LLAB1234567890/PCB-/reports/接线与固件契约.md

# 接线、控制意图与固件契约（未实施固件）

依据V3.2 2L原生针网，PCB SHA `7d6288a3e79992e387e95aa80c018b5a480a0d5dae67df03d6c3de5389c8f986`。

|端子|实际针序（顺序不能按名称猜）|

|---|---|

|J1|1: +24V_IN；2: GND|

|J13|1: +6V5_LIM_A；2: LIM_LC_RET|

|J14|1: +6V5_LIM_B；2: LIM_RC_RET|

|J15|1: +6V5_LIM_B；2: LIM_RO_RET|

|J18|1: +24V_CTRL；2: FUNC_BTN_RET；3: FUNC_LED_A；4: FUNC_LED_K|

|J19|1: +5V_MCU_FEED；2: +5V_MCU|

|J3|1: +6V5_LIM_A；2: LIM_LO_RET|

|U18|1: +5V_CTRL；2: MOTOR_PUL_N；3: +5V_CTRL|

|U19|1: MOTOR_DIR_N；2: +5V_CTRL；3: MOTOR_ENA_N|

|U20|1: MOTOR_ALM_RAW；2: GND|

|U21|1: +24V_CTRL；2: BTN_OPEN_SW|

|U22|1: +24V_CTRL；2: STOP_NC_RET|

|U23|1: +24V_CTRL；2: BTN_CLOSE_SW|

|U24|1: +24V_ESTOP_NC；2: GND|

|U30|1: +3V3；2: GND；3: I2C_SDA_EXT；4: I2C_SCL_EXT|

四路SS-01GL2使用COM/NC，LO/RO为OPEN边界，LC/RC为CLOSE边界；另一方向允许退离。NC打开不能区分触发和断线。两只备用不开第五/第六功能通道。

Gravity SEN0228的SDA/SCL/GND/VCC要与U30 VCC/GND/SDA/SCL逐针对应，使用3.3V；不能顺序直插。I2C100kHz，测总电容≤400pF、上升沿≤1µs和低电平，未知线长使用现场验收。

SET J18以自复位NO读取，NC未用端子绝缘。24V红灯电流20/50mA仅是建模包络；实物确认后填写。BZ1为内部5V有源KLJ-9650-5Y，30mA上界。

J16默认1–2接GND方向选择；J17默认1–2接3.3V报警选择。按实际驱动配置核验，CL1-42C报警PA4.01/PA4.31与ENA脱机极性须先低速/无机械负载测出；不得靠标签猜方向。

GST120A24-P1M控制支路给PCB；驱动正电源经板外K1 NO切断，驱动负极独立回源负极。相线及编码器接CL1-42C，不经过PCB。PUL/DIR/ENA采用板输出低侧与5V共阳极成对线束。

板外K1:Omron G2R-1-S DC24+P2RFZ-05-E，4COM、3NO、2NC未用、1/5线圈。电机5A支路0297005.WXMX+0FHM0001SXJ；线圈1A支路0287001.PXCN+0FHA0001ZXJ经急停NC控制K1.5与U24.1，K1.1独立回负极，SMBJ26CA线圈钳位。线圈约21.6mA/0.53W；容性输入冲击、真实分断/焊接与停止距离未验收。

GPIO初始化先禁止STEP、ARM保持LOW、灯和蜂鸣器按已定义默认值，再建立有效心跳、读取稳定监督和方向限位。新ARM LOW→HIGH后运动期间保持GPIO6 HIGH。STOP/故障/应用停更停止脉冲并清授权；恢复HIGH保持不得自动再ARM。

GPIO47心跳由应用控制任务维护，≤50ms更新/≤100ms有效下降沿；无独立硬件/ISR假健康。通信租约失效、状态陈旧或校准异常时停止喂狗。EN控制U45，不把WDT_OK接成直接ESP复位。

STEP≤100kHz、HIGH/LOW≥5µs；DIR setup≥10µs；ENA settle≥5ms。170～230ms看门狗时窗不是立即停机；任何位置不可信的截脉冲/掉电后回零或行程重新校准。

GPIO35–37供PSRAM，GPIO38板载RGB，GPIO19/20用于USB，GPIO0/3/45/46引导功能保留；实际44针CSV为权威针序。SET物理长按配对和行程校准的阈值/状态机尚未实现，不能伪称运行通过。

J19在使用普通USB供电前断开，避免双5V并联；带负载波形在U2.21对U2.22和本地3.3V量取。使用电源分配点承担驱动功率回流，布线远离电机相线。
