LLAB1234567890/PCB-/reports/样机测量步骤与判据.md

# V3.2 2L 样机测量步骤与判据

全部未执行。固件尚未编写，先实现“接线与固件契约.md”的启动、GPIO、STEP/DIR/HOLD、应用心跳及重新 ARM 行为，再记录“样机验收表.csv”。本文件给出可复核测量步骤，不把离线真值、热模型或厂商绝对最大值当作实测通过。

## 1. 装配、未上电与首电

按 CPL 的面/角度核对 pin1、D9/TVS/光耦/MOS/逻辑极性；确认 CASE_U1/U11/U33 相互与 GND 不短路。确认所有电源端子线序、NC COM接线、驱动 ALM 极性与 J16/J17 配置。检查底部支撑接触区、插件尾脚、USB 插头、按钮后端、2–3 mm垫片、螺丝啮合、工具通道；实测尺寸填表，不能用可调包络当已适配。

首次使用限流电源先只接控制支路，运动授权保持清除；由待机电流逐步提高限流值至实际负载需要，记录每级电流，不猜定额。分别测 U1 输入/输出、U2.21对U2.22、本地3.3 V 和 U41/U44 输出；再接外部驱动和线束。电机相线/编码器直接接 CL1-42C，驱动负极单独回电源分配点，不通过 PCB 信号地承担功率电流。普通 USB 供电前断开 J19，禁止双5 V并联。

## 2. 电源、监督与温升

示波器探头短地弹簧或差分测量，以本地地脚为参照；同时记录 U1.3、U2.21、本地3.3 V 的最小值、纹波及启动/无线/灯/蜂鸣器瞬态，记录输入电压与负载电流。需要测量 PCB 回流和 J19、D9、母座接触压降，不能只量正线。

0.5 A 是本轮计算包络，不是对实际 ESP32 峰值的承诺。实测电流、接触、温度和瞬态超出包络后重算 ../shared/DC_sheet_comparison.json 与工程报告中的电压预算。3.3 V 须处于实际器件推荐范围，正常工作时不得误触 U41/U44；检验整段低压波形及监督阈值/延时。SGM2212 的厂商 dropout 定义为95%输出，并不保证在“3.3 V + dropout”下精确3.3 V；以实测调节、3.3 V 余量及器件推荐规格判定。0.8 A组合最坏余量不足，不能直接放行。

在24℃、无强迫风、顶部朝上敞开、实际盒内装配和已记录压力下，测待机、较重无线及灯/蜂鸣器持续工况，持续到温度稳定并记录时间序列。记录 U1/D9/LDO/ESP热点、DevKit邻近空气、腔内空气和 PA12；DevKit合并模型温度不能代替模块邻近环境或结温。记录测温贴片/热电偶位置、辐射率和仪器误差。与六个模型工况使用相同负载/边界作比较；无法实现的压力条件注明，不能写成通过。按实测物性/接触/功率校准参考范围后再判断温度和工作寿命。

## 3. 行为与故障序列

首先低速、轻负载验证实际 OPEN/CLOSE 与 J16、驱动 DIR 配置一致；测 STEP HIGH/LOW≥5µs、DIR设置≥10µs、ENA稳定≥5ms 的契约并记录实际控制频率。逐一触发 STOP、四个NC各在两个方向断线、ALM、3.3 V/5 V欠压、EN复位、WDI恒HIGH、停止有效下降沿、应用停更及失联。每次记录 STEP、RUN_CLR_N、WDT_OK、ENA及电机响应。

当前方向的 NC 断线清授权，反方向退出允许；这不是四路全方向断线检测。普通STOP/看门狗在健康电源与急停状态下应停止脉冲并保留保持力；实际转矩必须测量。有效下降沿才喂看门狗；GPIO47由活跃控制任务更新，不能靠自动外设或独立定时中断掩盖应用停更。分别测170～230ms配置窗口、ENOUT异步响应和触点弹跳/传播延迟；不能用抽象事件模型声称立即停止。

所有能清授权的故障解除后，GPIO6持续HIGH不得自动恢复；先LOW，再新HIGH边沿才ARM。检查异步截短脉冲和方向切换，位置可信性丢失须重新回零/校准。急停实际切断 K1 主触点的驱动正电源，记录接点冲击电流、触点温升和停止距离；U24仅证明线圈命令，不证明触点已断开。掉电不能保证保持力，单通道 K1 不构成认证安全控制。

## 4. 线束与抗扰

记录实际线长、线型、走向、端接和是否邻近电机线。电机/编码器已知延长线1.5 m，其余最长线长以实装为准。PUL/DIR/ENA分别与共阳极供电返回成对布线，限位/I2C远离相线。控制器连续运行时重复驱动启停/换向及按钮/NC操作，捕获RESET、WDI、WDT_OK、PUL和输入波形；不得出现无命令脉冲、错误ARM或授权自行恢复。记录复位次数、总线错误、输入毛刺和观察周期。

I2C先用100 kHz，在实际最长线测SDA/SCL上升沿、低电平和有效电容；检查串联100Ω及拉电阻后的 tr≤1µs，并按实际器件VOL/VIL推荐限值核对。未知米数线束不能直接宣称兼容。插拔/布线靠近干扰源的试验只能说明所记录配置；标准ESD/EFT/辐射/传导试验的等级、接线和仪器需另定，未做则保持“未执行”，不宣称认证抗扰。
