LLAB1234567890/PCB-/manufacturing/Drill_report.txt

Drill report for CurtainDrive_V3_2_2L.kicad_pcb
Created on 2026-10-04T09:53:25

Copper Layer Stackup:
    =============================================================
    L1 :  F.Cu                      front
    L2 :  B.Cu                      back

Drill file 'CurtainDrive_V3_2_2L-PTH.drl' contains
    plated through holes:
    =============================================================
    T1  0.300mm  0.0118"  (484 holes))
    T2  0.400mm  0.0157"  (3 holes))
    T3  0.914mm  0.0360"  (44 holes))
    T4  0.950mm  0.0374"  (4 holes))
    T5  1.000mm  0.0394"  (8 holes))
    T6  1.100mm  0.0433"  (6 holes)  (with 6 slots)
    T7  1.200mm  0.0472"  (9 holes))
    T8  1.300mm  0.0512"  (4 holes))
    T9  1.400mm  0.0551"  (26 holes))

    Total plated holes count 588

Drill file 'CurtainDrive_V3_2_2L-NPTH.drl' contains
    unplated through holes:
    =============================================================
    T1  2.700mm  0.1063"  (6 holes))

    Total unplated holes count 6
