LLAB1234567890/PCB-/mechanical/Enclosure_assembly.step

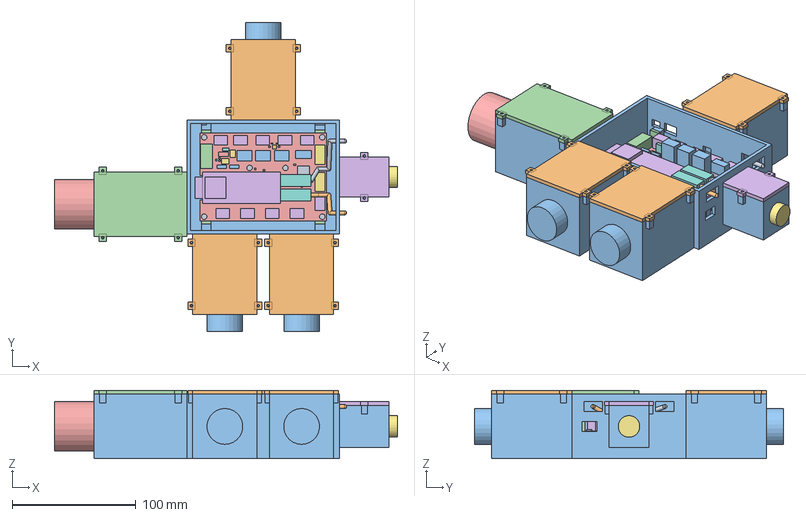
[picture p1: CAD file, 2026-10-04]
mechanical/Enclosure_assembly.step
277.3 x 250.1 x 55.1 mm
