LLAB1234567890/PCB-/mechanical/PA12_Main_and_pods.step

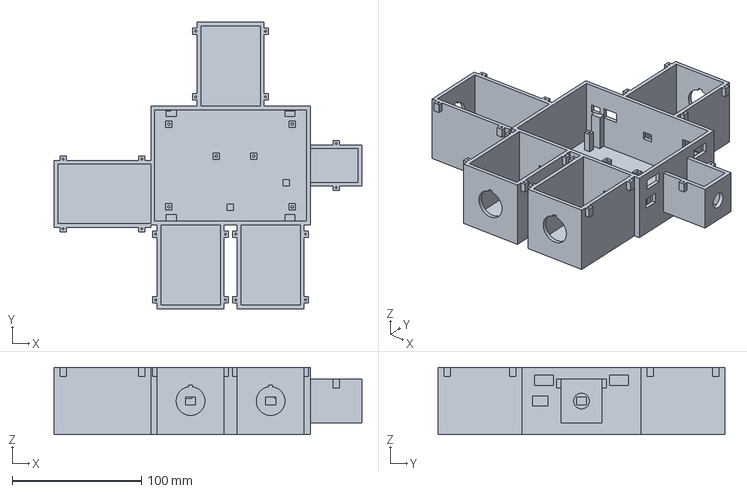
[picture p2: CAD file, 2026-10-04]
mechanical/PA12_Main_and_pods.step
238.5 x 222.1 x 52.1 mm
