LLAB1234567890/PCB-/mechanical/Lid_ESTOP.step

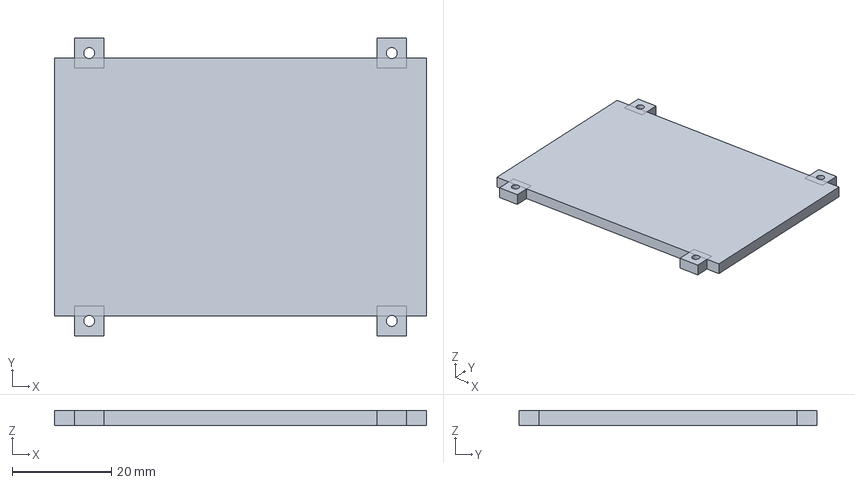
[picture p3: CAD file, 2026-10-04]
mechanical/Lid_ESTOP.step
75.0 x 60.0 x 3.00 mm
