LLAB1234567890/PCB-/mechanical/Lid_CLOSE.step

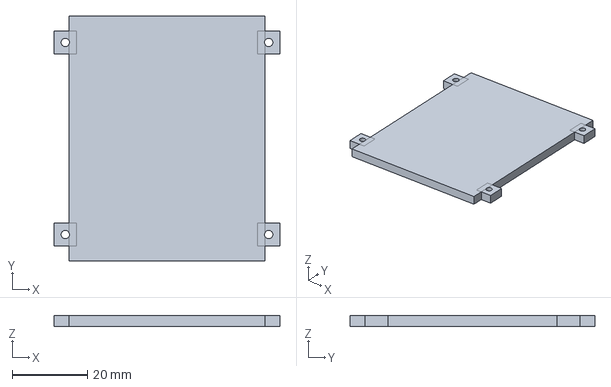
[picture p4: CAD file, 2026-10-04]
mechanical/Lid_CLOSE.step
60.0 x 65.0 x 3.00 mm
