LLAB1234567890/PCB-/mechanical/Lid_SET.step

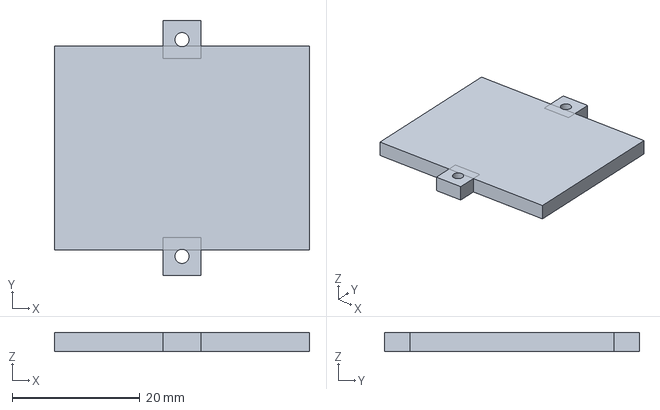
[picture p5: CAD file, 2026-10-04]
mechanical/Lid_SET.step
40.0 x 40.0 x 3.00 mm
