LLAB1234567890/PCB-/(list of files, cad)

Other CAD files:
mechanical/CurtainDrive_V3_2_2L_Enclosure.FCStd
mechanical/Lid_STOP.step
mechanical/Lid_OPEN.step
mechanical/Lid_CLOSE.stl
mechanical/Lid_ESTOP.stl
mechanical/Lid_OPEN.stl
mechanical/Lid_SET.stl
mechanical/Lid_STOP.stl
mechanical/PA12_Main_and_pods.stl
