LLAB1234567890/PCB-/manufacturing/下单层数与铜重说明.md

# 当前制造参数

双层：1.6mm名义厚度；顶/底铜各1oz，35µm为计算名义值。保持V3.1电路、双面贴装和插件装配方案。不能混用四层Gerber。

制造包按实际层数、铜层、孔槽、坐标及BOM/CPL逐一回读。SMT130件、手装/模块21件；板外动力支路与K1器件另列，不包含在贴装坐标。下单前仍需工厂库pin1/旋转预览和库存确认、服务跳帽实物采购及样机电气验收。

[嘉立创官方叠层](https://jlcpcb.com/impedance)；[铜重与成品厚度解释](https://jlcpcb.com/help/article/multi-layer-pcb-standard-laminated-structures)
