LLAB1234567890/PCB-/schematic/CurtainDrive_V3_2_2L.pdf

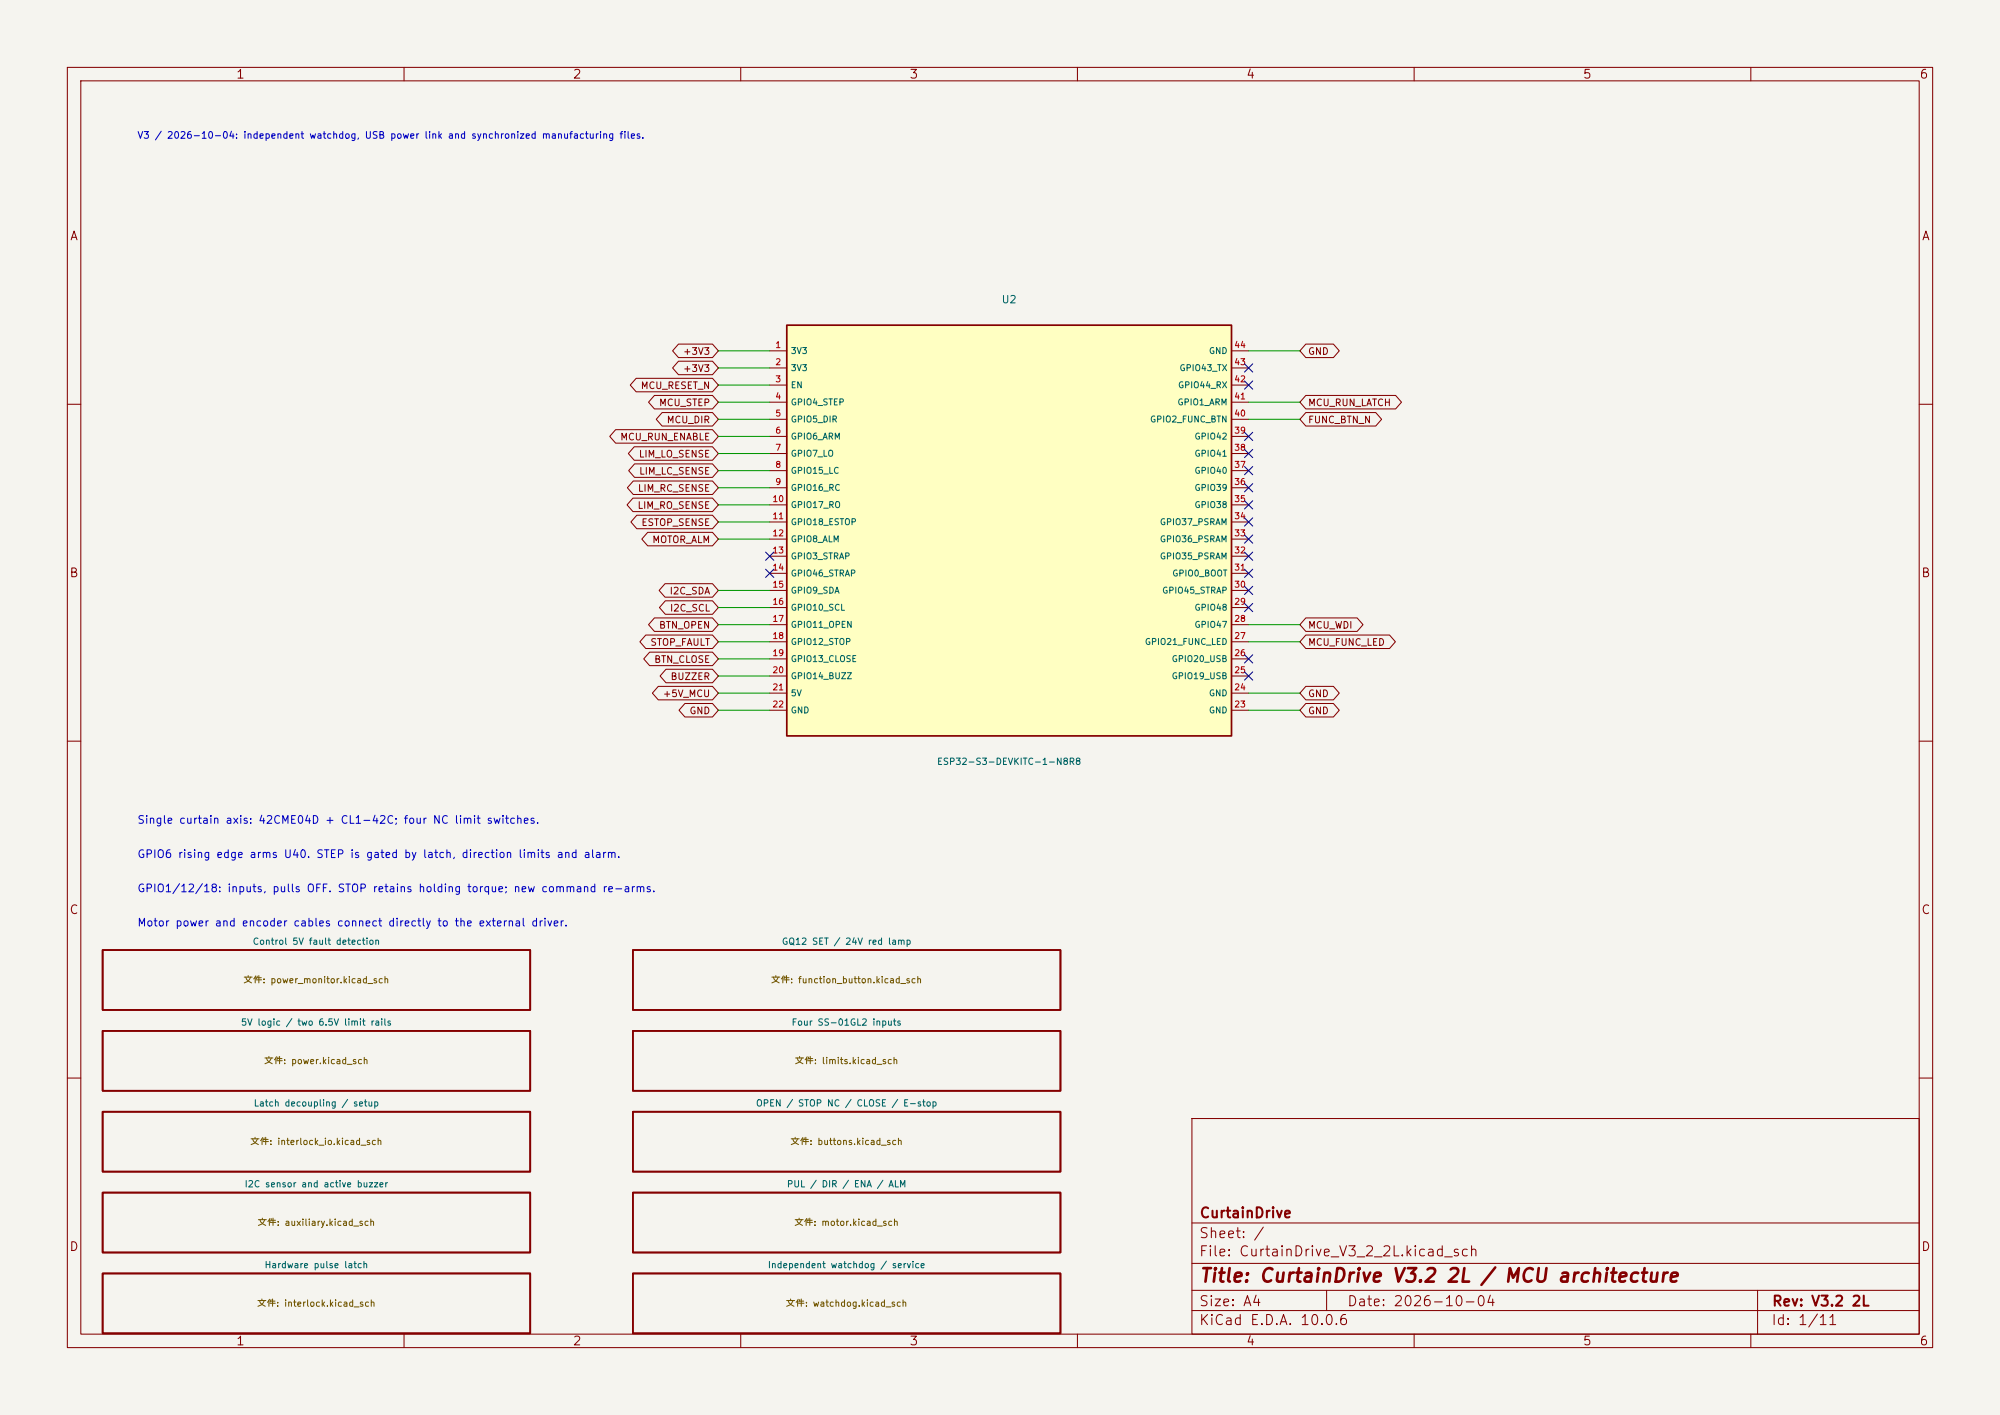
[picture p6: page 1]

V3 / 2026-10-04: independent watchdog, USB power link and synchronized manufacturing files. GPIO1/12/18: inputs, pulls OFF. STOP retains holding torque; new command re-arms. Single curtain axis: 42CME04D + CL1-42C; four NC limit switches. Motor power and encoder cables connect directly to the external driver.

LIM_LO_SENSE GPIO6 rising edge arms U40. STEP is gated by latch, direction limits and alarm.

Independent watchdog / service 文件: watchdog.kicad_sch PUL / DIR / ENA / ALM 文件: motor.kicad_sch Control 5V fault detection 文件: power_monitor.kicad_sch 5V logic / two 6.5V limit rails 文件: power.kicad_sch

Four SS-01GL2 inputs 文件: limits.kicad_sch OPEN / STOP NC / CLOSE / E-stop 文件: buttons.kicad_sch Hardware pulse latch 文件: interlock.kicad_sch

Latch decoupling / setup 文件: interlock_io.kicad_sch

Size: A4 | Rev: V3.2 2L
KiCad E.D.A. 10.0.6 | Id: 1/11

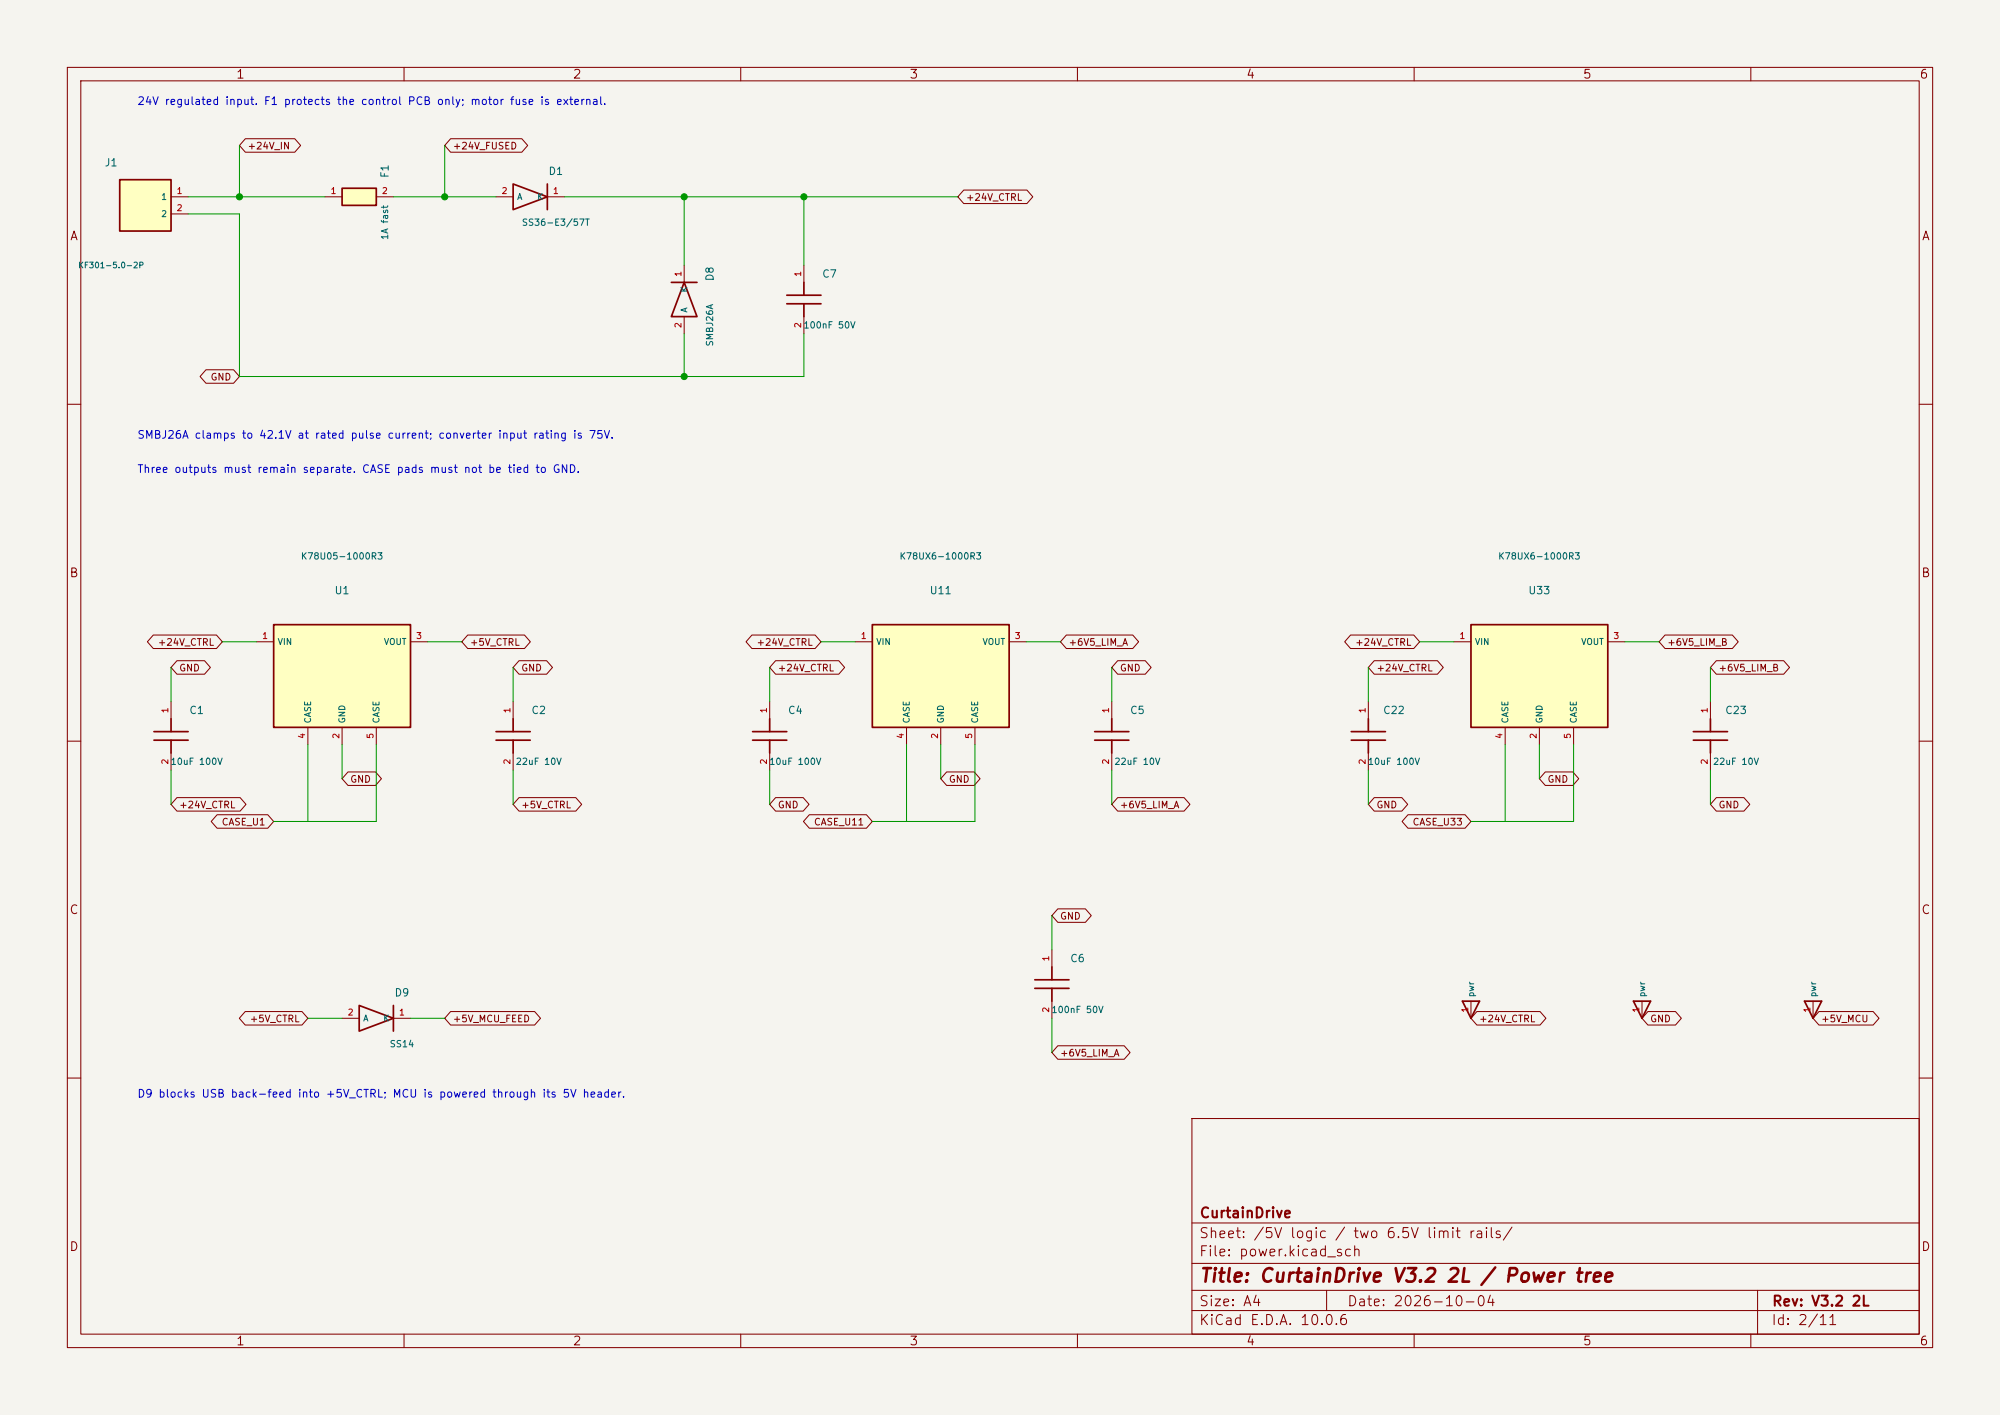
[picture p7: page 2]

SMBJ26A clamps to 42.1V at rated pulse current; converter input rating is 75V. Three outputs must remain separate. CASE pads must not be tied to GND. 24V regulated input. F1 protects the control PCB only; motor fuse is external.

A 2 D8 SMBJ26A GND +6V5_LIM_A +6V5_LIM_A GND +5V_CTRL +5V_MCU_FEED +6V5_LIM_B +6V5_LIM_B +6V5_LIM_A +5V_CTRL +5V_CTRL GND GND GND +5V_MCU

GND +24V_CTRL +24V_CTRL CASE_U33 D9 blocks USB back-feed into +5V_CTRL; MCU is powered through its 5V header.

CurtainDrive
Sheet: /5V logic / two 6.5V limit rails/
File: power.kicad_sch
Title: CurtainDrive V3.2 2L / Power tree

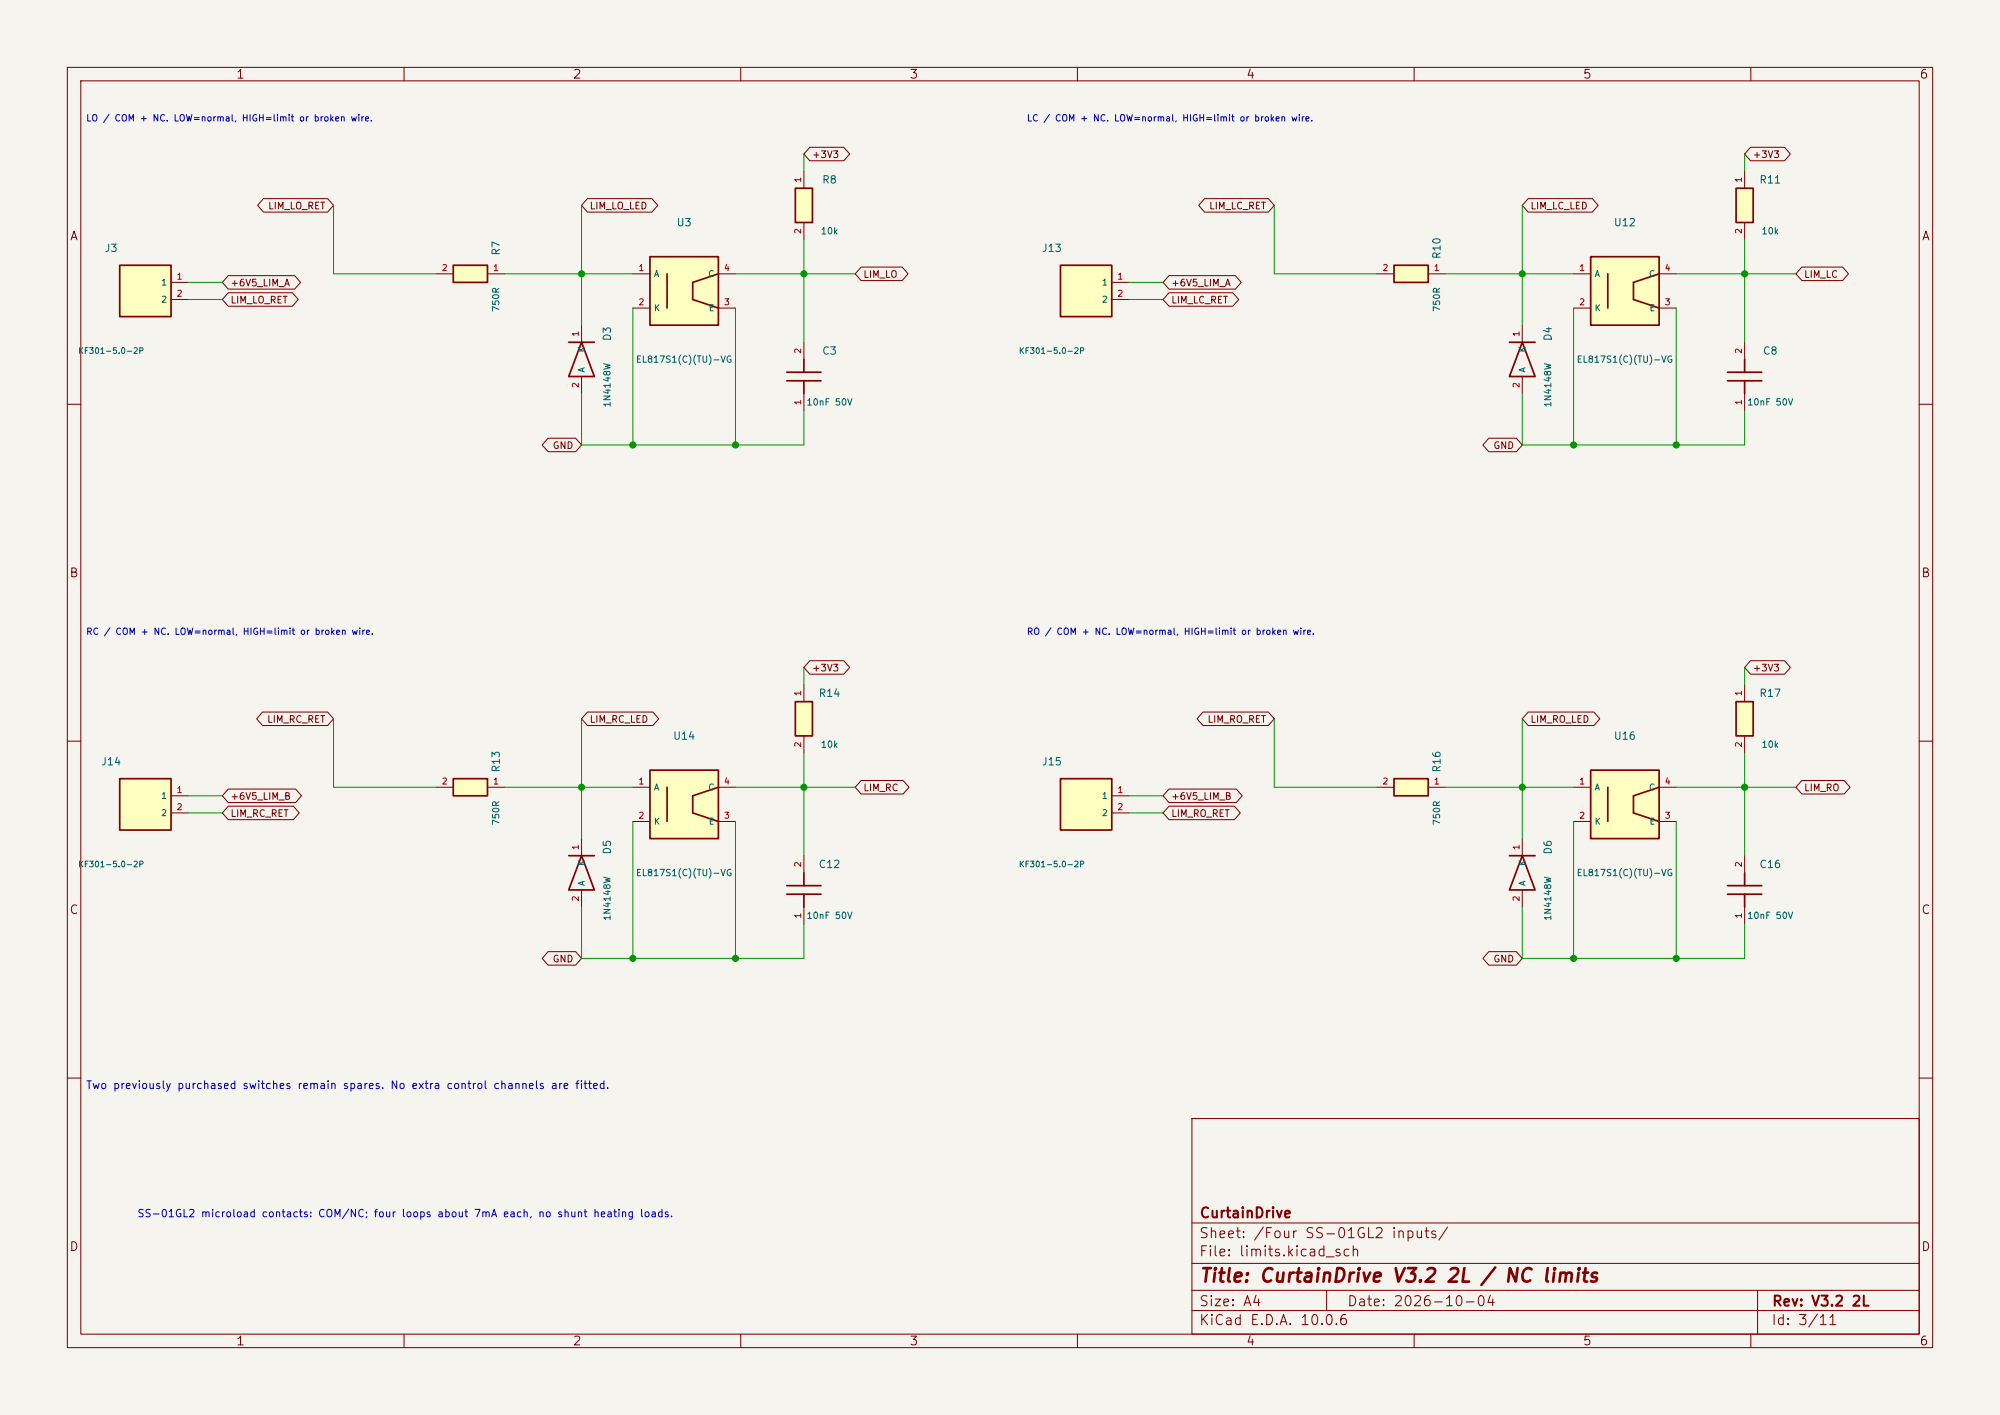
[picture p8: page 3]

LIM_LO_RET LIM_RC_RET SS-01GL2 microload contacts: COM/NC; four loops about 7mA each, no shunt heating loads. Two previously purchased switches remain spares. No extra control channels are fitted.

CurtainDrive
Sheet: /Four SS-01GL2 inputs/
File: limits.kicad_sch
Title: CurtainDrive V3.2 2L / NC limits

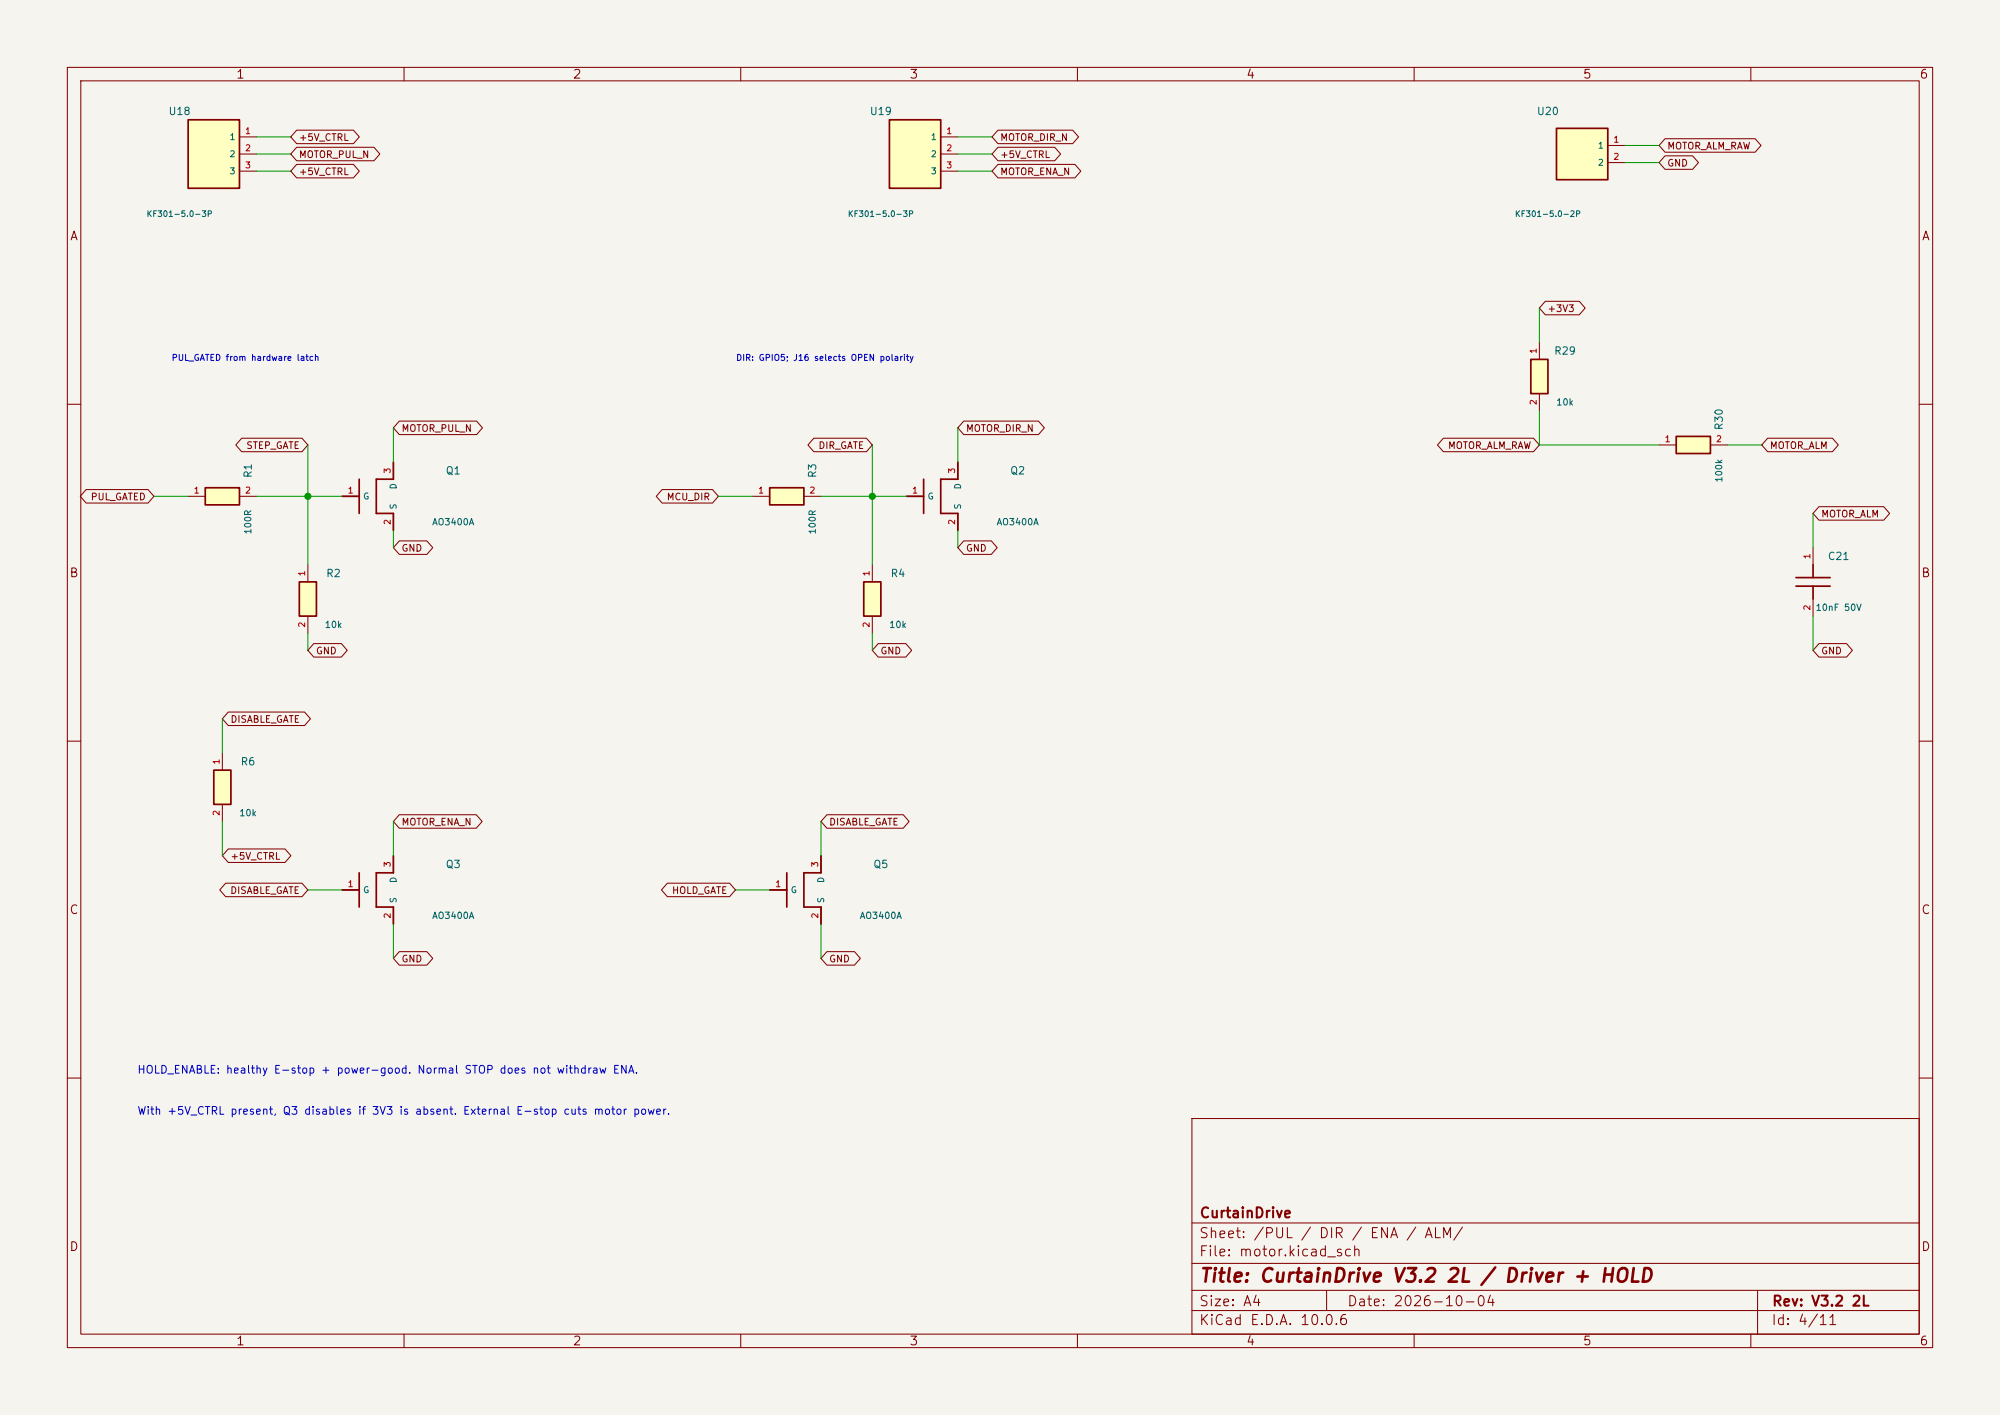
[picture p9: page 4]

PUL_GATED from hardware latch With +5V_CTRL present, Q3 disables if 3V3 is absent. External E-stop cuts motor power. HOLD_ENABLE: healthy E-stop + power-good. Normal STOP does not withdraw ENA.

DIR: GPIO5; J16 selects OPEN polarity

CurtainDrive
Sheet: /PUL / DIR / ENA / ALM/
File: motor.kicad_sch
Title: CurtainDrive V3.2 2L / Driver + HOLD

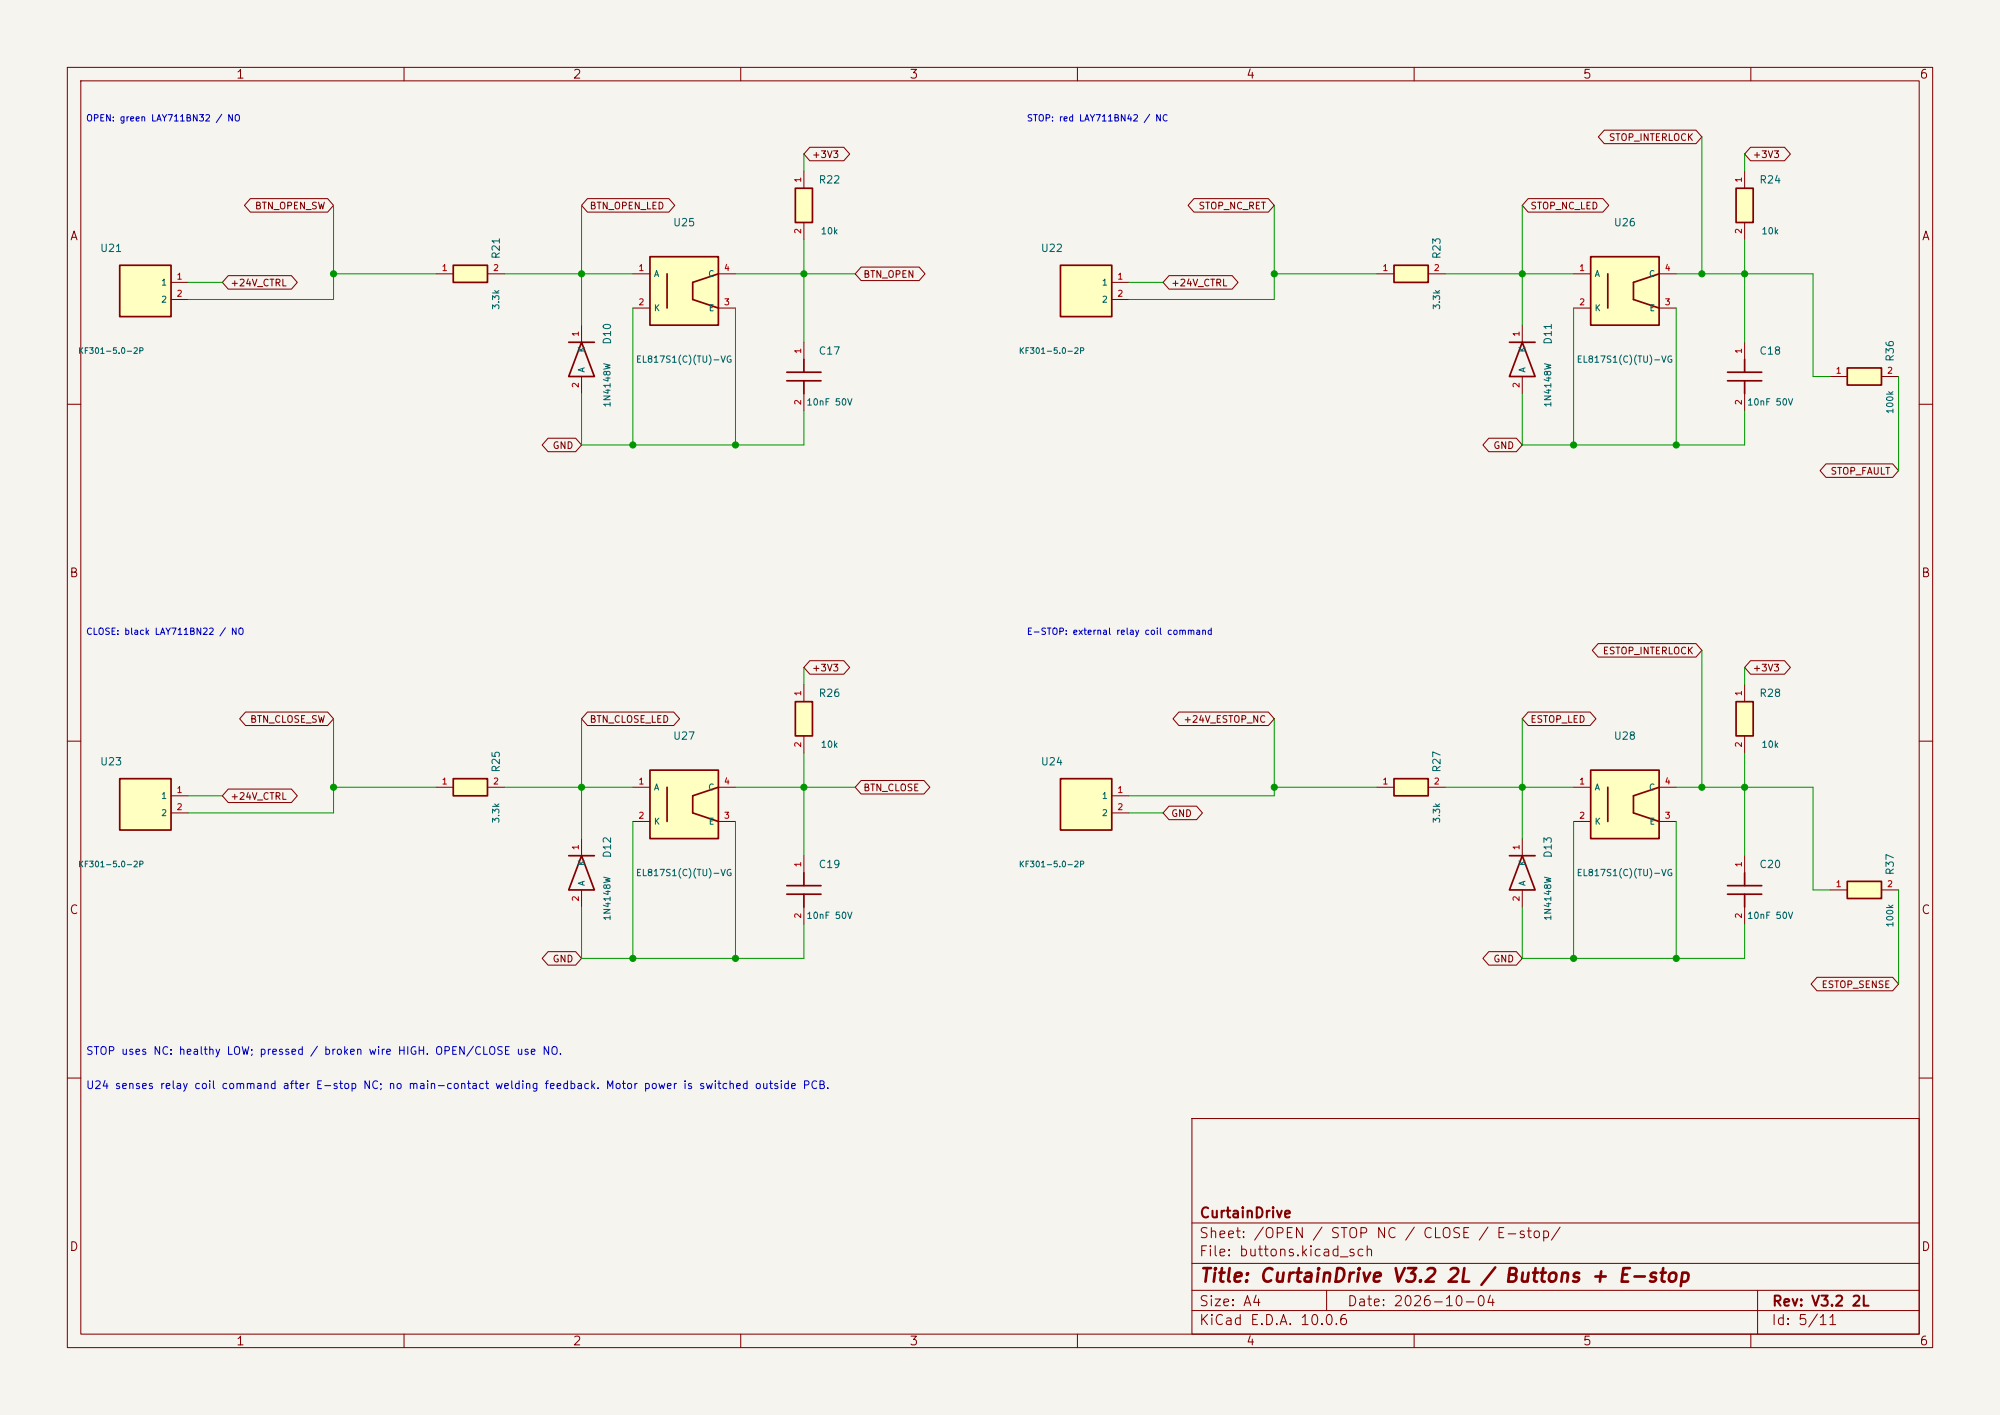
[picture p10: page 5]

E-STOP: external relay coil command

STOP uses NC: healthy LOW; pressed / broken wire HIGH. OPEN/CLOSE use NO. U24 senses relay coil command after E-stop NC; no main-contact welding feedback. Motor power is switched outside PCB.

CurtainDrive
Sheet: /OPEN / STOP NC / CLOSE / E-stop/
File: buttons.kicad_sch
Title: CurtainDrive V3.2 2L / Buttons + E-stop

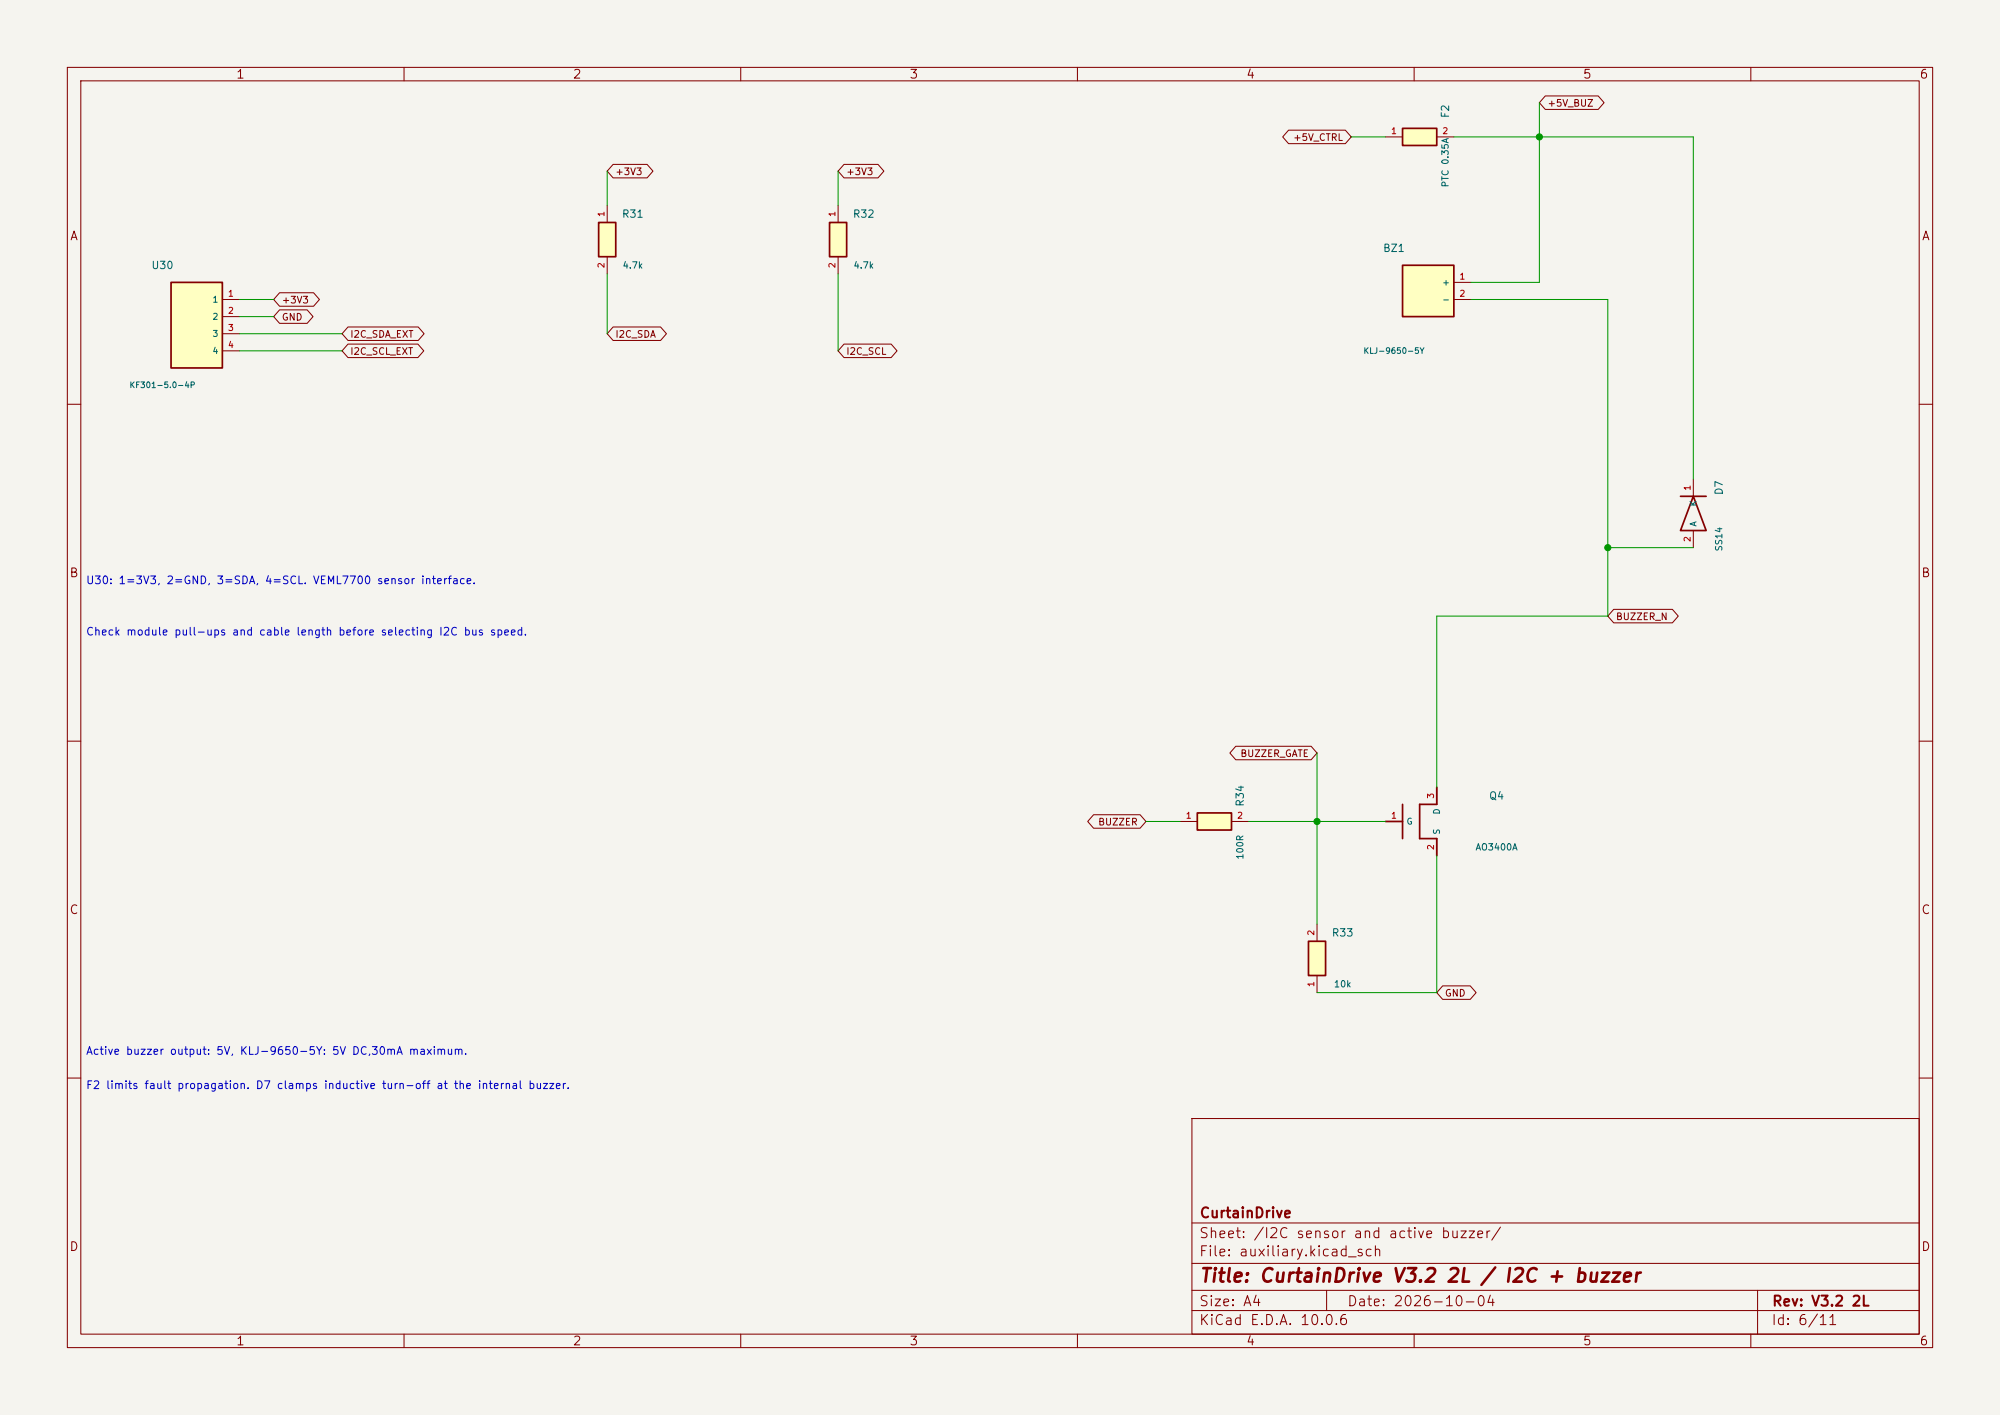
[picture p11: page 6]

BUZZER_GATE U30: 1=3V3, 2=GND, 3=SDA, 4=SCL. VEML7700 sensor interface. F2 limits fault propagation. D7 clamps inductive turn-off at the internal buzzer. Active buzzer output: 5V, KLJ-9650-5Y: 5V DC,30mA maximum. Check module pull-ups and cable length before selecting I2C bus speed.

CurtainDrive
Sheet: /I2C sensor and active buzzer/
File: auxiliary.kicad_sch
Title: CurtainDrive V3.2 2L / I2C + buzzer

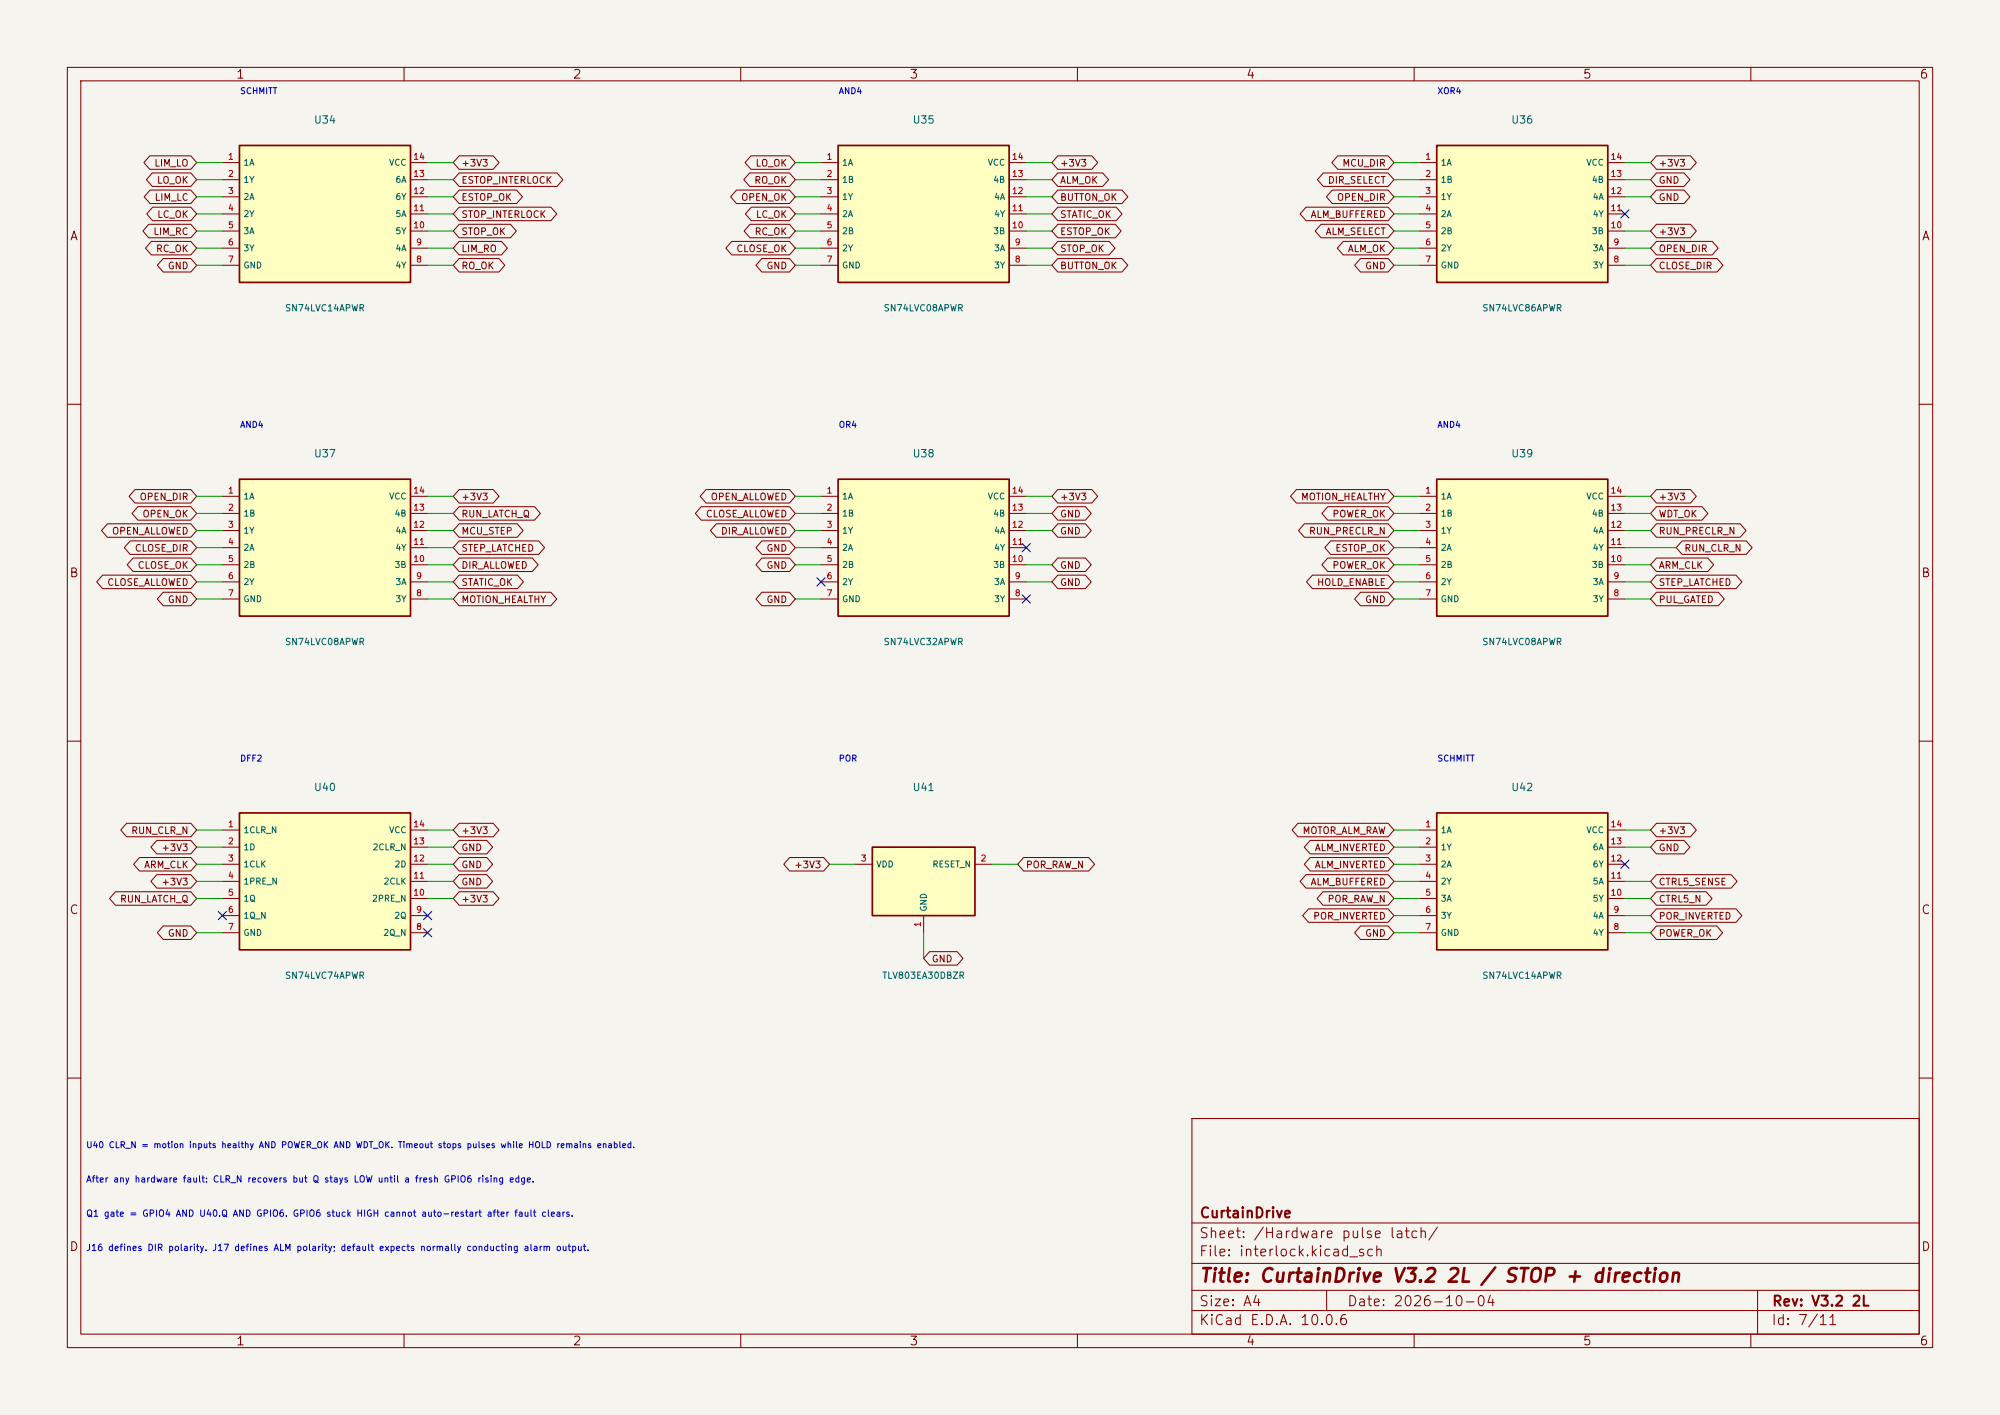
[picture p12: page 7]

After any hardware fault: CLR_N recovers but Q stays LOW until a fresh GPIO6 rising edge. Q1 gate = GPIO4 AND U40.Q AND GPIO6. GPIO6 stuck HIGH cannot auto-restart after fault clears.

CurtainDrive
Sheet: /Hardware pulse latch/
File: interlock.kicad_sch
Title: CurtainDrive V3.2 2L / STOP + direction

J16 defines DIR polarity. J17 defines ALM polarity; default expects normally conducting alarm output.

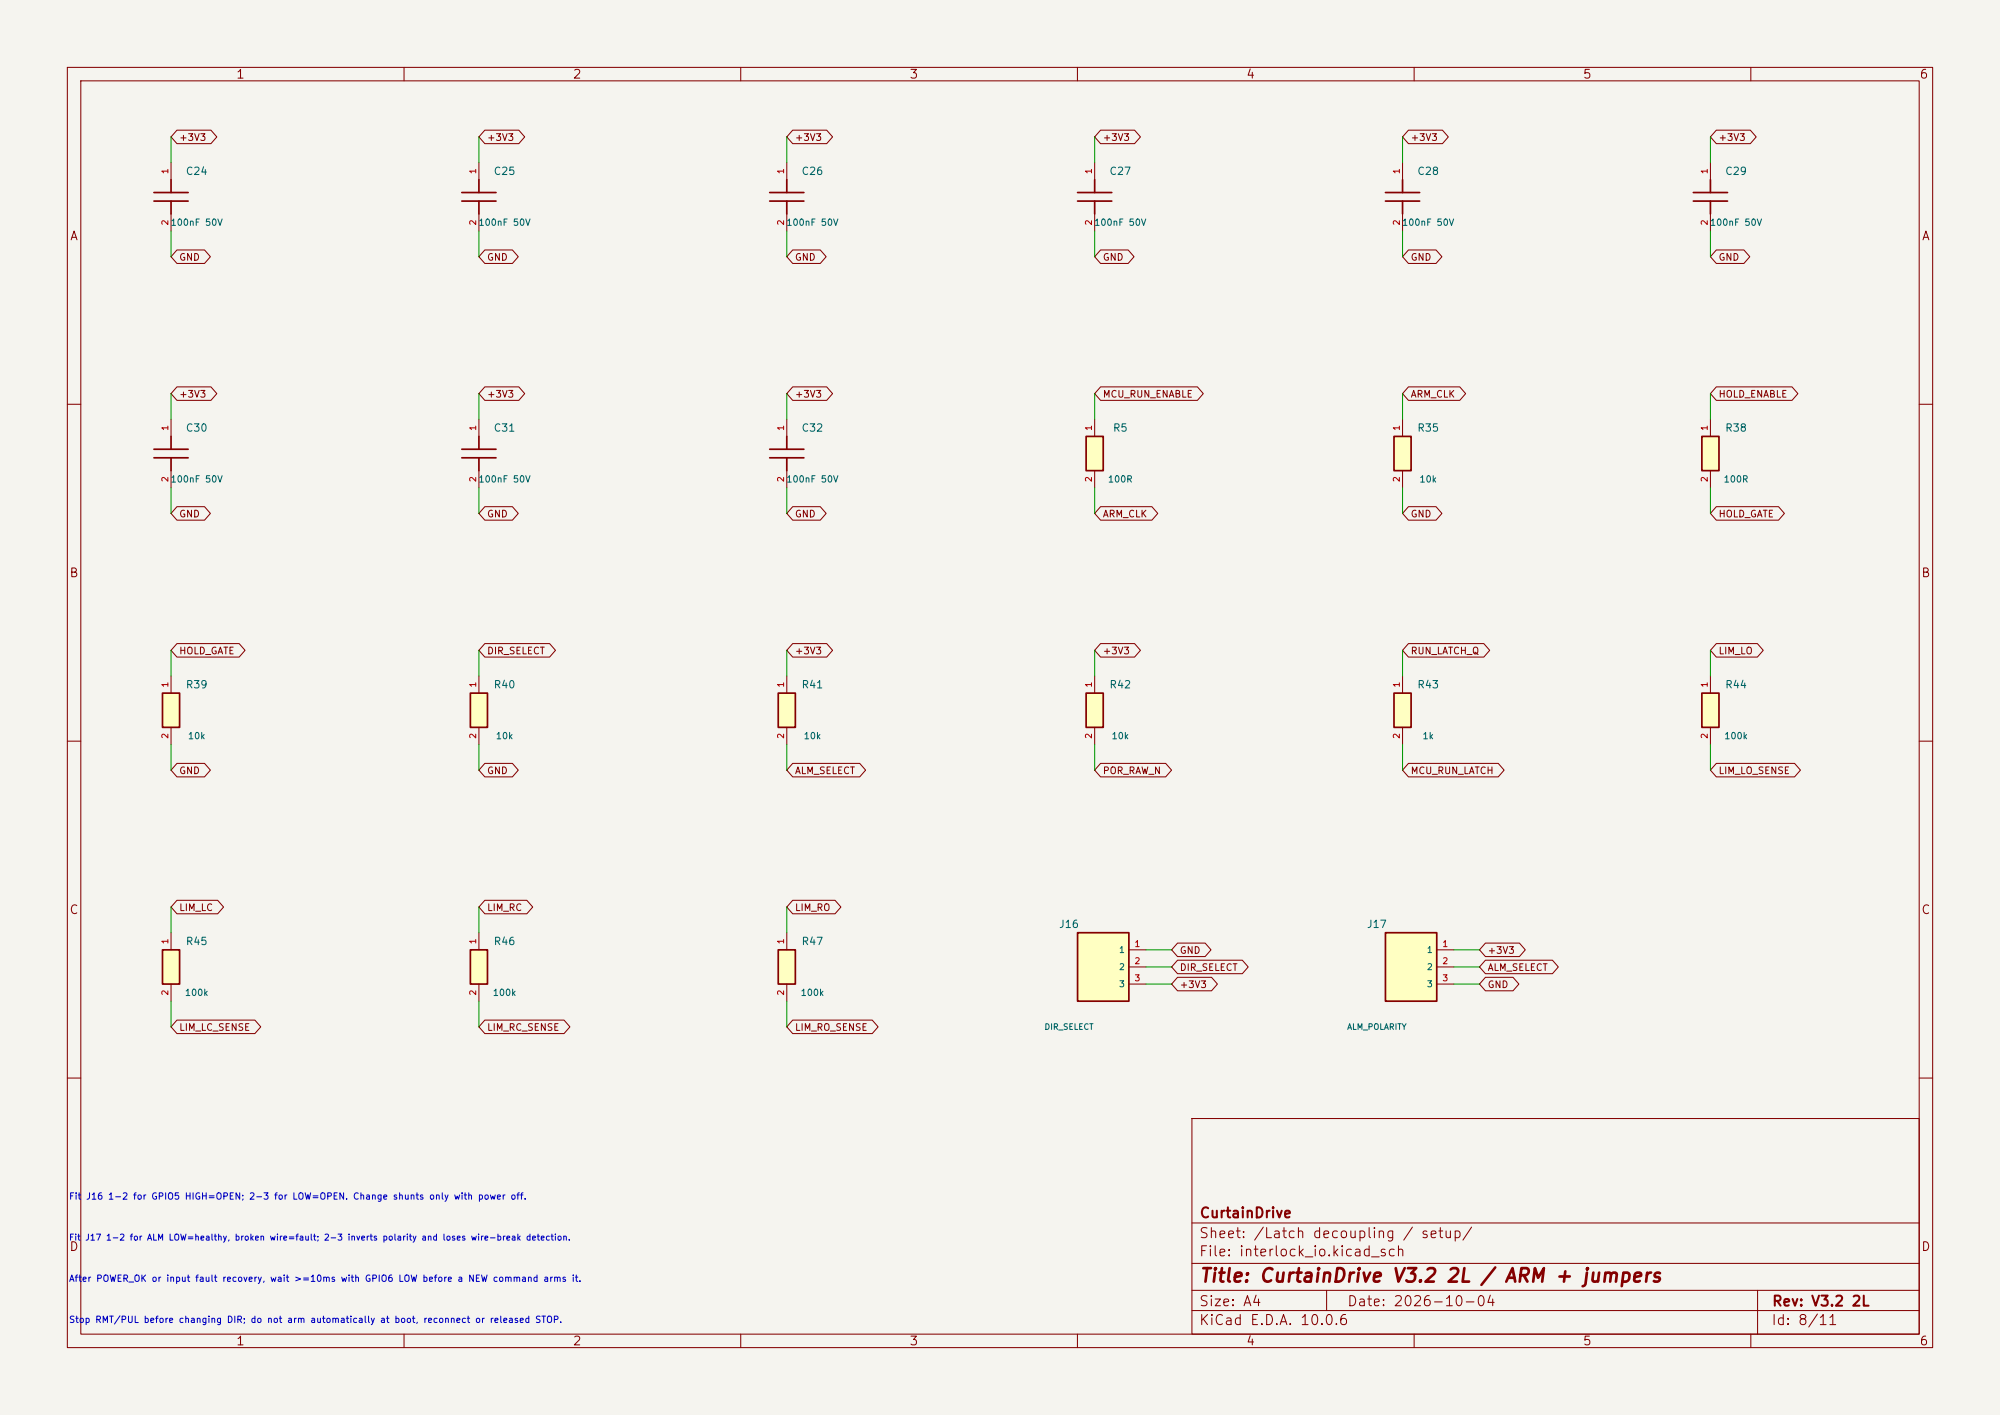
[picture p13: page 8]

After POWER_OK or input fault recovery, wait >=10ms with GPIO6 LOW before a NEW command arms it. Fit J17 1-2 for ALM LOW=healthy, broken wire=fault; 2-3 inverts polarity and loses wire-break detection. Fit J16 1-2 for GPIO5 HIGH=OPEN; 2-3 for LOW=OPEN. Change shunts only with power off. Stop RMT/PUL before changing DIR; do not arm automatically at boot, reconnect or released STOP.

CurtainDrive
Sheet: /Latch decoupling / setup/
File: interlock_io.kicad_sch
Title: CurtainDrive V3.2 2L / ARM + jumpers

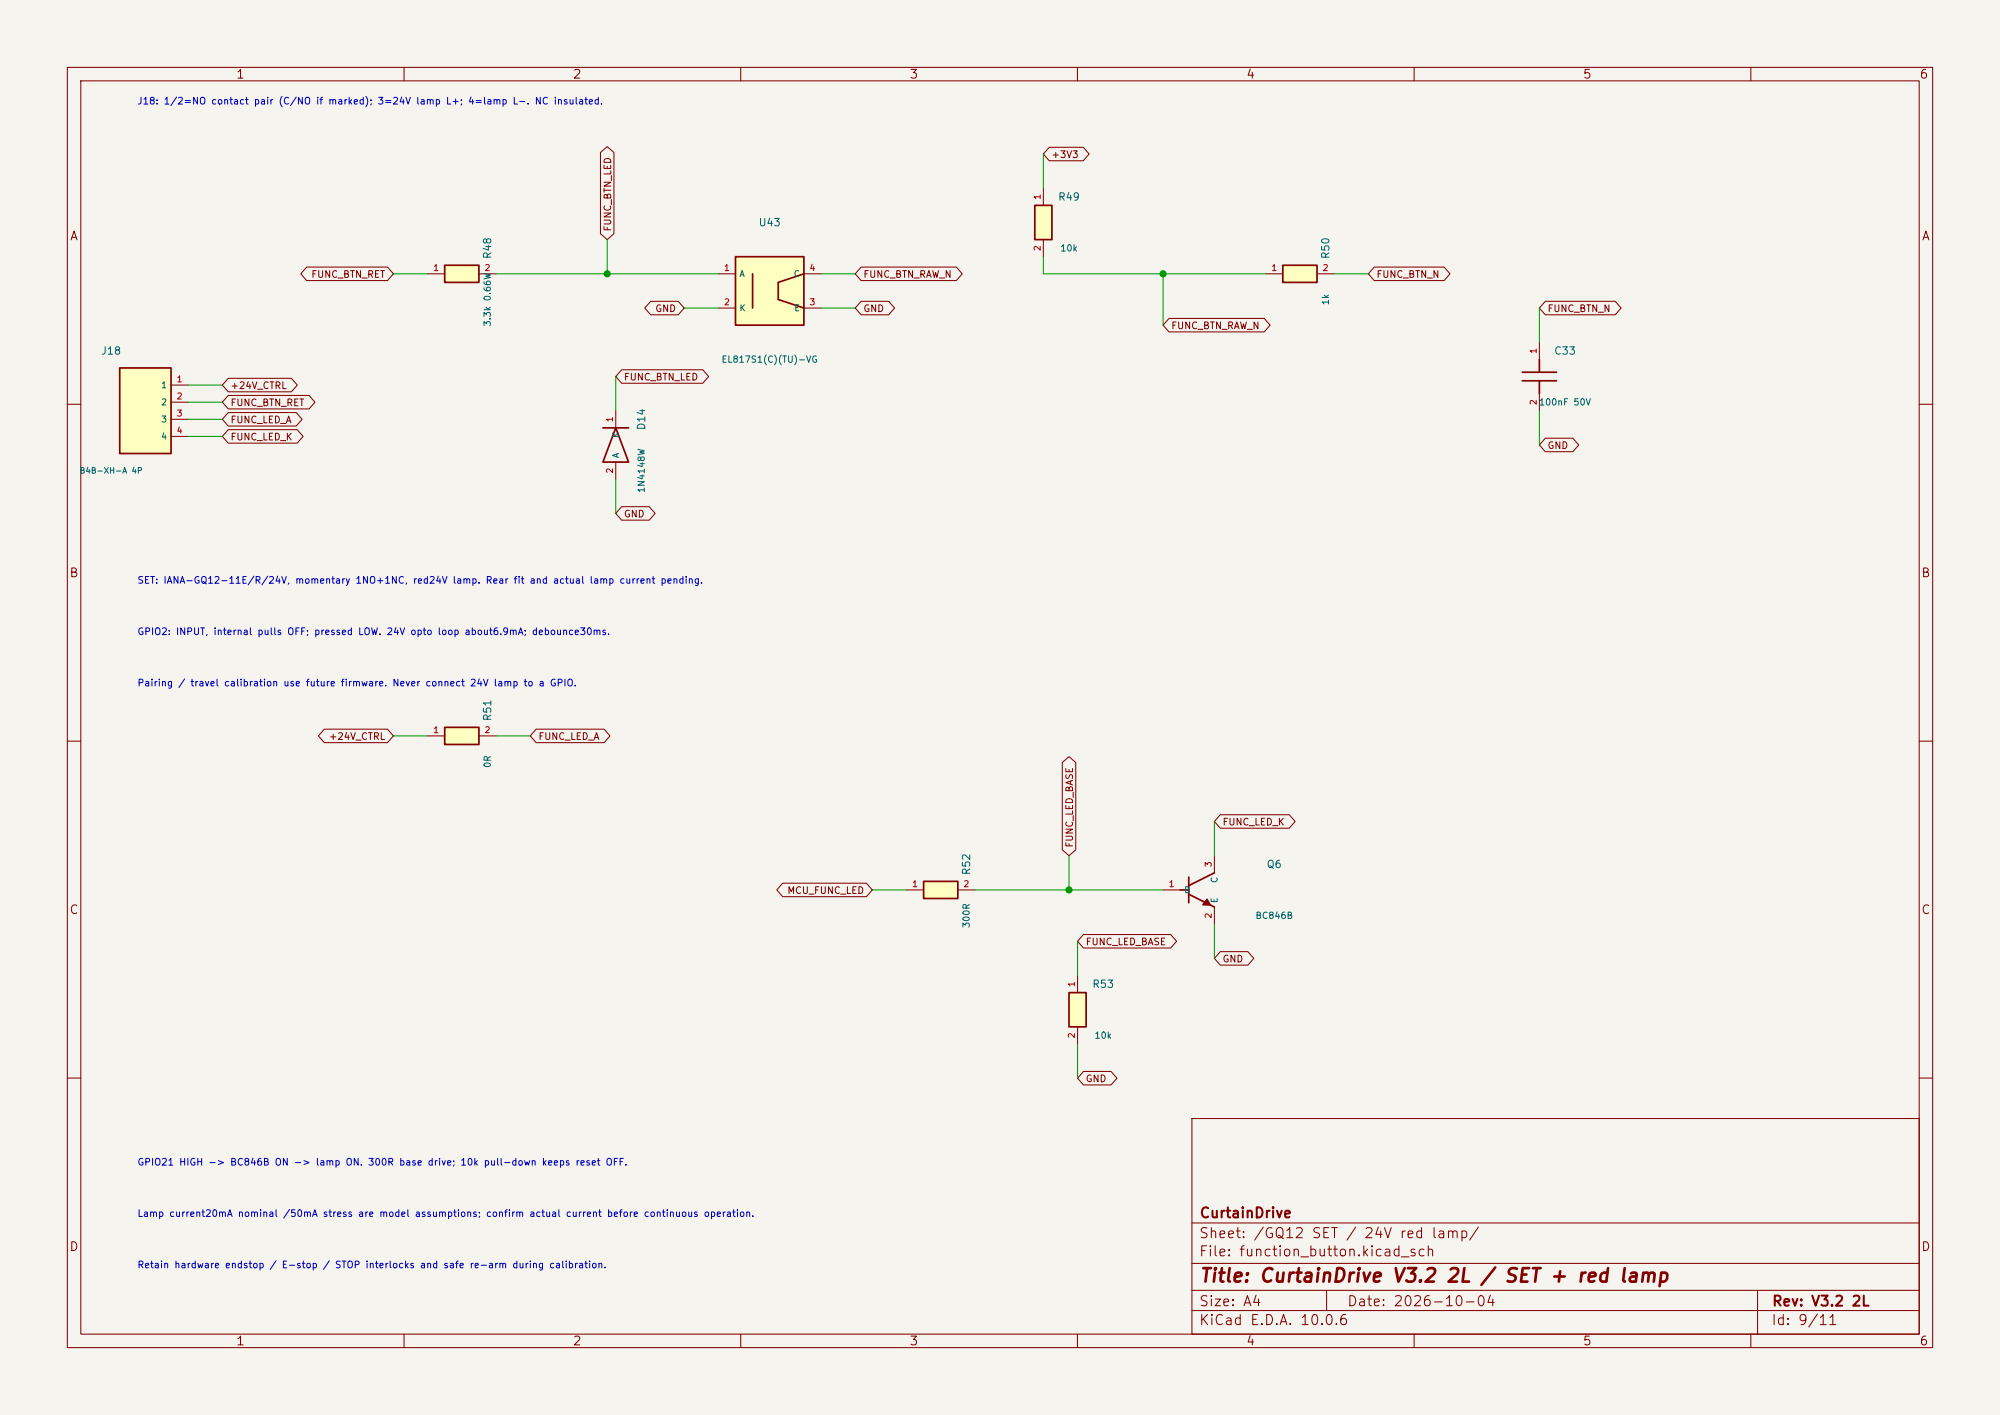
[picture p14: page 9]

J18: 1/2=NO contact pair (C/NO if marked); 3=24V lamp L+; 4=lamp L-. NC insulated. Pairing / travel calibration use future firmware. Never connect 24V lamp to a GPIO. Lamp current20mA nominal /50mA stress are model assumptions; confirm actual current before continuous operation. Retain hardware endstop / E-stop / STOP interlocks and safe re-arm during calibration.

GPIO2: INPUT, internal pulls OFF; pressed LOW. 24V opto loop about6.9mA; debounce30ms. SET: IANA-GQ12-11E/R/24V, momentary 1NO+1NC, red24V lamp. Rear fit and actual lamp current pending. GPIO21 HIGH -> BC846B ON -> lamp ON. 300R base drive; 10k pull-down keeps reset OFF.

CurtainDrive
Sheet: /GQ12 SET / 24V red lamp/
File: function_button.kicad_sch
Title: CurtainDrive V3.2 2L / SET + red lamp

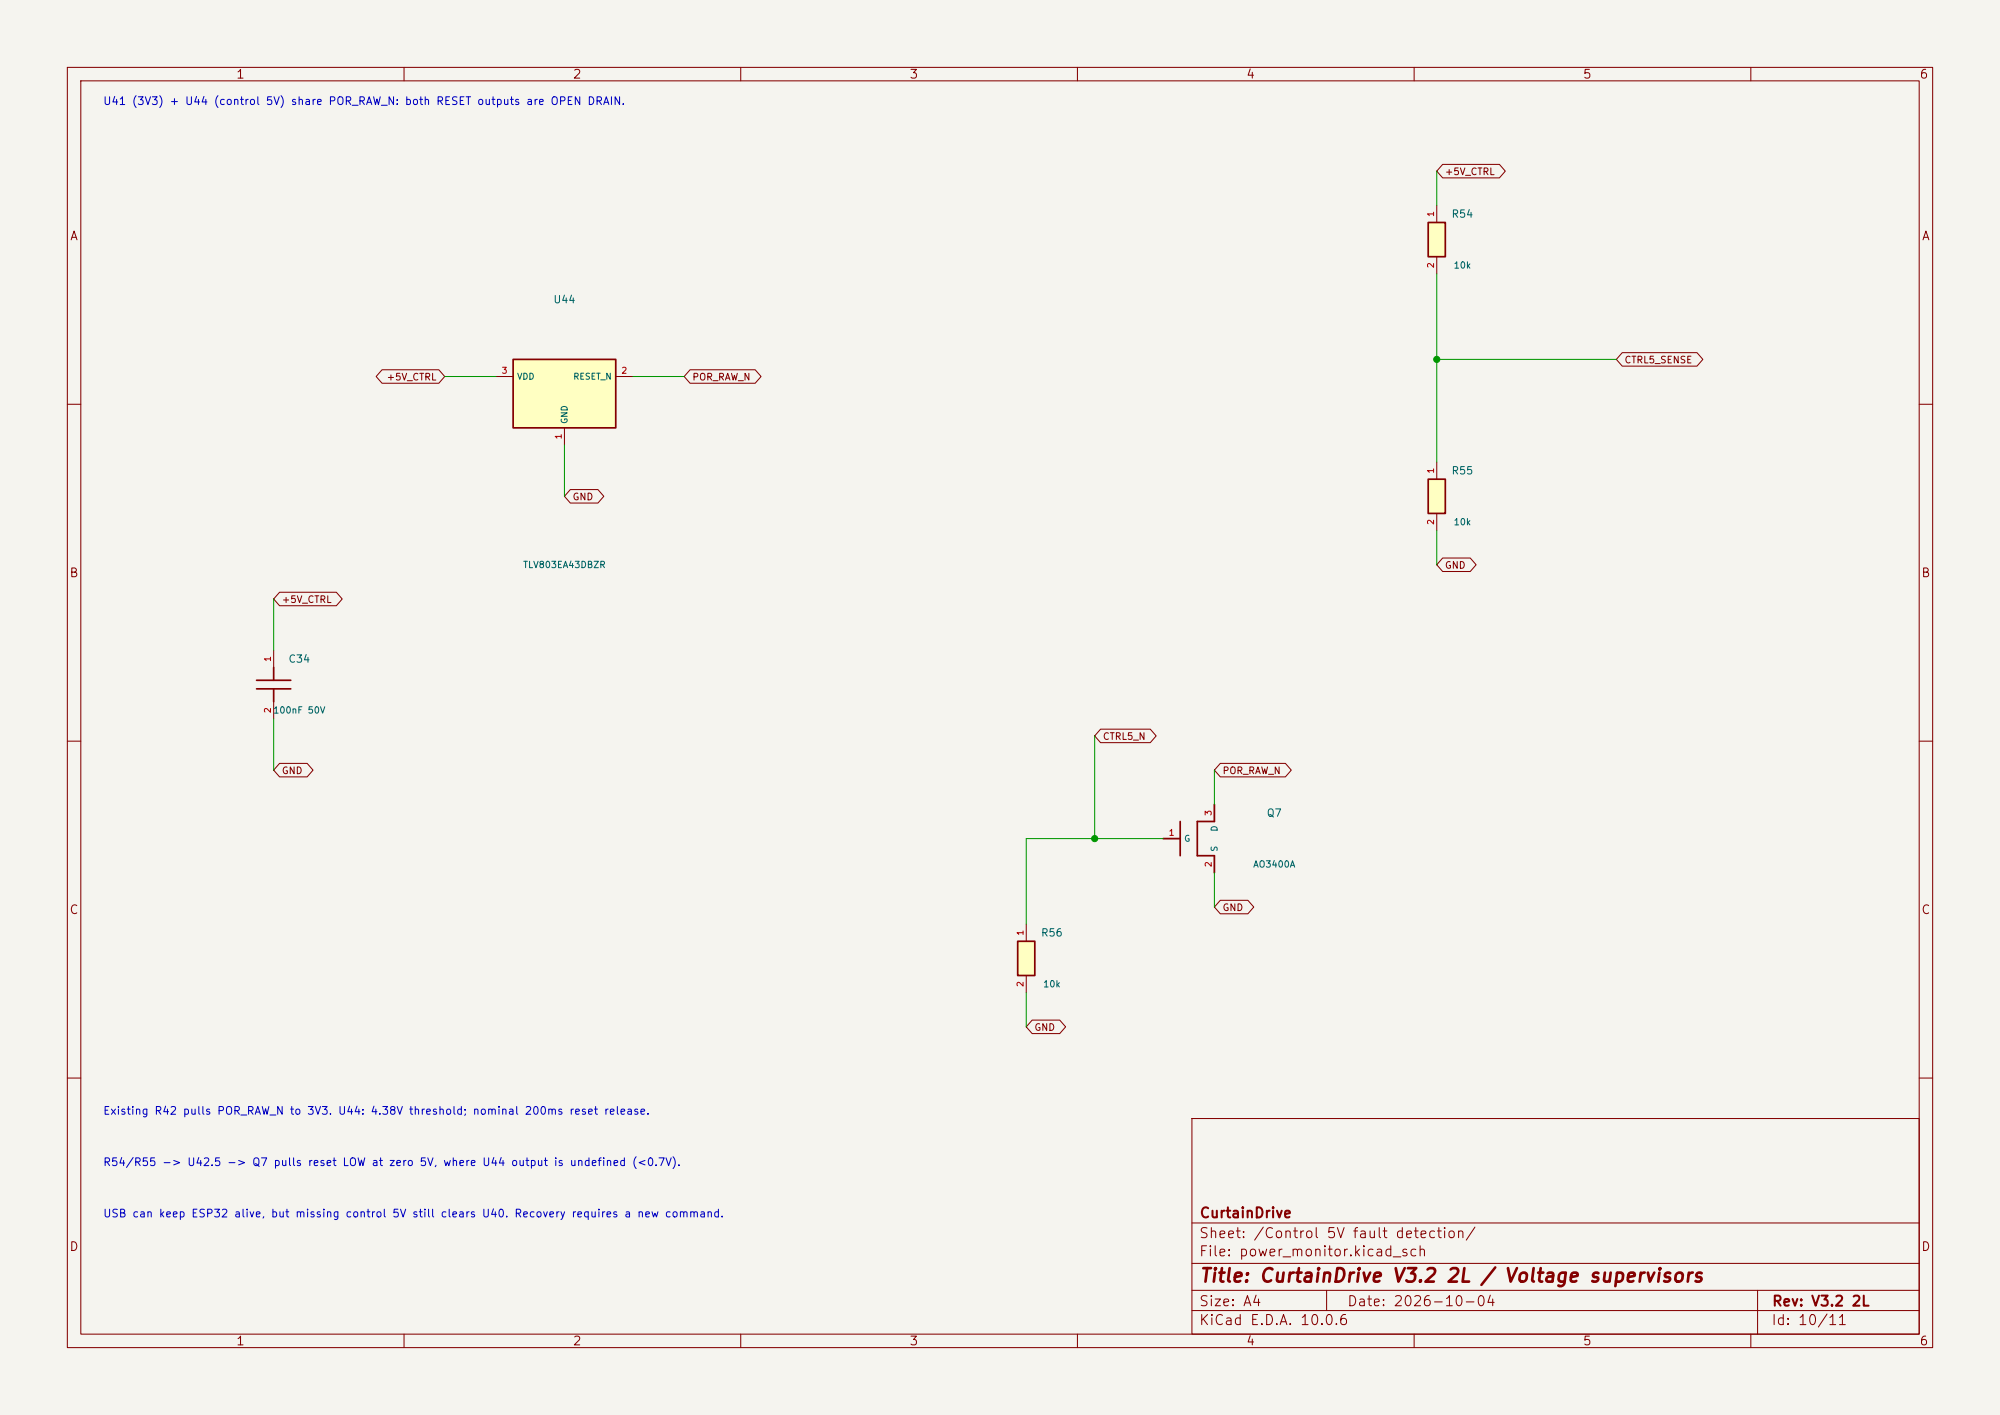
[picture p15: page 10]

U41 (3V3) + U44 (control 5V) share POR_RAW_N: both RESET outputs are OPEN DRAIN.

CTRL5_N R54/R55 -> U42.5 -> Q7 pulls reset LOW at zero 5V, where U44 output is undefined (<0.7V). USB can keep ESP32 alive, but missing control 5V still clears U40. Recovery requires a new command. Existing R42 pulls POR_RAW_N to 3V3. U44: 4.38V threshold; nominal 200ms reset release.

CurtainDrive
Sheet: /Control 5V fault detection/
File: power_monitor.kicad_sch
Title: CurtainDrive V3.2 2L / Voltage supervisors

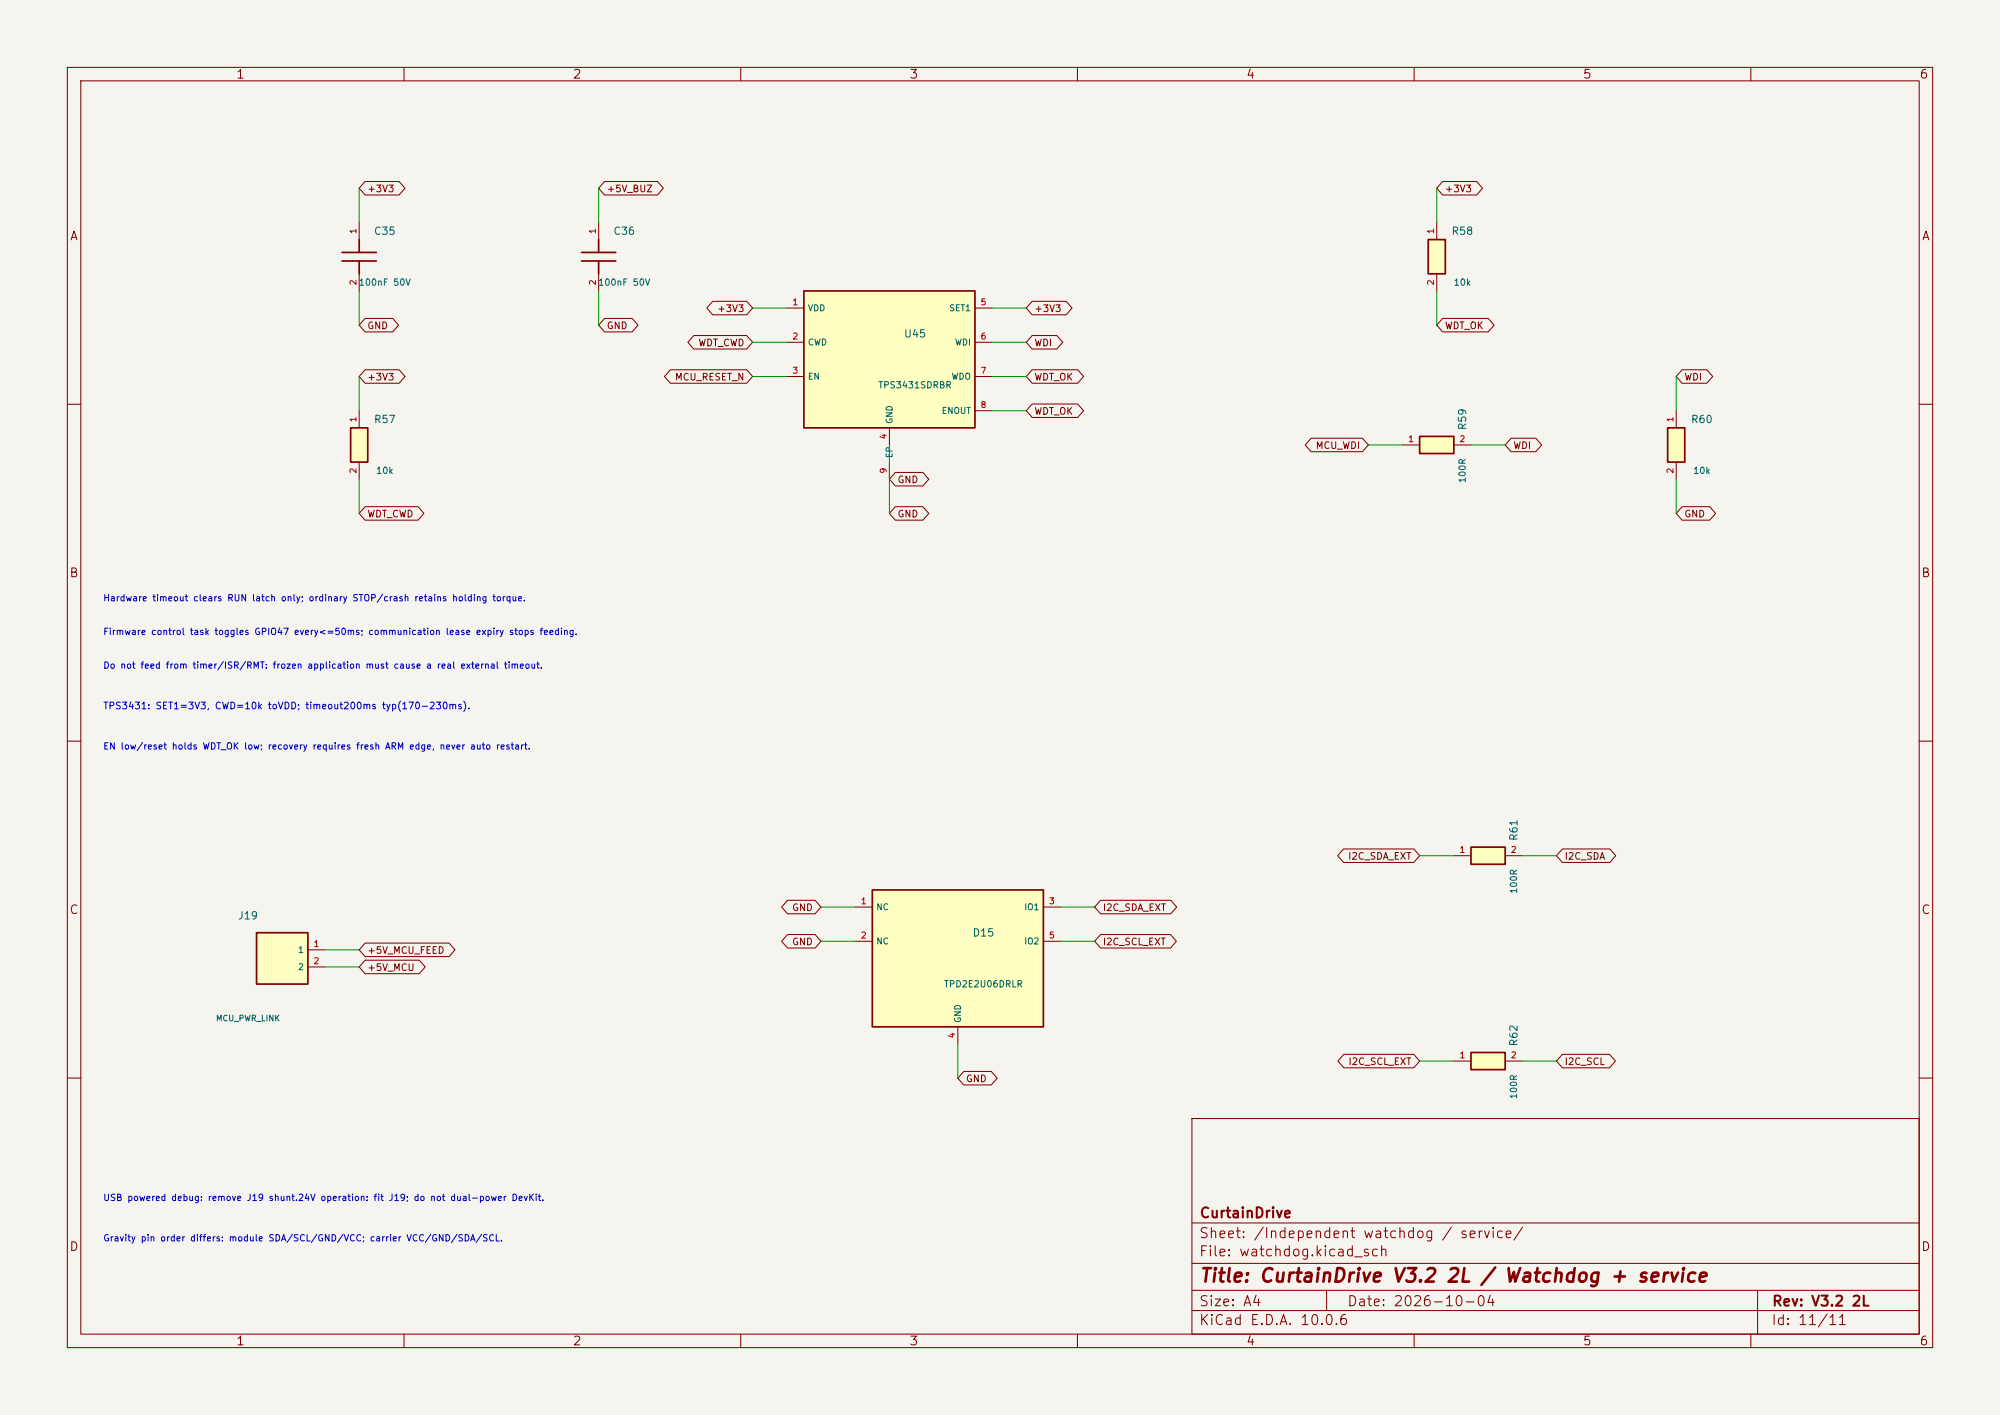
[picture p16: page 11]

Hardware timeout clears RUN latch only; ordinary STOP/crash retains holding torque. Firmware control task toggles GPIO47 every<=50ms; communication lease expiry stops feeding. Do not feed from timer/ISR/RMT: frozen application must cause a real external timeout. EN low/reset holds WDT_OK low; recovery requires fresh ARM edge, never auto restart. TPS3431: SET1=3V3, CWD=10k toVDD; timeout200ms typ(170-230ms).

USB powered debug: remove J19 shunt.24V operation: fit J19; do not dual-power DevKit. Gravity pin order differs: module SDA/SCL/GND/VCC; carrier VCC/GND/SDA/SCL.

CurtainDrive
Sheet: /Independent watchdog / service/
File: watchdog.kicad_sch
Title: CurtainDrive V3.2 2L / Watchdog + service
