LLAB1234567890/PCB-/project/CurtainDrive_V3_2_2L.kicad_pcb

## KiCad design project/CurtainDrive_V3_2_2L.kicad_pcb (2026-10-04)

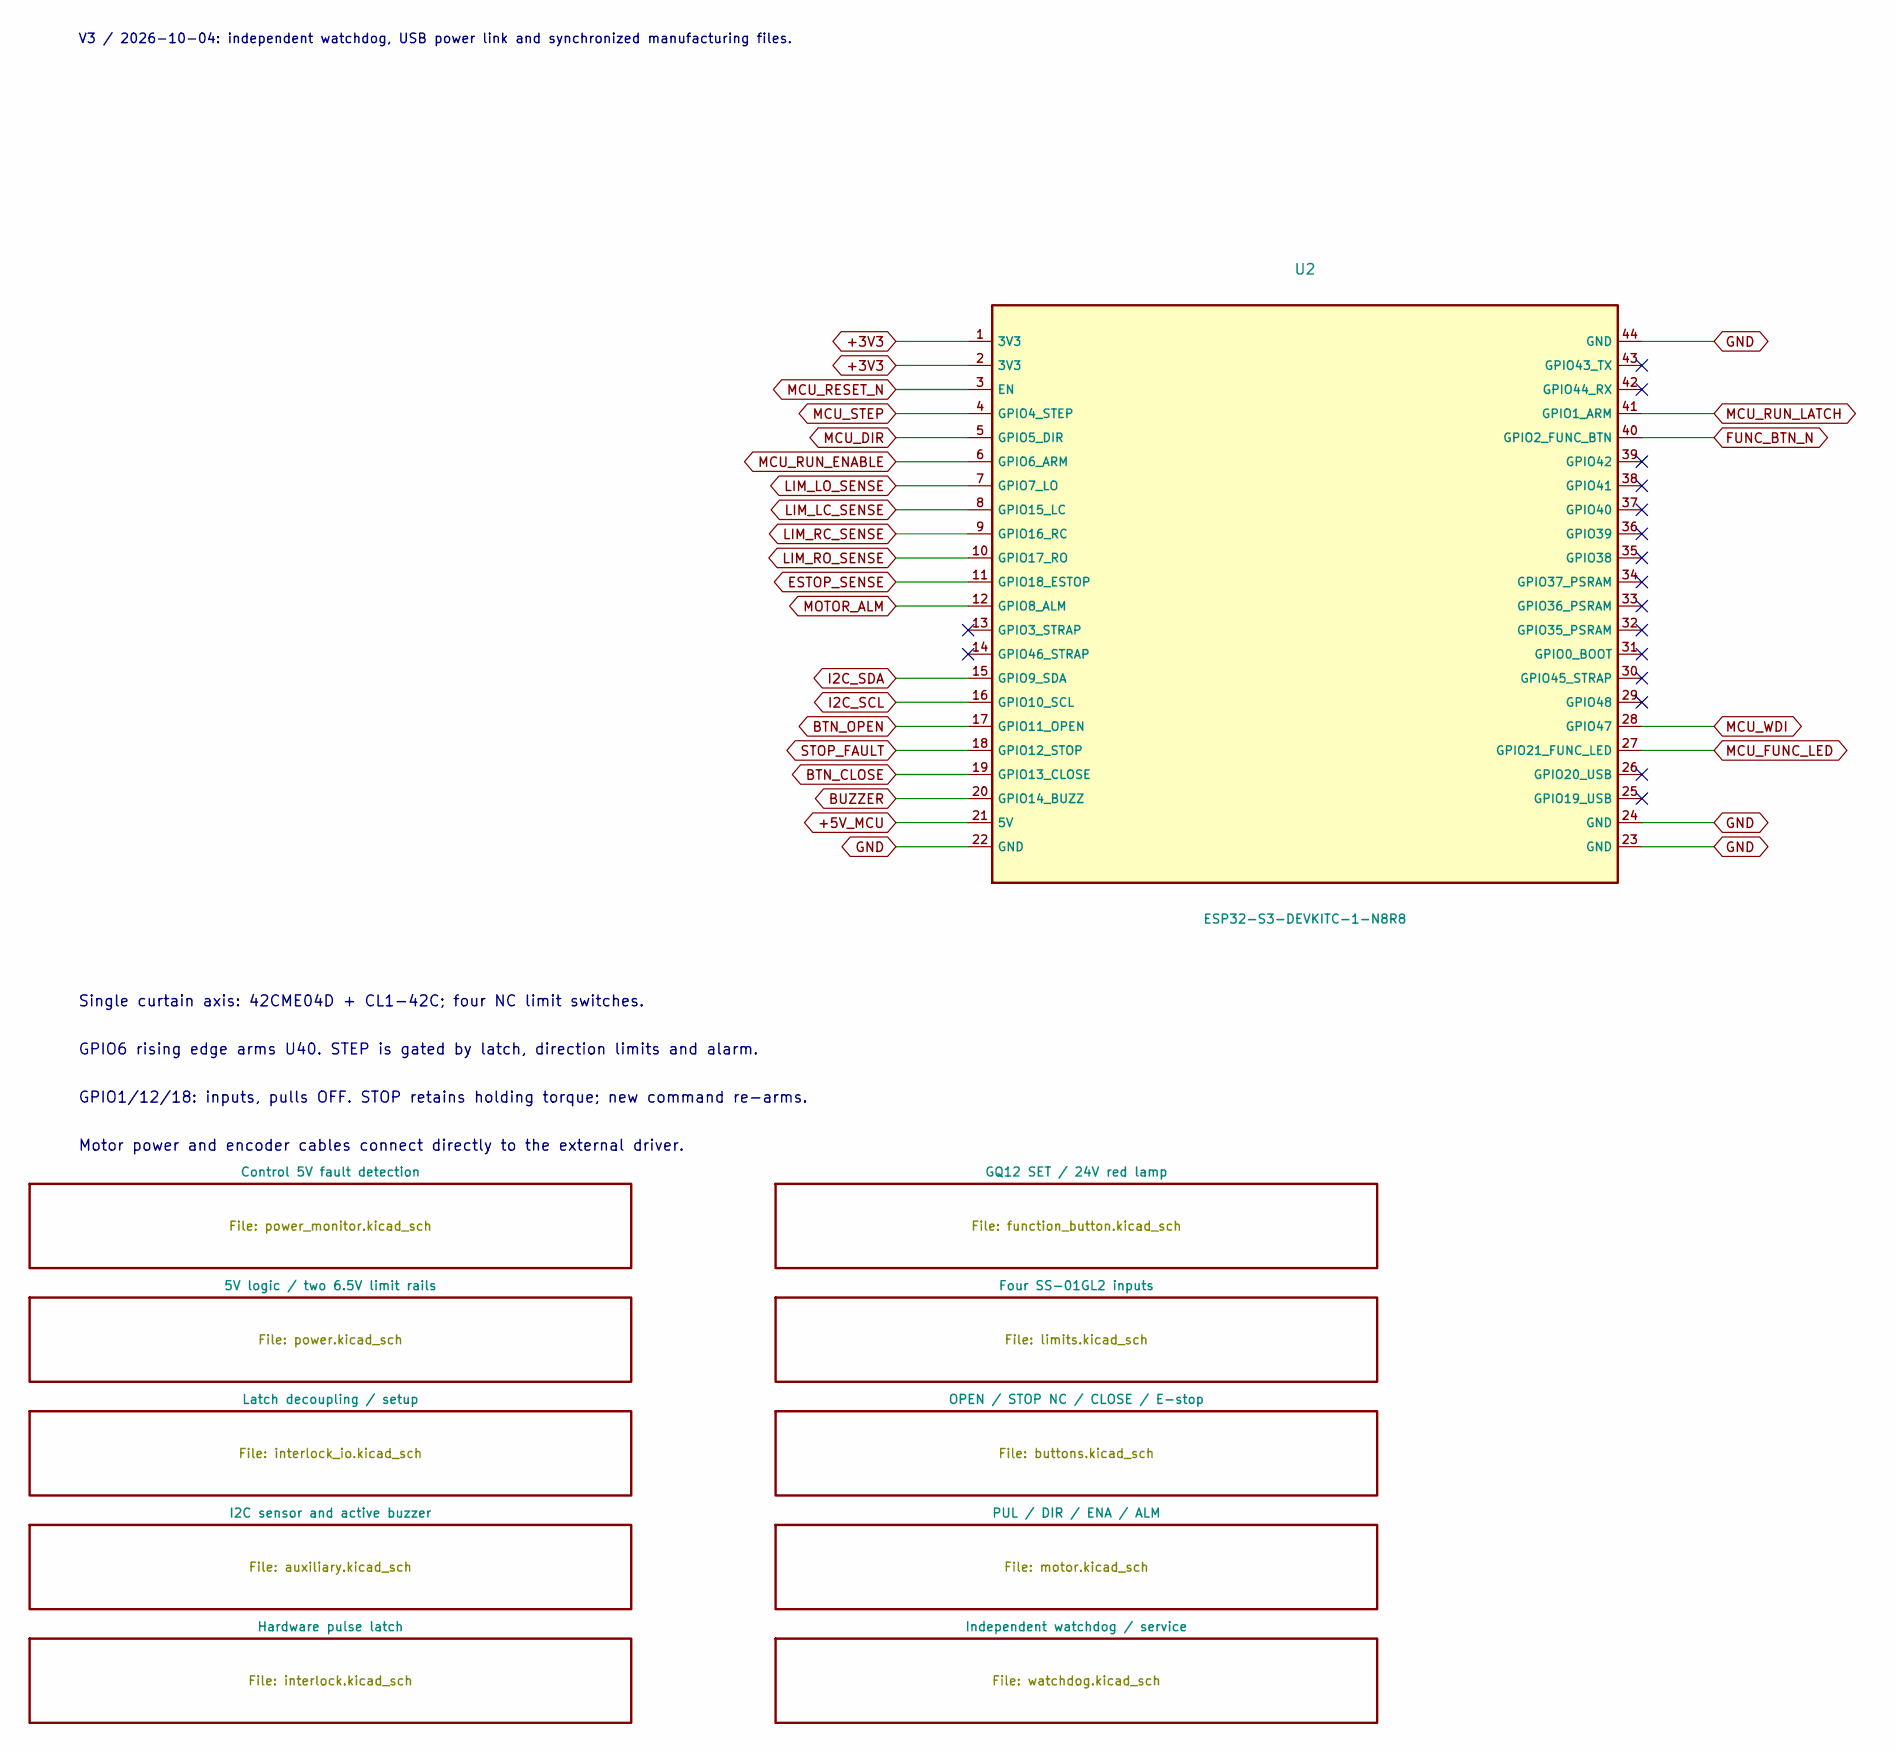
[picture p17: schematic CurtainDrive_V3_2_2L.kicad_sch, CurtainDrive V3.2 2L / MCU architecture]

Parts:
U2: ESP32-S3-DEVKITC-1-N8R8; ESP32_S3_DevKitC_1_N8R8; Manufacturer Part ESP32-S3-DEVKITC-1-N8R8

Connections:
+3V3: U2.1 (3V3), U2.2 (3V3); also elsewhere on the board
+5V_MCU: U2.21 (5V); also elsewhere on the board
BTN_CLOSE: U2.19 (GPIO13_CLOSE); also elsewhere on the board
BTN_OPEN: U2.17 (GPIO11_OPEN); also elsewhere on the board
BUZZER: U2.20 (GPIO14_BUZZ); also elsewhere on the board
ESTOP_SENSE: U2.11 (GPIO18_ESTOP); also elsewhere on the board
FUNC_BTN_N: U2.40 (GPIO2_FUNC_BTN); also elsewhere on the board
GND: U2.22 (GND), U2.23 (GND), U2.24 (GND), U2.44 (GND); also elsewhere on the board
I2C_SCL: U2.16 (GPIO10_SCL); also elsewhere on the board
I2C_SDA: U2.15 (GPIO9_SDA); also elsewhere on the board
LIM_LC_SENSE: U2.8 (GPIO15_LC); also elsewhere on the board
LIM_LO_SENSE: U2.7 (GPIO7_LO); also elsewhere on the board
LIM_RC_SENSE: U2.9 (GPIO16_RC); also elsewhere on the board
LIM_RO_SENSE: U2.10 (GPIO17_RO); also elsewhere on the board
MCU_DIR: U2.5 (GPIO5_DIR); also elsewhere on the board
MCU_FUNC_LED: U2.27 (GPIO21_FUNC_LED); also elsewhere on the board
MCU_RESET_N: U2.3 (EN); also elsewhere on the board
MCU_RUN_ENABLE: U2.6 (GPIO6_ARM); also elsewhere on the board
MCU_RUN_LATCH: U2.41 (GPIO1_ARM); also elsewhere on the board
MCU_STEP: U2.4 (GPIO4_STEP); also elsewhere on the board
MCU_WDI: U2.28 (GPIO47); also elsewhere on the board
MOTOR_ALM: U2.12 (GPIO8_ALM); also elsewhere on the board
STOP_FAULT: U2.18 (GPIO12_STOP); also elsewhere on the board

Notes on the sheet:
GPIO6 rising edge arms U40. STEP is gated by latch, direction limits and alarm.
Single curtain axis: 42CME04D + CL1-42C; four NC limit switches.
Motor power and encoder cables connect directly to the external driver.
GPIO1/12/18: inputs, pulls OFF. STOP retains holding torque; new command re-arms.
V3 / 2026-10-04: independent watchdog, USB power link and synchronized manufacturing files.

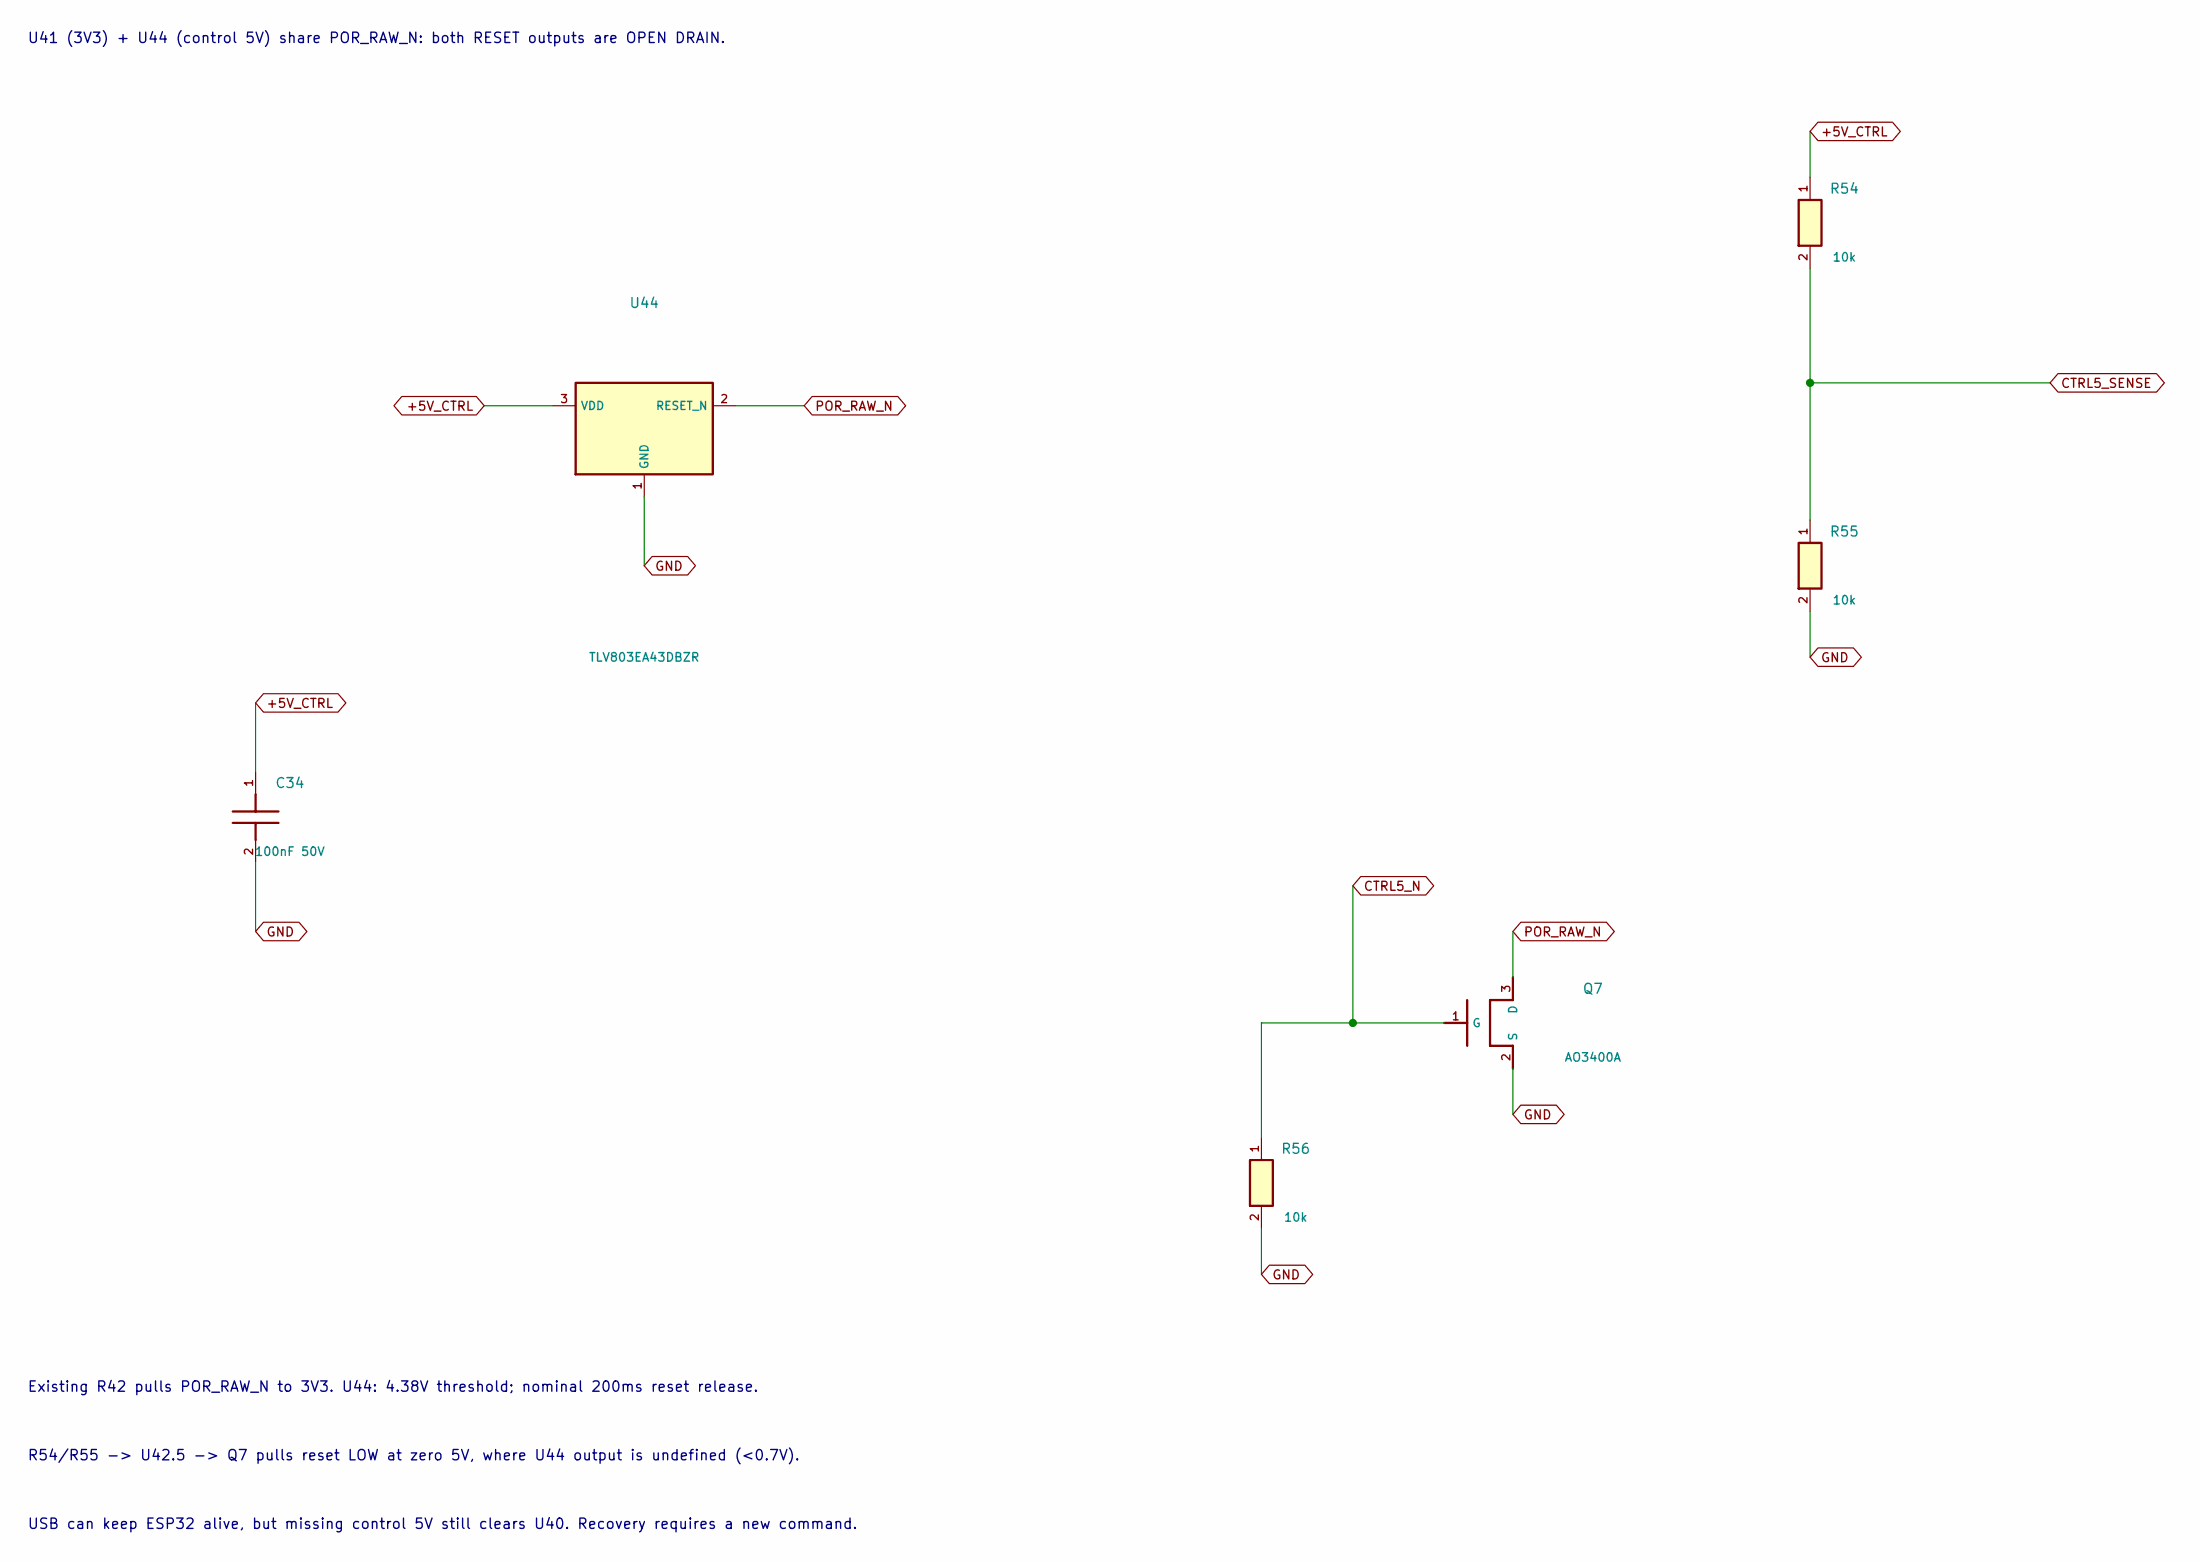
[picture p18: schematic power_monitor.kicad_sch, CurtainDrive V3.2 2L / Voltage supervisors]

Parts:
C34: 100nF 50V; C_0603_1608Metric; Voltage Rating 50V / X7R / 10%; Manufacturer Part CC0603KRX7R9BB104
Q7: AO3400A; SOT-23; Voltage Rating 30V / Vgs +/-12V; Manufacturer Part AO3400A
R54, R55, R56: 10k; R_0603_1608Metric; Voltage Rating 1% / 0.1W; Manufacturer Part 0603WAF1002T5E
U44: TLV803EA43DBZR; SOT-23; Voltage Rating 4.38V threshold / 200ms release / open 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; Manufacturer Part TLV803EA43DBZR

Connections:
+5V_CTRL: C34.1, R54.1, U44.3 (VDD); also elsewhere on the board
CTRL5_N: Q7.1 (G), R56.1; also elsewhere on the board
CTRL5_SENSE: R54.2, R55.1; also elsewhere on the board
GND: C34.2, Q7.2 (S), R55.2, R56.2, U44.1 (GND); also elsewhere on the board
POR_RAW_N: Q7.3 (D), U44.2 (RESET_N); also elsewhere on the board

Notes on the sheet:
R54/R55 -> U42.5 -> Q7 pulls reset LOW at zero 5V, where U44 output is undefined (<0.7V).
Existing R42 pulls POR_RAW_N to 3V3. U44: 4.38V threshold; nominal 200ms reset release.
U41 (3V3) + U44 (control 5V) share POR_RAW_N: both RESET outputs are OPEN DRAIN.
USB can keep ESP32 alive, but missing control 5V still clears U40. Recovery requires a new command.

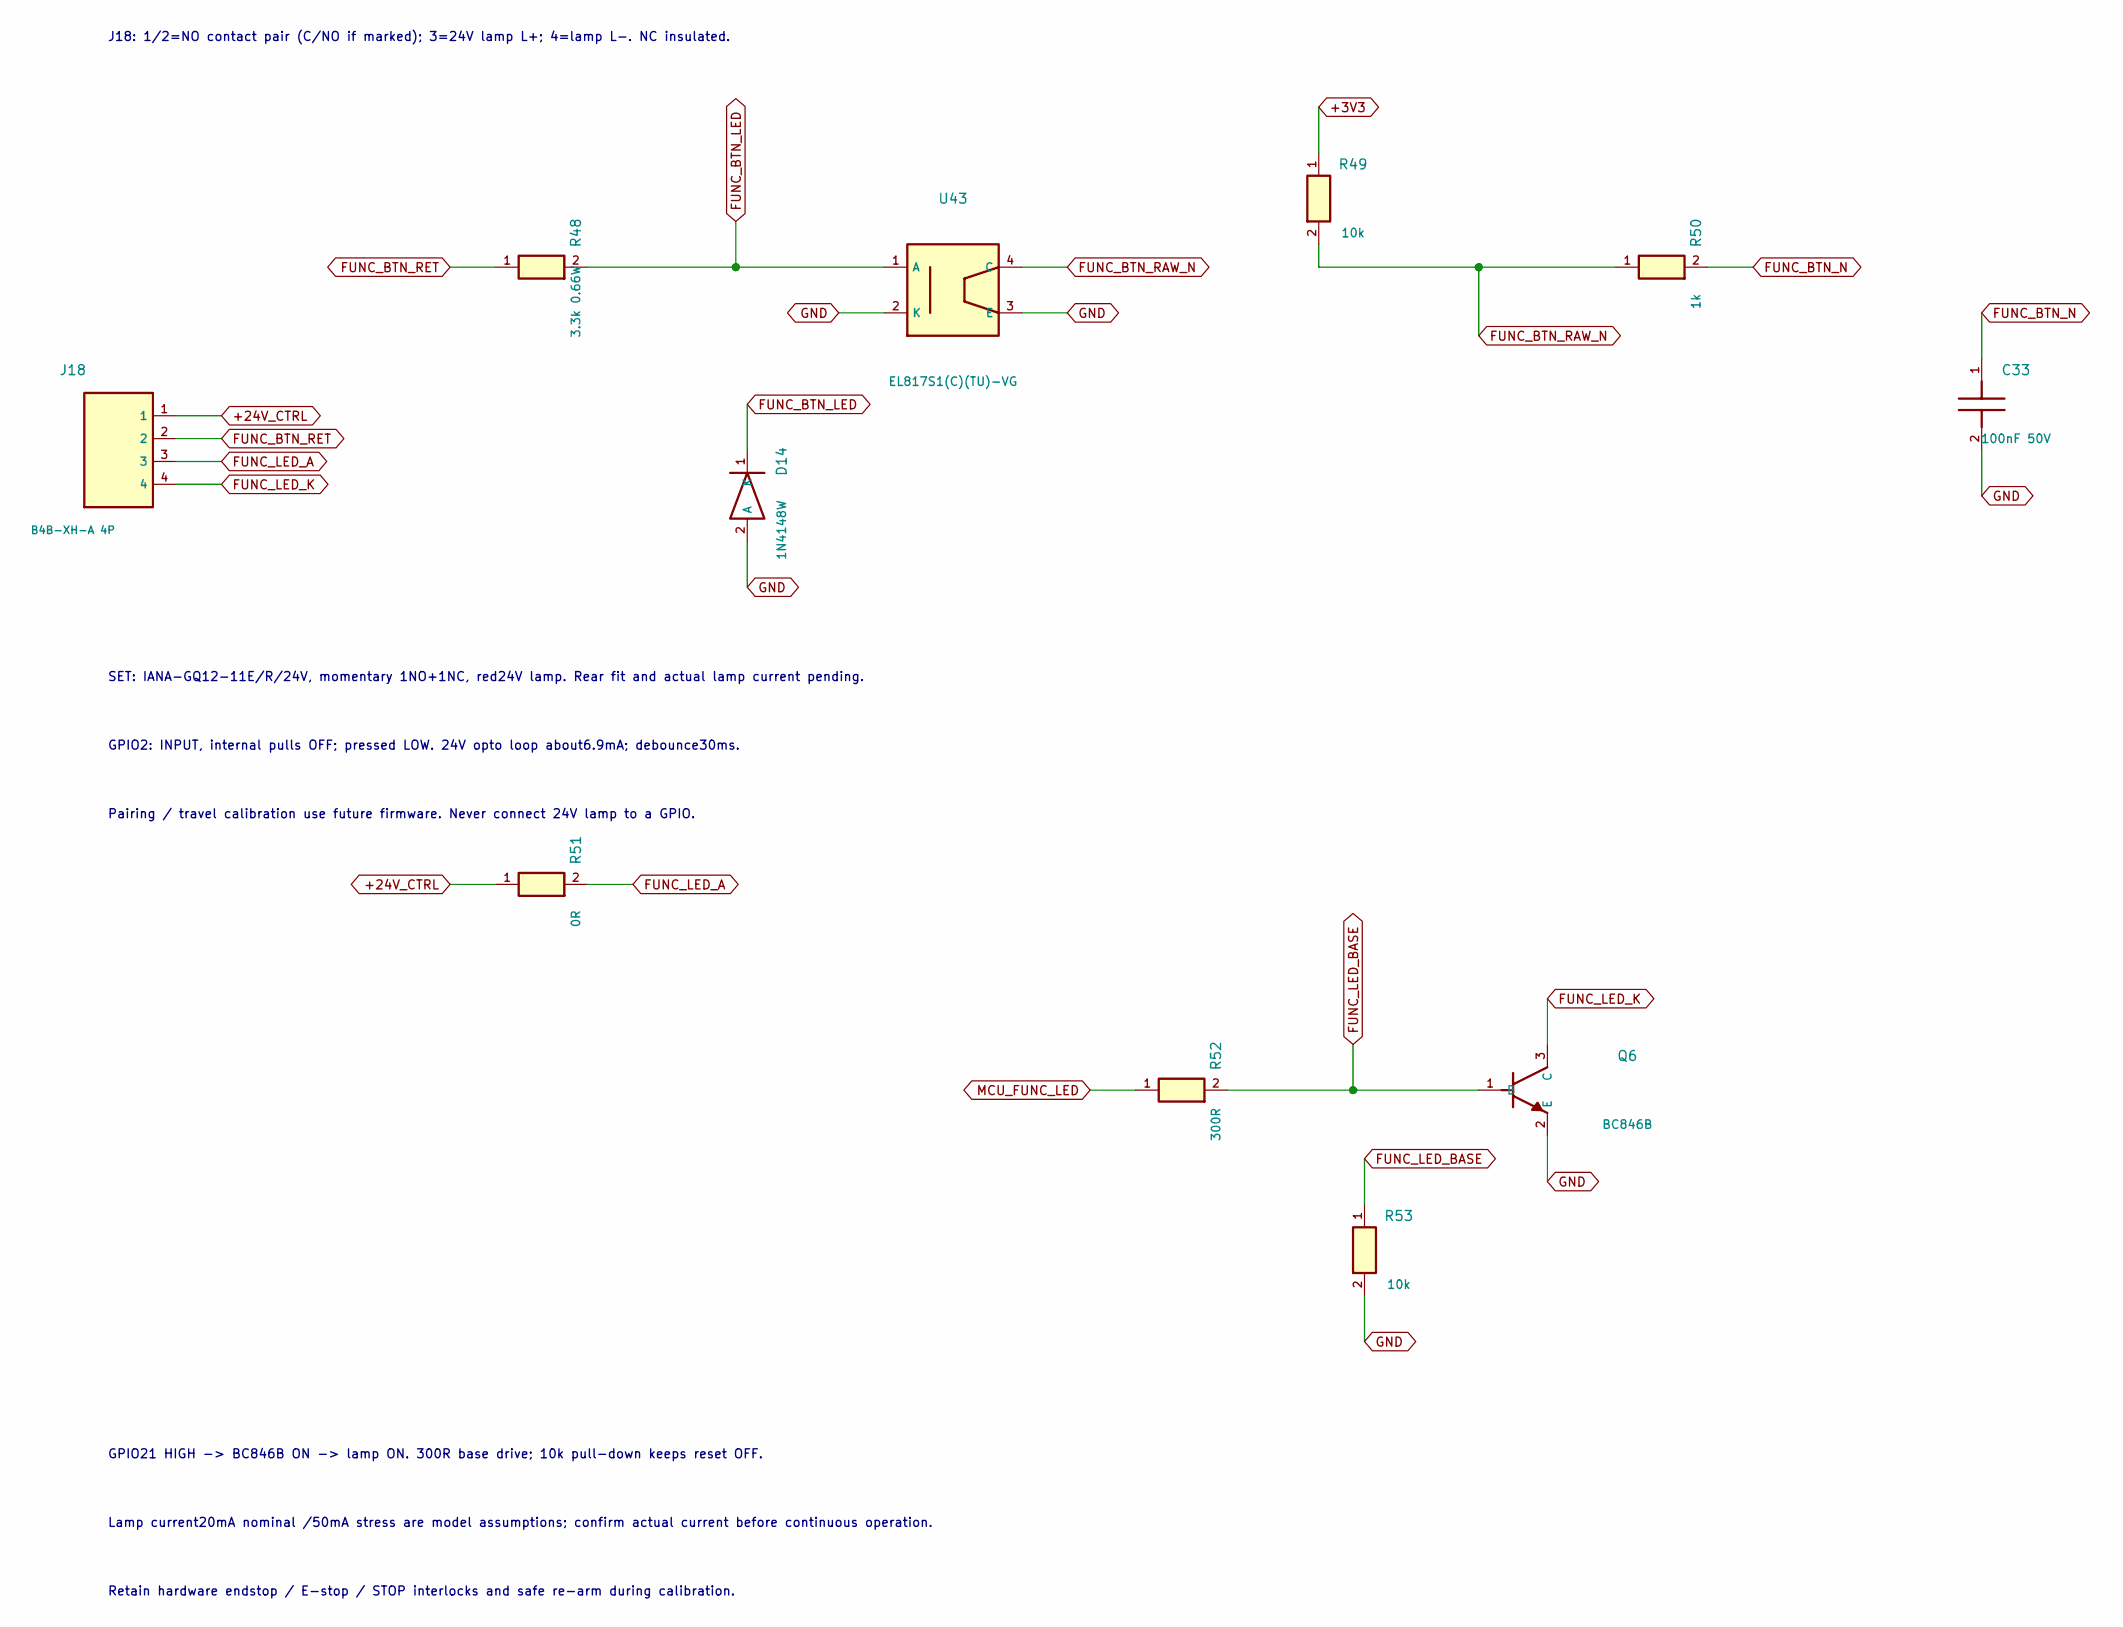
[picture p19: schematic function_button.kicad_sch, CurtainDrive V3.2 2L / SET + red lamp]

Parts:
C33: 100nF 50V; C_0603_1608Metric; Voltage Rating 50V / X7R / 10%; Manufacturer Part CC0603KRX7R9BB104
D14: 1N4148W; D_SOD-123; Manufacturer Part 1N4148W
J18: B4B-XH-A 4P; JST_XH_B4B-XH-A_1x04_P2.50mm_Vertical; Voltage Rating 3A / 250V; keyed 2.5mm; Manufacturer Part B4B-XH-A(LF)(SN)
Q6: BC846B; SOT-23; Voltage Rating 65V VCEO / 100mA absolute / SOT-23 B1 E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; Manufacturer Part BC846B,215
R48: 3.3k 0.66W; R_1206_3216Metric; Voltage Rating 1% / 0.66W at 70C / 1206; Manufacturer Part ERJ-UP8F3301V
R49, R53: 10k; R_0603_1608Metric; Voltage Rating 1% / 0.1W; Manufacturer Part 0603WAF1002T5E
R50: 1k; R_0603_1608Metric; Voltage Rating 1% / 0.1W; Manufacturer Part 0603WAF1001T5E
R51: 0R; R_0603_1608Metric; Voltage Rating 0R jumper / 0.1W / 1A maximum; Manufacturer Part RC0603JR-070RL
R52: 300R; R_0603_1608Metric; Voltage Rating 1% / 0.1W; Manufacturer Part RC0603FR-07300RL
U43: EL817S1(C)(TU)-VG; Source_U3; Manufacturer Part EL817S1(C)(TU)-VG

Connections:
+3V3: R49.1; also elsewhere on the board
+24V_CTRL: J18.1, R51.1; also elsewhere on the board
FUNC_BTN_LED: D14.1 (K), R48.2, U43.1 (A)
FUNC_BTN_N: C33.1, R50.2; also elsewhere on the board
FUNC_BTN_RAW_N: R49.2, R50.1, U43.4 (C)
FUNC_BTN_RET: J18.2, R48.1
FUNC_LED_A: J18.3, R51.2
FUNC_LED_BASE: Q6.1 (B), R52.2, R53.1
FUNC_LED_K: J18.4, Q6.3 (C)
GND: C33.2, D14.2 (A), Q6.2 (E), R53.2, U43.2 (K), U43.3 (E); also elsewhere on the board
MCU_FUNC_LED: R52.1; also elsewhere on the board

Notes on the sheet:
Retain hardware endstop / E-stop / STOP interlocks and safe re-arm during calibration.
Pairing / travel calibration use future firmware. Never connect 24V lamp to a GPIO.
SET: IANA-GQ12-11E/R/24V, momentary 1NO+1NC, red24V lamp. Rear fit and actual lamp current pending.
GPIO2: INPUT, internal pulls OFF; pressed LOW. 24V opto loop about6.9mA; debounce30ms.
J18: 1/2=NO contact pair (C/NO if marked); 3=24V lamp L+; 4=lamp L-. NC insulated.
GPIO21 HIGH -> BC846B ON -> lamp ON. 300R base drive; 10k pull-down keeps reset OFF.
Lamp current20mA nominal /50mA stress are model assumptions; confirm actual current before continuous operation.

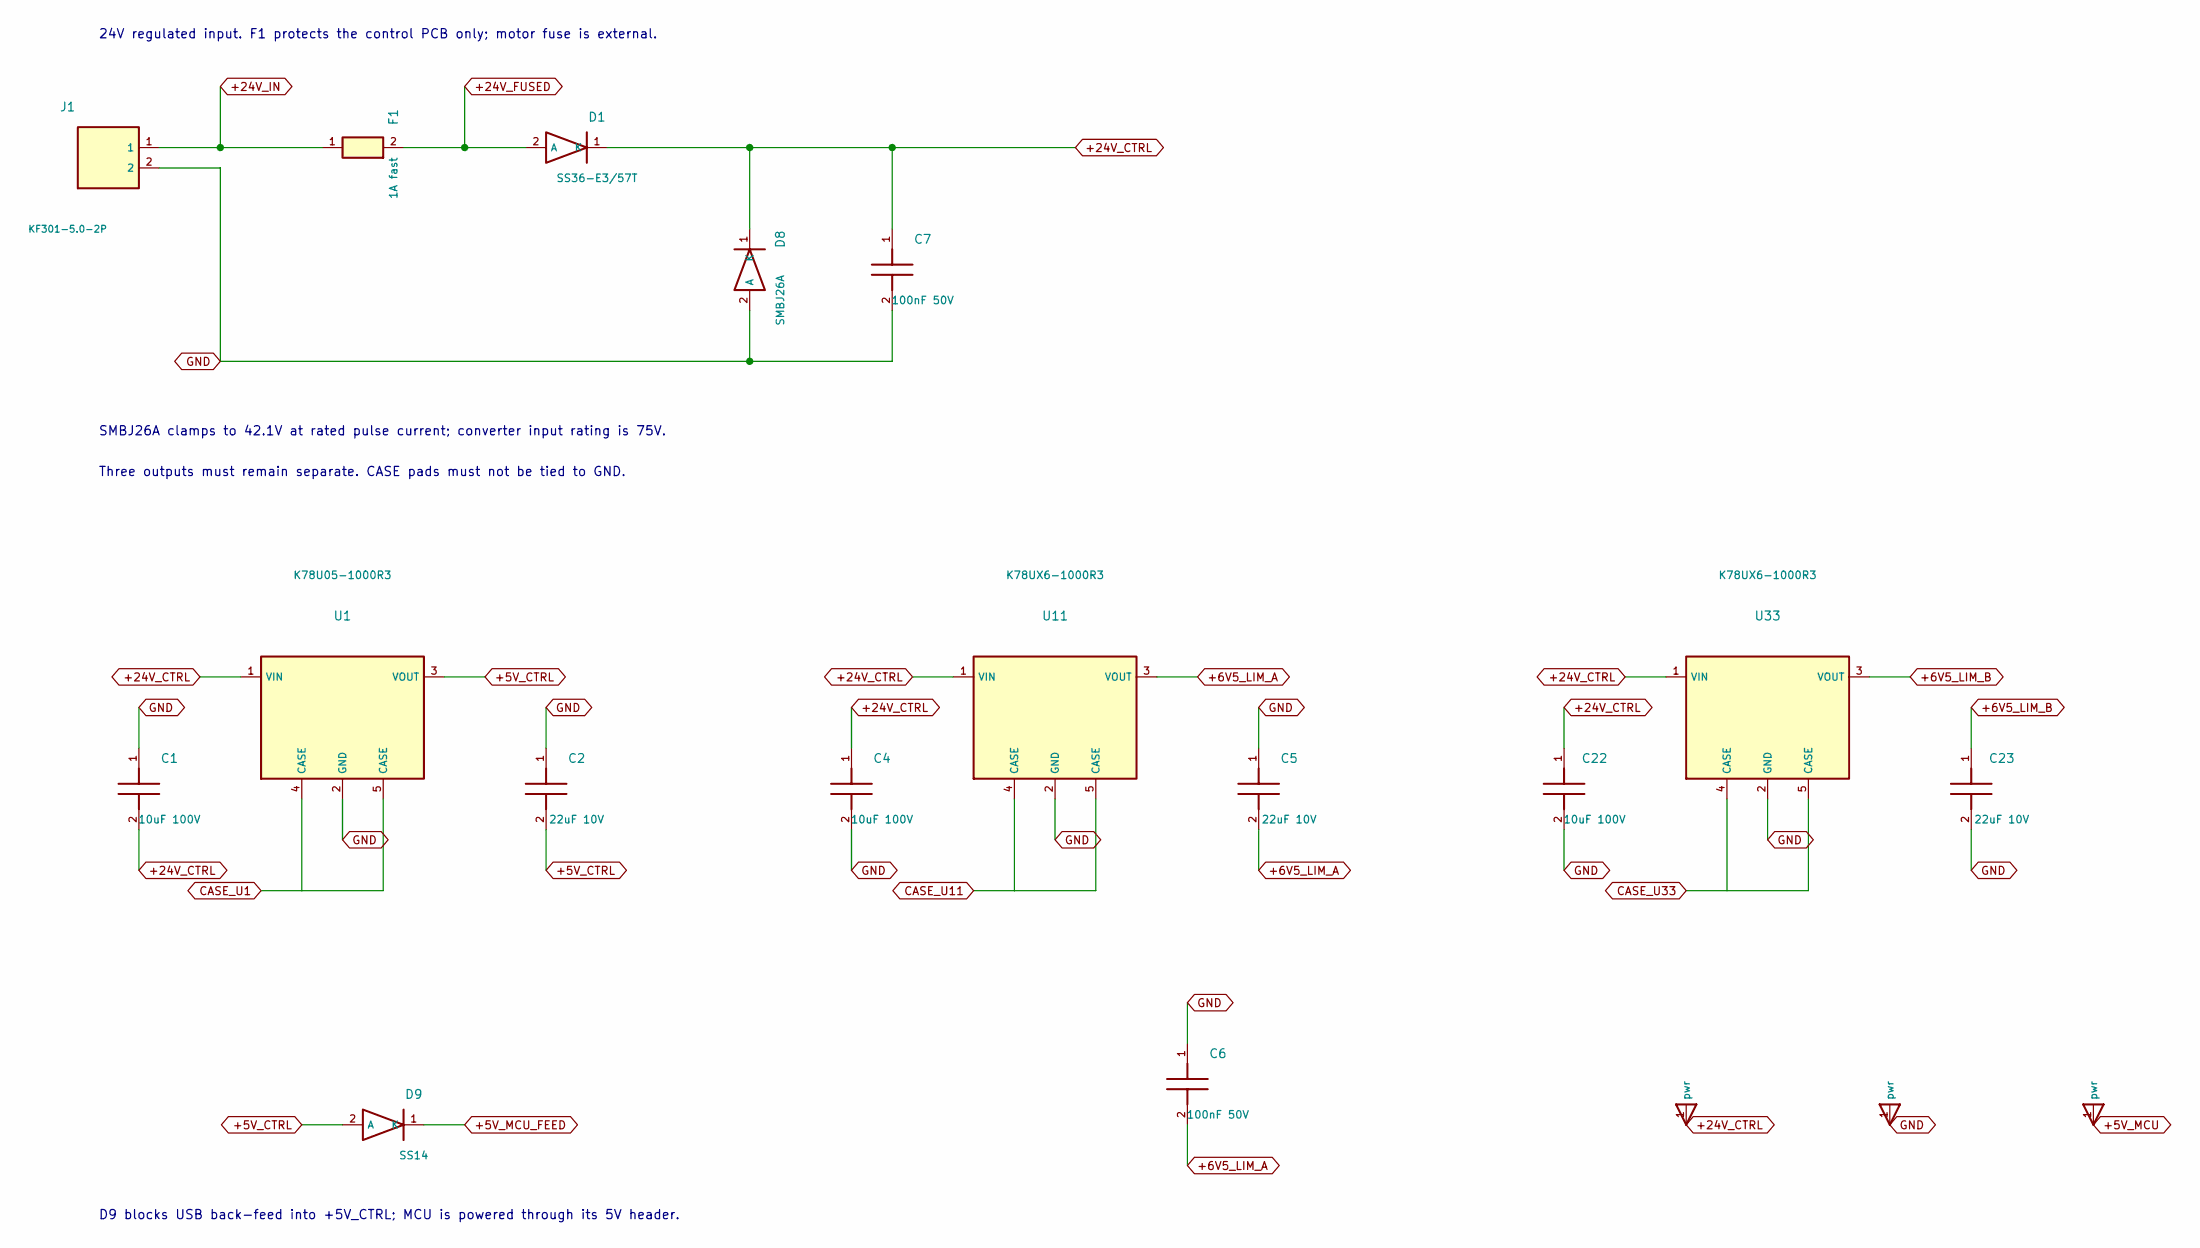
[picture p20: schematic power.kicad_sch, CurtainDrive V3.2 2L / Power tree]

Parts:
C1, C4, C22: 10uF 100V; C_1210_3225Metric; Voltage Rating 100V / X7R / 10%; Manufacturer Part C3225X7R2A106K250AC
C2, C5, C23: 22uF 10V; C_0805_2012Metric; Voltage Rating 10V / X5R / 20%; Manufacturer Part CL21A226MPQNNNE
C6, C7: 100nF 50V; C_0603_1608Metric; Voltage Rating 50V / X7R / 10%; Manufacturer Part CC0603KRX7R9BB104
D1: SS36-E3/57T; D_SMB; Voltage Rating 60V / 3A; Manufacturer Part SS36-E3/57T
D8: SMBJ26A; D_SMB; Voltage Rating 26V standoff / 42.1V clamp; Manufacturer Part SMBJ26A-13-F
D9: SS14; D_SMA; Voltage Rating 40V / 1A; Manufacturer Part SS14
F1: 1A fast; Source_F1; Voltage Rating 1A / 125V fast; Manufacturer Part 0451001.MRL
J1: KF301-5.0-2P; Source_J1; Manufacturer Part KF301-5.0-2P
U1: K78U05-1000R3; K78U05_1000R3; Voltage Rating 9-75V in / 5V 1A; Manufacturer Part K78U05-1000R3
U11, U33: K78UX6-1000R3; K78U05_1000R3; Voltage Rating 9-75V in / 6.5V 1A; Manufacturer Part K78UX6-1000R3

Connections:
+5V_CTRL: C2.2, D9.2 (A), U1.3 (VOUT); also elsewhere on the board
+5V_MCU_FEED: D9.1 (K); also elsewhere on the board
+6V5_LIM_A: C5.2, C6.2, U11.3 (VOUT); also elsewhere on the board
+6V5_LIM_B: C23.1, U33.3 (VOUT); also elsewhere on the board
+24V_CTRL: C1.2, C4.1, C7.1, C22.1, D1.1 (K), D8.1 (K), U1.1 (VIN), U11.1 (VIN), U33.1 (VIN); also elsewhere on the board
+24V_FUSED: D1.2 (A), F1.2
+24V_IN: F1.1, J1.1
CASE_U1: U1.4 (CASE), U1.5 (CASE)
CASE_U11: U11.4 (CASE), U11.5 (CASE)
CASE_U33: U33.4 (CASE), U33.5 (CASE)
GND: C1.1, C2.1, C4.2, C5.1, C6.1, C7.2, C22.2, C23.2, D8.2 (A), J1.2, U1.2 (GND), U11.2 (GND), U33.2 (GND); also elsewhere on the board

Notes on the sheet:
SMBJ26A clamps to 42.1V at rated pulse current; converter input rating is 75V.
Three outputs must remain separate. CASE pads must not be tied to GND.
D9 blocks USB back-feed into +5V_CTRL; MCU is powered through its 5V header.
24V regulated input. F1 protects the control PCB only; motor fuse is external.

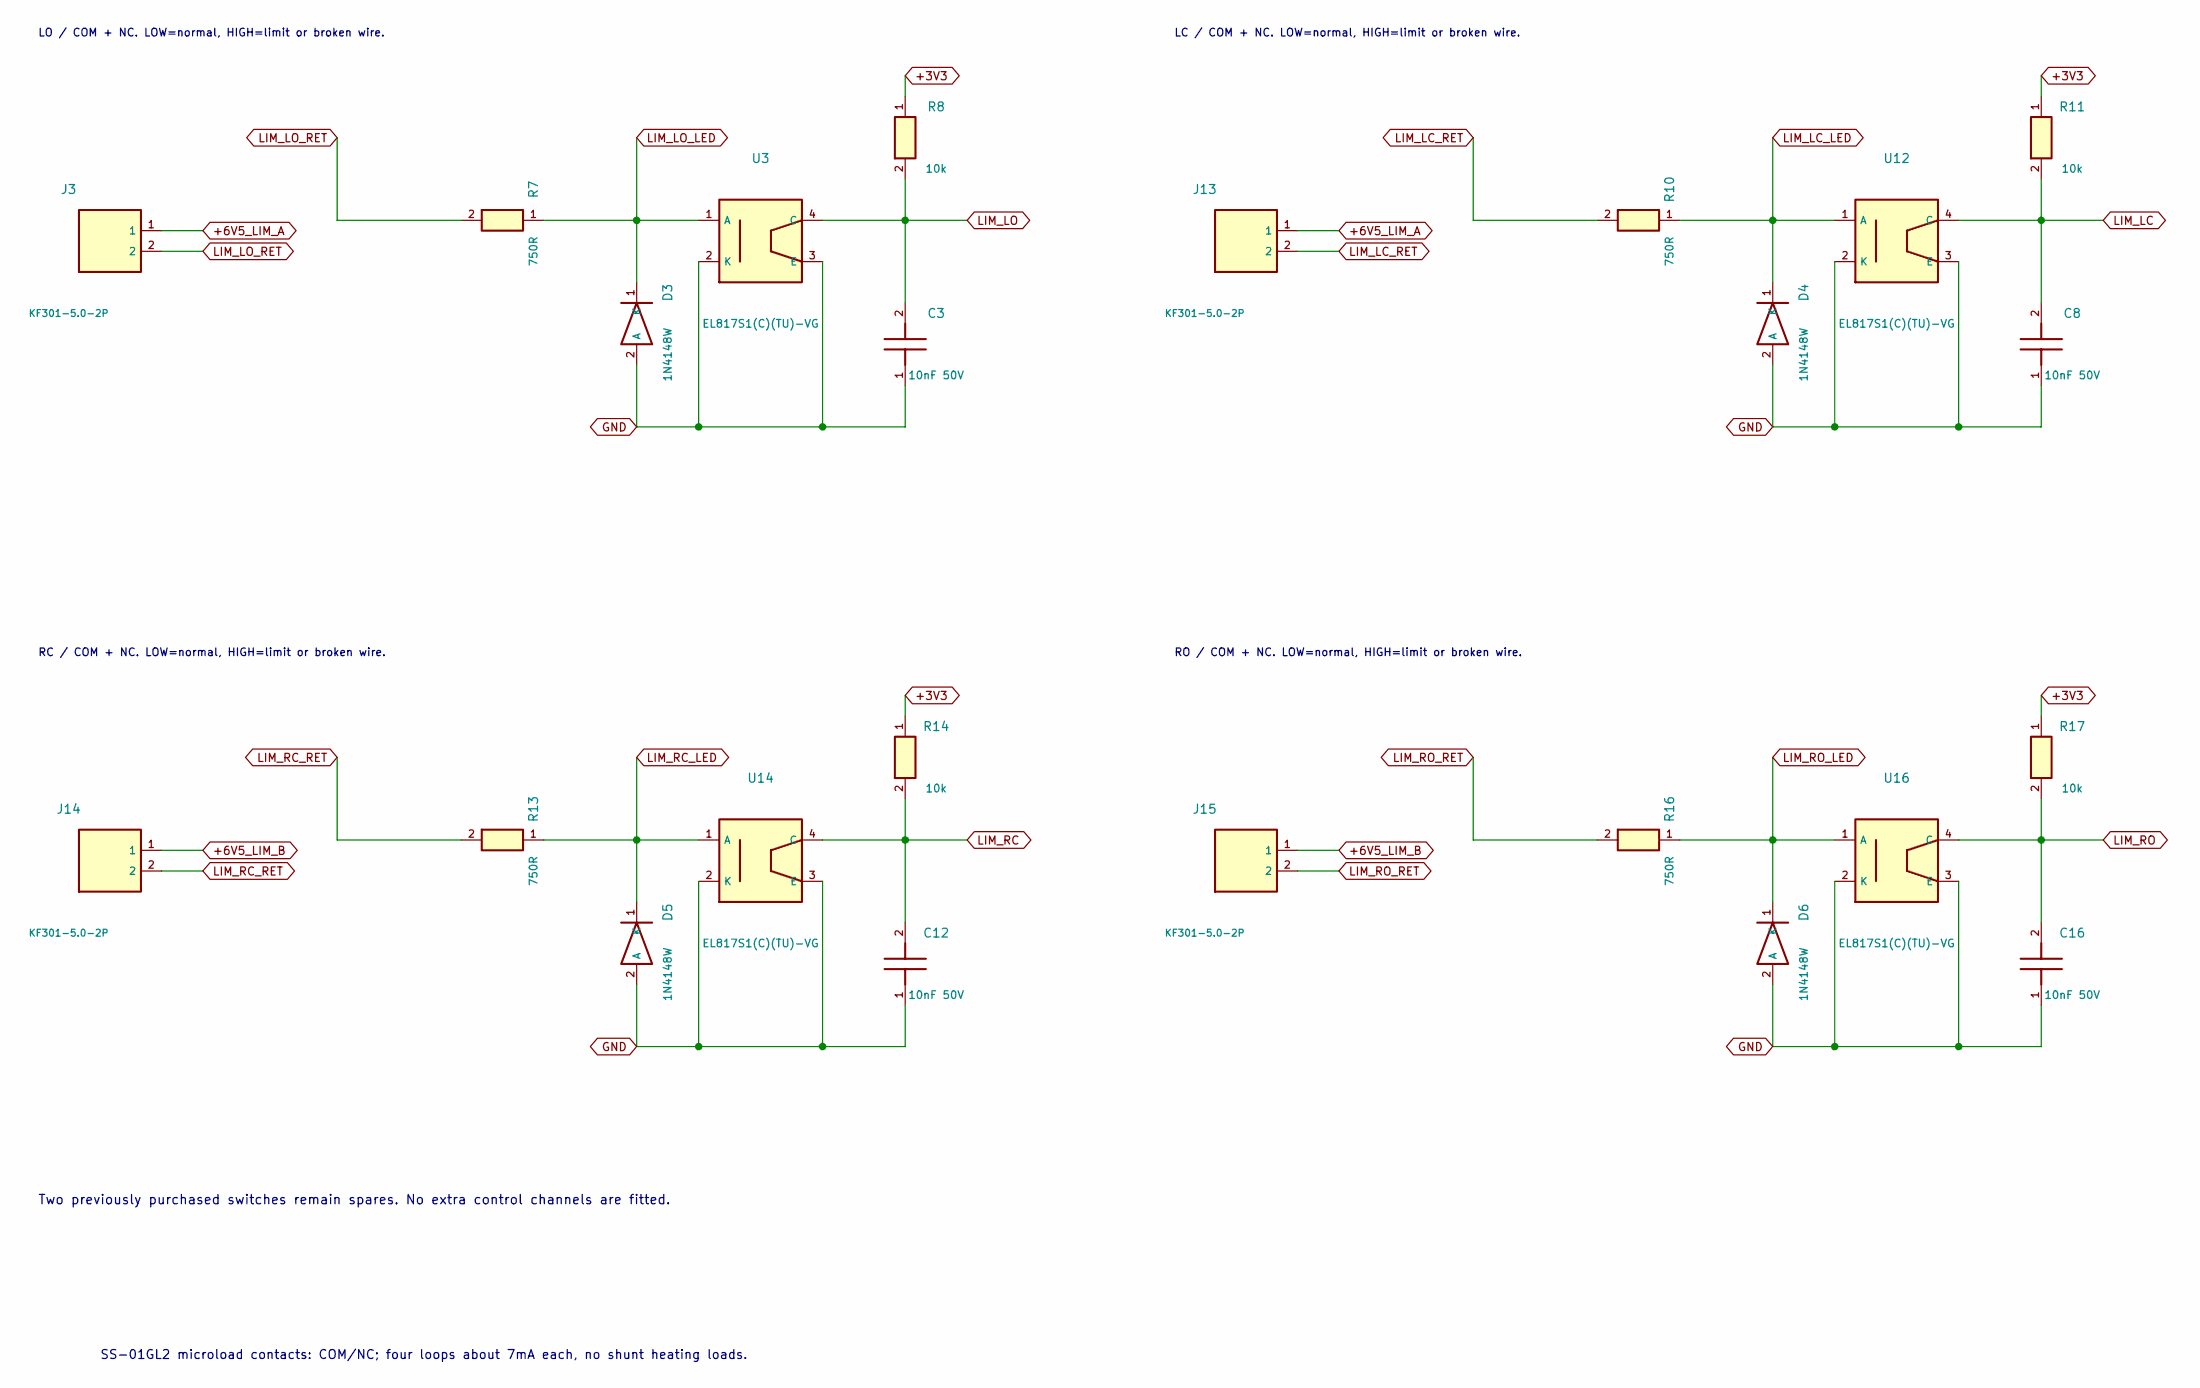
[picture p21: schematic limits.kicad_sch, CurtainDrive V3.2 2L / NC limits]

Parts:
C3, C8, C12, C16: 10nF 50V; C_0603_1608Metric; Voltage Rating 50V / X7R / 10%; Manufacturer Part 0603B103K500NT
D3, D4, D5, D6: 1N4148W; D_SOD-123; Manufacturer Part 1N4148W
J3: KF301-5.0-2P; Source_J3; Manufacturer Part KF301-5.0-2P
J13: KF301-5.0-2P; Source_J13; Manufacturer Part KF301-5.0-2P
J14: KF301-5.0-2P; Source_J14; Manufacturer Part KF301-5.0-2P
J15: KF301-5.0-2P; Source_J15; Manufacturer Part KF301-5.0-2P
R7, R10, R13, R16: 750R; R_0603_1608Metric; Voltage Rating 1% / 0.1W; Manufacturer Part 0603WAF7500T5E
R8, R11, R14, R17: 10k; R_0603_1608Metric; Voltage Rating 1% / 0.1W; Manufacturer Part 0603WAF1002T5E
U3: EL817S1(C)(TU)-VG; Source_U3; Manufacturer Part EL817S1(C)(TU)-VG
U12: EL817S1(C)(TU)-VG; Source_U12; Manufacturer Part EL817S1(C)(TU)-VG
U14: EL817S1(C)(TU)-VG; Source_U14; Manufacturer Part EL817S1(C)(TU)-VG
U16: EL817S1(C)(TU)-VG; Source_U16; Manufacturer Part EL817S1(C)(TU)-VG

Connections:
+3V3: R8.1, R11.1, R14.1, R17.1; also elsewhere on the board
+6V5_LIM_A: J3.1, J13.1; also elsewhere on the board
+6V5_LIM_B: J14.1, J15.1; also elsewhere on the board
GND: C3.1, C8.1, C12.1, C16.1, D3.2 (A), D4.2 (A), D5.2 (A), D6.2 (A), U3.2 (K), U3.3 (E), U12.2 (K), U12.3 (E), U14.2 (K), U14.3 (E), U16.2 (K), U16.3 (E); also elsewhere on the board
LIM_LC: C8.2, R11.2, U12.4 (C); also elsewhere on the board
LIM_LC_LED: D4.1 (K), R10.1, U12.1 (A)
LIM_LC_RET: J13.2, R10.2
LIM_LO: C3.2, R8.2, U3.4 (C); also elsewhere on the board
LIM_LO_LED: D3.1 (K), R7.1, U3.1 (A)
LIM_LO_RET: J3.2, R7.2
LIM_RC: C12.2, R14.2, U14.4 (C); also elsewhere on the board
LIM_RC_LED: D5.1 (K), R13.1, U14.1 (A)
LIM_RC_RET: J14.2, R13.2
LIM_RO: C16.2, R17.2, U16.4 (C); also elsewhere on the board
LIM_RO_LED: D6.1 (K), R16.1, U16.1 (A)
LIM_RO_RET: J15.2, R16.2

Notes on the sheet:
Two previously purchased switches remain spares. No extra control channels are fitted.
LC / COM + NC. LOW=normal, HIGH=limit or broken wire.
SS-01GL2 microload contacts: COM/NC; four loops about 7mA each, no shunt heating loads.
RC / COM + NC. LOW=normal, HIGH=limit or broken wire.
LO / COM + NC. LOW=normal, HIGH=limit or broken wire.
RO / COM + NC. LOW=normal, HIGH=limit or broken wire.
