LLAB1234567890/PCB-/project/CurtainDrive_V3_2_2L.kicad_pcb

## KiCad design project/CurtainDrive_V3_2_2L.kicad_pcb (continued)

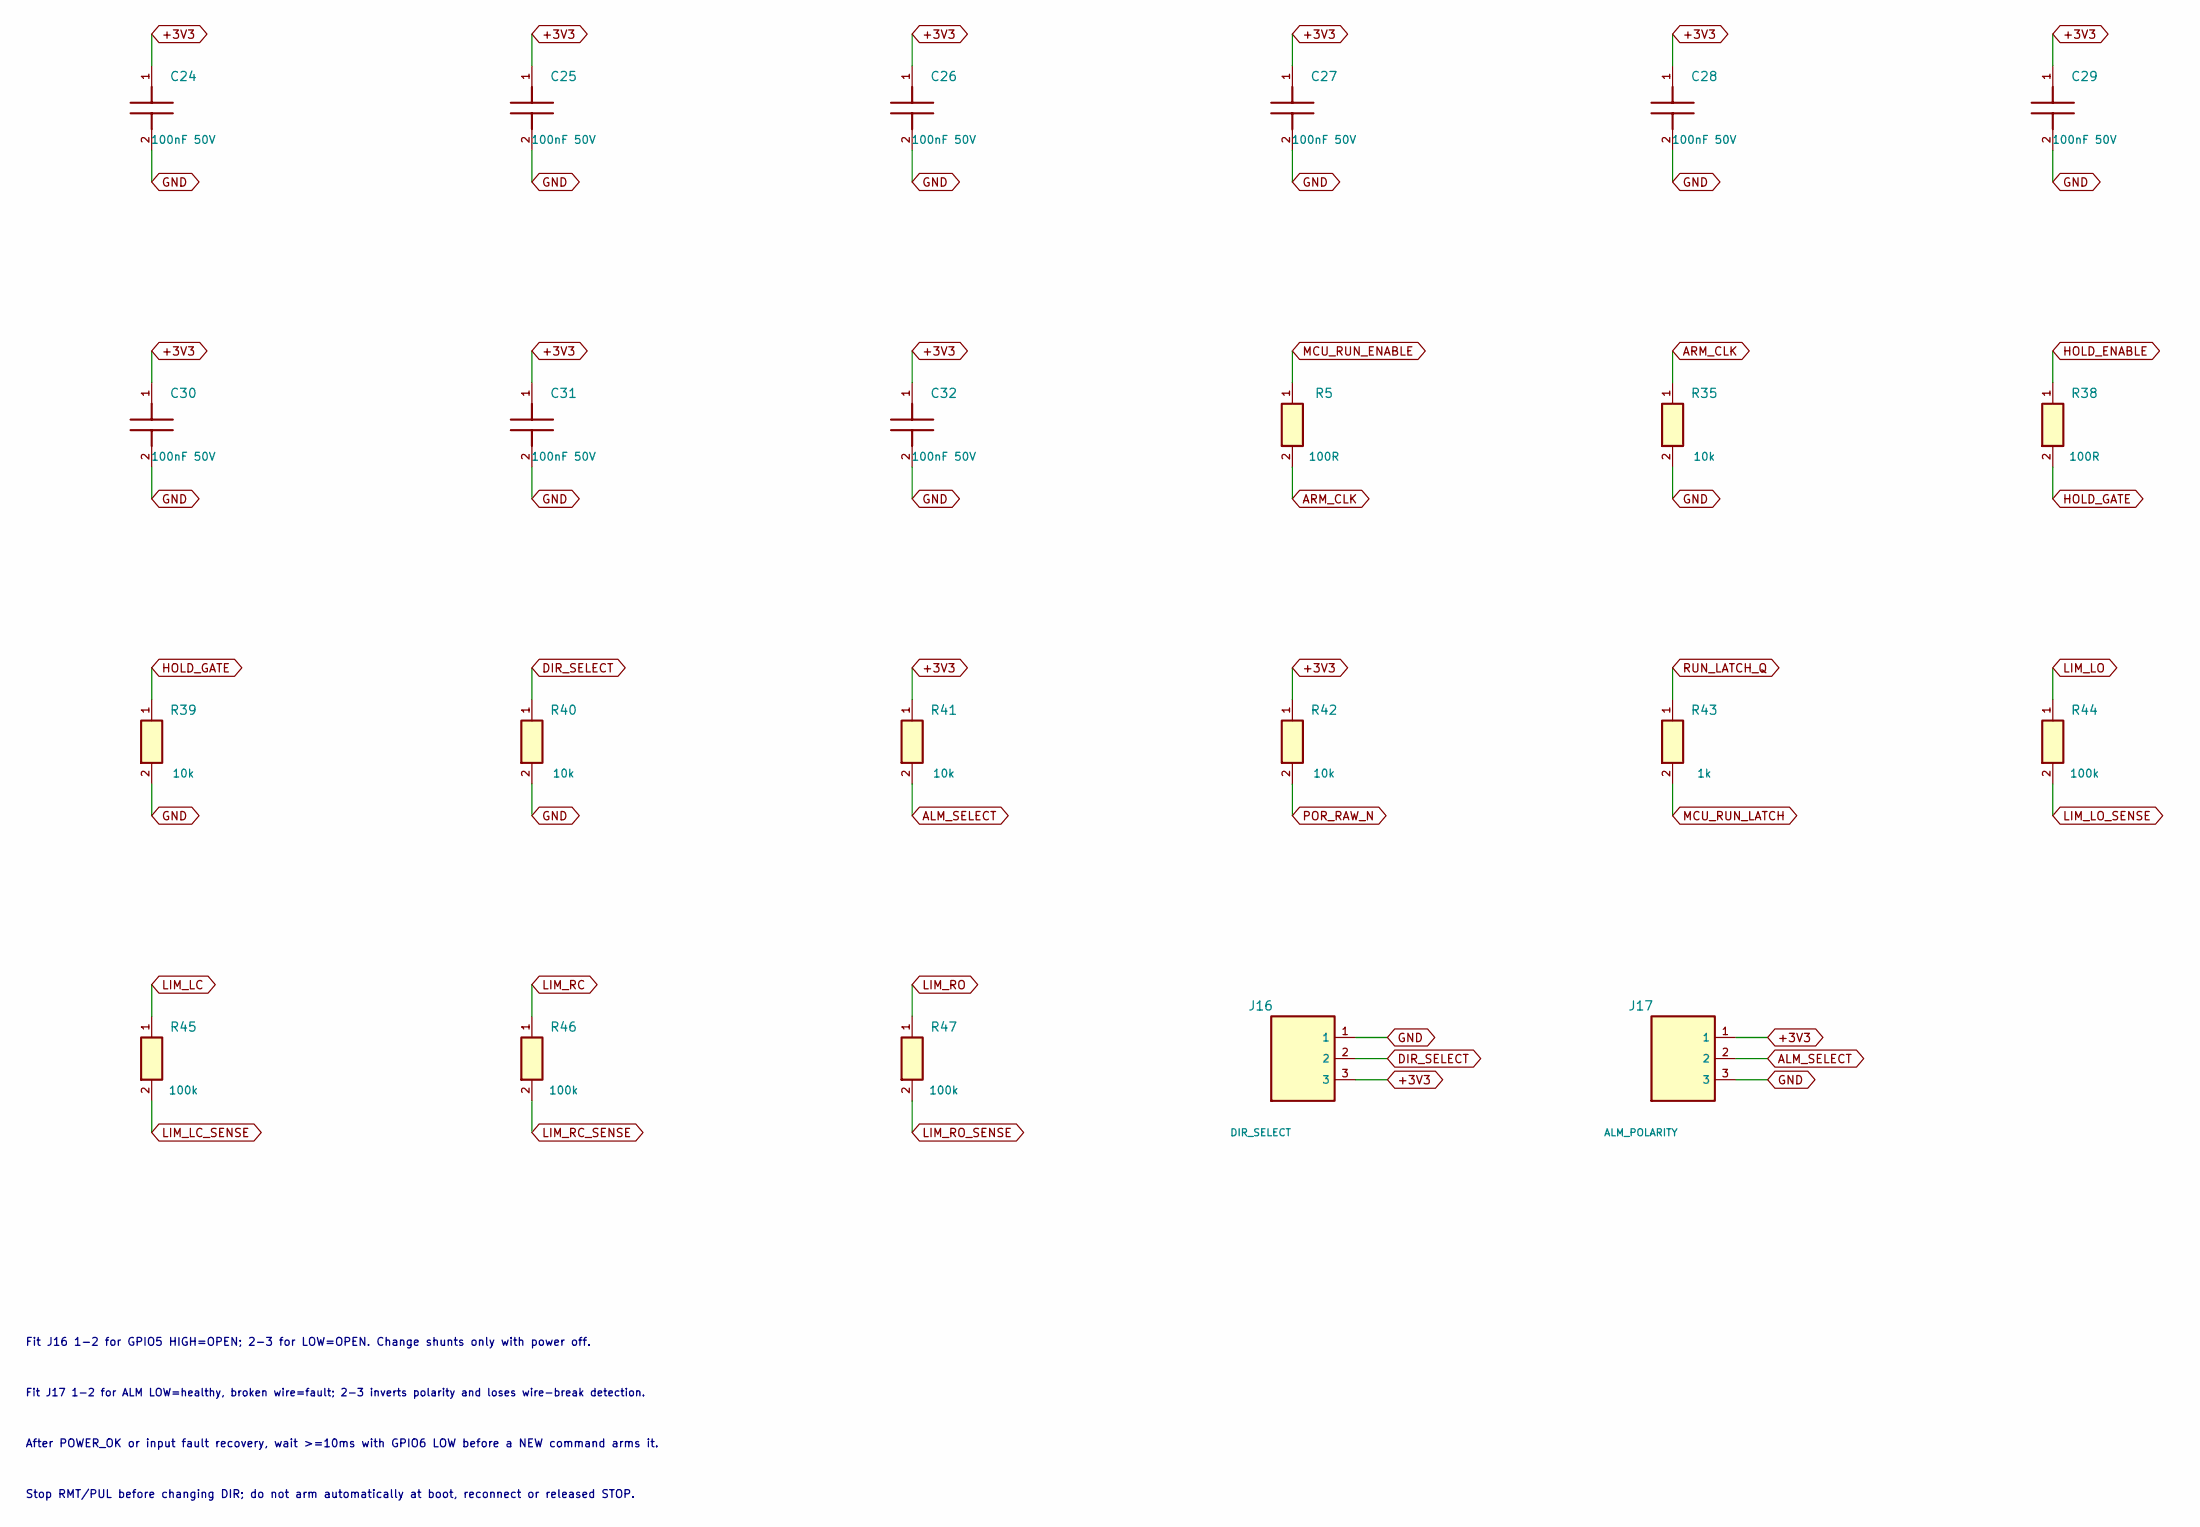
[picture p22: schematic interlock_io.kicad_sch, CurtainDrive V3.2 2L / ARM + jumpers]

Parts:
C24, C25, C26, C27, C28, C29, C30, C31, C32: 100nF 50V; C_0603_1608Metric; Voltage Rating 50V / X7R / 10%; Manufacturer Part CC0603KRX7R9BB104
J16: DIR_SELECT; PinHeader_1x03_P2.54mm_Vertical; Voltage Rating 2.54mm pitch; fit matching shunt separa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; Manufacturer Part 2.54mm 1x3 male header - exact MPN TBD
J17: ALM_POLARITY; PinHeader_1x03_P2.54mm_Vertical; Voltage Rating 2.54mm pitch; fit matching shunt separa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; Manufacturer Part 2.54mm 1x3 male header - exact MPN TBD
R5, R38: 100R; R_0603_1608Metric; Voltage Rating 1% / 0.1W; Manufacturer Part 0603WAF1000T5E
R35, R39, R40, R41, R42: 10k; R_0603_1608Metric; Voltage Rating 1% / 0.1W; Manufacturer Part 0603WAF1002T5E
R43: 1k; R_0603_1608Metric; Voltage Rating 1% / 0.1W; Manufacturer Part 0603WAF1001T5E
R44, R45, R46, R47: 100k; R_0603_1608Metric; Voltage Rating 1% / 0.1W; Manufacturer Part 0603WAF1003T5E

Connections:
+3V3: C24.1, C25.1, C26.1, C27.1, C28.1, C29.1, C30.1, C31.1, C32.1, J16.3, J17.1, R41.1, R42.1; also elsewhere on the board
ALM_SELECT: J17.2, R41.2; also elsewhere on the board
ARM_CLK: R5.2, R35.1; also elsewhere on the board
DIR_SELECT: J16.2, R40.1; also elsewhere on the board
GND: C24.2, C25.2, C26.2, C27.2, C28.2, C29.2, C30.2, C31.2, C32.2, J16.1, J17.3, R35.2, R39.2, R40.2; also elsewhere on the board
HOLD_ENABLE: R38.1; also elsewhere on the board
HOLD_GATE: R38.2, R39.1; also elsewhere on the board
LIM_LC: R45.1; also elsewhere on the board
LIM_LC_SENSE: R45.2; also elsewhere on the board
LIM_LO: R44.1; also elsewhere on the board
LIM_LO_SENSE: R44.2; also elsewhere on the board
LIM_RC: R46.1; also elsewhere on the board
LIM_RC_SENSE: R46.2; also elsewhere on the board
LIM_RO: R47.1; also elsewhere on the board
LIM_RO_SENSE: R47.2; also elsewhere on the board
MCU_RUN_ENABLE: R5.1; also elsewhere on the board
MCU_RUN_LATCH: R43.2; also elsewhere on the board
POR_RAW_N: R42.2; also elsewhere on the board
RUN_LATCH_Q: R43.1; also elsewhere on the board

Notes on the sheet:
Stop RMT/PUL before changing DIR; do not arm automatically at boot, reconnect or released STOP.
Fit J16 1-2 for GPIO5 HIGH=OPEN; 2-3 for LOW=OPEN. Change shunts only with power off.
After POWER_OK or input fault recovery, wait >=10ms with GPIO6 LOW before a NEW command arms it.
Fit J17 1-2 for ALM LOW=healthy, broken wire=fault; 2-3 inverts polarity and loses wire-break detection.

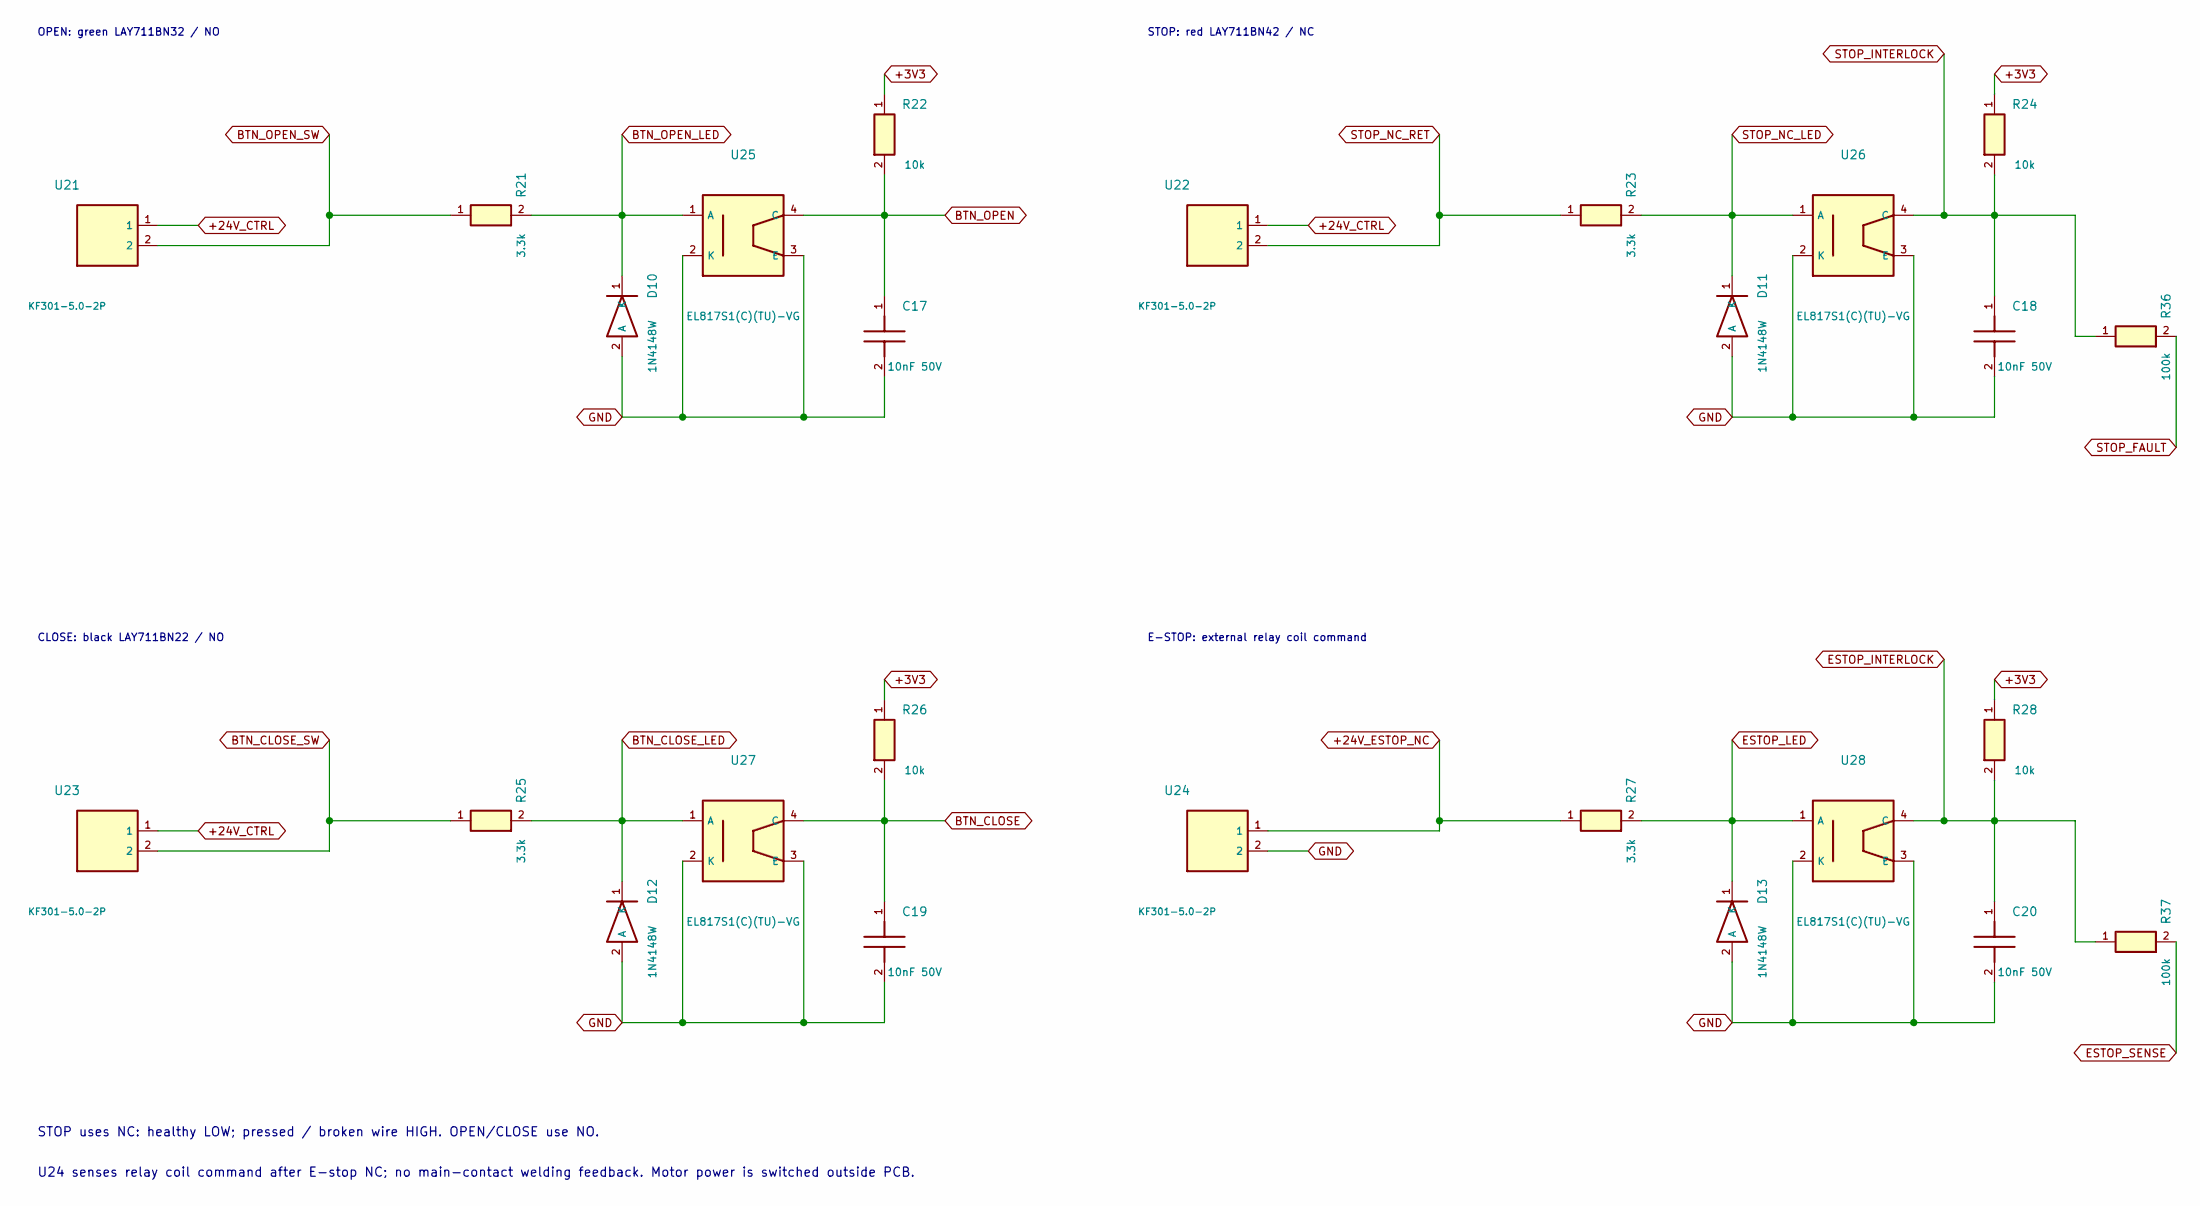
[picture p23: schematic buttons.kicad_sch, CurtainDrive V3.2 2L / Buttons + E-stop]

Parts:
C17, C18, C19, C20: 10nF 50V; C_0603_1608Metric; Voltage Rating 50V / X7R / 10%; Manufacturer Part 0603B103K500NT
D10, D11, D12, D13: 1N4148W; D_SOD-123; Voltage Rating 75V / 150mA; Manufacturer Part 1N4148W
R21, R23, R25, R27: 3.3k; R_1210_3225Metric; Voltage Rating 5% / 0.5W; Manufacturer Part 1210W2J0332T5E
R22, R24, R26, R28: 10k; R_0603_1608Metric; Voltage Rating 1% / 0.1W; Manufacturer Part 0603WAF1002T5E
R36, R37: 100k; R_0603_1608Metric; Voltage Rating 1% / 0.1W; Manufacturer Part 0603WAF1003T5E
U21: KF301-5.0-2P; Source_U21; Manufacturer Part KF301-5.0-2P
U22: KF301-5.0-2P; Source_U22; Manufacturer Part KF301-5.0-2P
U23: KF301-5.0-2P; Source_U23; Manufacturer Part KF301-5.0-2P
U24: KF301-5.0-2P; Source_U24; Manufacturer Part KF301-5.0-2P
U25: EL817S1(C)(TU)-VG; Source_U25; Manufacturer Part EL817S1(C)(TU)-VG
U26: EL817S1(C)(TU)-VG; Source_U26; Manufacturer Part EL817S1(C)(TU)-VG
U27: EL817S1(C)(TU)-VG; Source_U27; Manufacturer Part EL817S1(C)(TU)-VG
U28: EL817S1(C)(TU)-VG; Source_U28; Manufacturer Part EL817S1(C)(TU)-VG

Connections:
+3V3: R22.1, R24.1, R26.1, R28.1; also elsewhere on the board
+24V_CTRL: U21.1, U22.1, U23.1; also elsewhere on the board
+24V_ESTOP_NC: R27.1, U24.1
BTN_CLOSE: C19.1, R26.2, U27.4 (C); also elsewhere on the board
BTN_CLOSE_LED: D12.1 (K), R25.2, U27.1 (A)
BTN_CLOSE_SW: R25.1, U23.2
BTN_OPEN: C17.1, R22.2, U25.4 (C); also elsewhere on the board
BTN_OPEN_LED: D10.1 (K), R21.2, U25.1 (A)
BTN_OPEN_SW: R21.1, U21.2
ESTOP_INTERLOCK: C20.1, R28.2, R37.1, U28.4 (C); also elsewhere on the board
ESTOP_LED: D13.1 (K), R27.2, U28.1 (A)
ESTOP_SENSE: R37.2; also elsewhere on the board
GND: C17.2, C18.2, C19.2, C20.2, D10.2 (A), D11.2 (A), D12.2 (A), D13.2 (A), U24.2, U25.2 (K), U25.3 (E), U26.2 (K), U26.3 (E), U27.2 (K), U27.3 (E), U28.2 (K), U28.3 (E); also elsewhere on the board
STOP_FAULT: R36.2; also elsewhere on the board
STOP_INTERLOCK: C18.1, R24.2, R36.1, U26.4 (C); also elsewhere on the board
STOP_NC_LED: D11.1 (K), R23.2, U26.1 (A)
STOP_NC_RET: R23.1, U22.2

Notes on the sheet:
STOP: red LAY711BN42 / NC
U24 senses relay coil command after E-stop NC; no main-contact welding feedback. Motor power is switched outside PCB.
CLOSE: black LAY711BN22 / NO
STOP uses NC: healthy LOW; pressed / broken wire HIGH. OPEN/CLOSE use NO.
E-STOP: external relay coil command
OPEN: green LAY711BN32 / NO

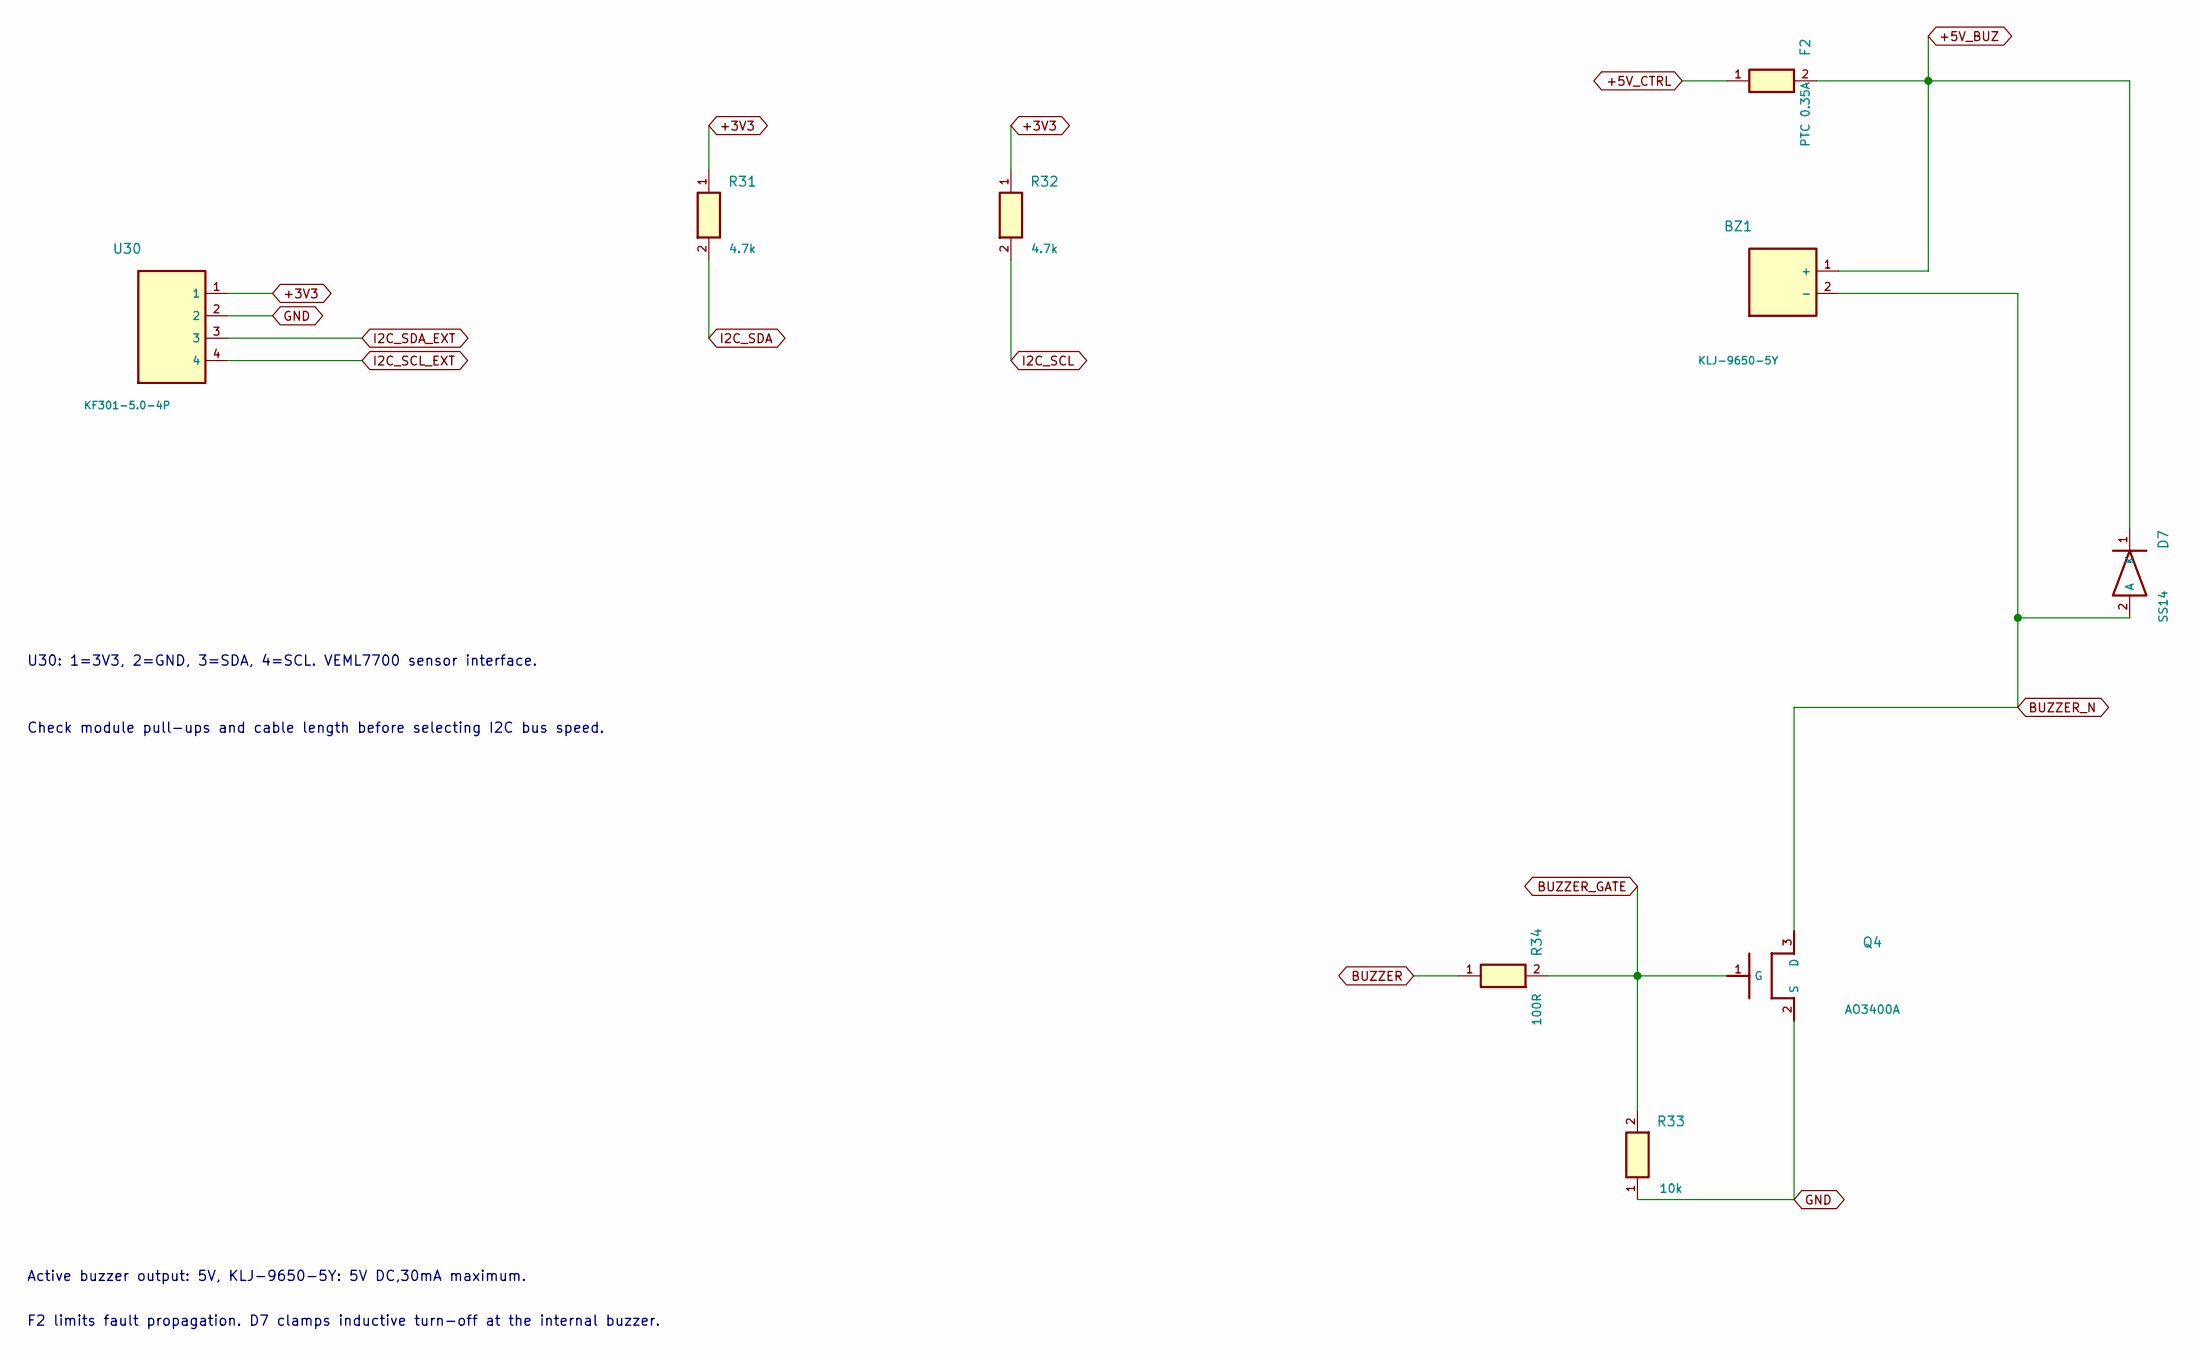
[picture p24: schematic auxiliary.kicad_sch, CurtainDrive V3.2 2L / I2C + buzzer]

Parts:
BZ1: KLJ-9650-5Y; KLJ_9650_5Y; Voltage Rating DC3–8V,5V nominal,30mA max; Manufacturer Part KLJ-9650-5Y
D7: SS14; D_SMA; Voltage Rating 40V / 1A; Manufacturer Part SS14
F2: PTC 0.35A; Fuse_1206_3216Metric; Voltage Rating 16V / hold0.35A / trip0.75A; Manufacturer Part 1206L035/16YR
Q4: AO3400A; SOT-23; Voltage Rating 30V / Rds(max)48mOhm@2.5V; Manufacturer Part AO3400A
R31, R32: 4.7k; R_1210_3225Metric; Voltage Rating 5% / 0.5W; Manufacturer Part 1210W2J0472T5E
R33: 10k; R_0603_1608Metric; Voltage Rating 1% / 0.1W; Manufacturer Part 0603WAF1002T5E
R34: 100R; R_0603_1608Metric; Voltage Rating 1% / 0.1W; Manufacturer Part 0603WAF1000T5E
U30: KF301-5.0-4P; KF301_5_0_4P; Manufacturer Part KF301-5.0-4P

Connections:
+3V3: R31.1, R32.1, U30.1; also elsewhere on the board
+5V_BUZ: BZ1.1 (+), D7.1 (K), F2.2; also elsewhere on the board
+5V_CTRL: F2.1; also elsewhere on the board
BUZZER: R34.1; also elsewhere on the board
BUZZER_GATE: Q4.1 (G), R33.2, R34.2
BUZZER_N: BZ1.2 (-), D7.2 (A), Q4.3 (D)
GND: Q4.2 (S), R33.1, U30.2; also elsewhere on the board
I2C_SCL: R32.2; also elsewhere on the board
I2C_SCL_EXT: U30.4; also elsewhere on the board
I2C_SDA: R31.2; also elsewhere on the board
I2C_SDA_EXT: U30.3; also elsewhere on the board

Notes on the sheet:
Check module pull-ups and cable length before selecting I2C bus speed.
U30: 1=3V3, 2=GND, 3=SDA, 4=SCL. VEML7700 sensor interface.
F2 limits fault propagation. D7 clamps inductive turn-off at the internal buzzer.
Active buzzer output: 5V, KLJ-9650-5Y: 5V DC,30mA maximum.

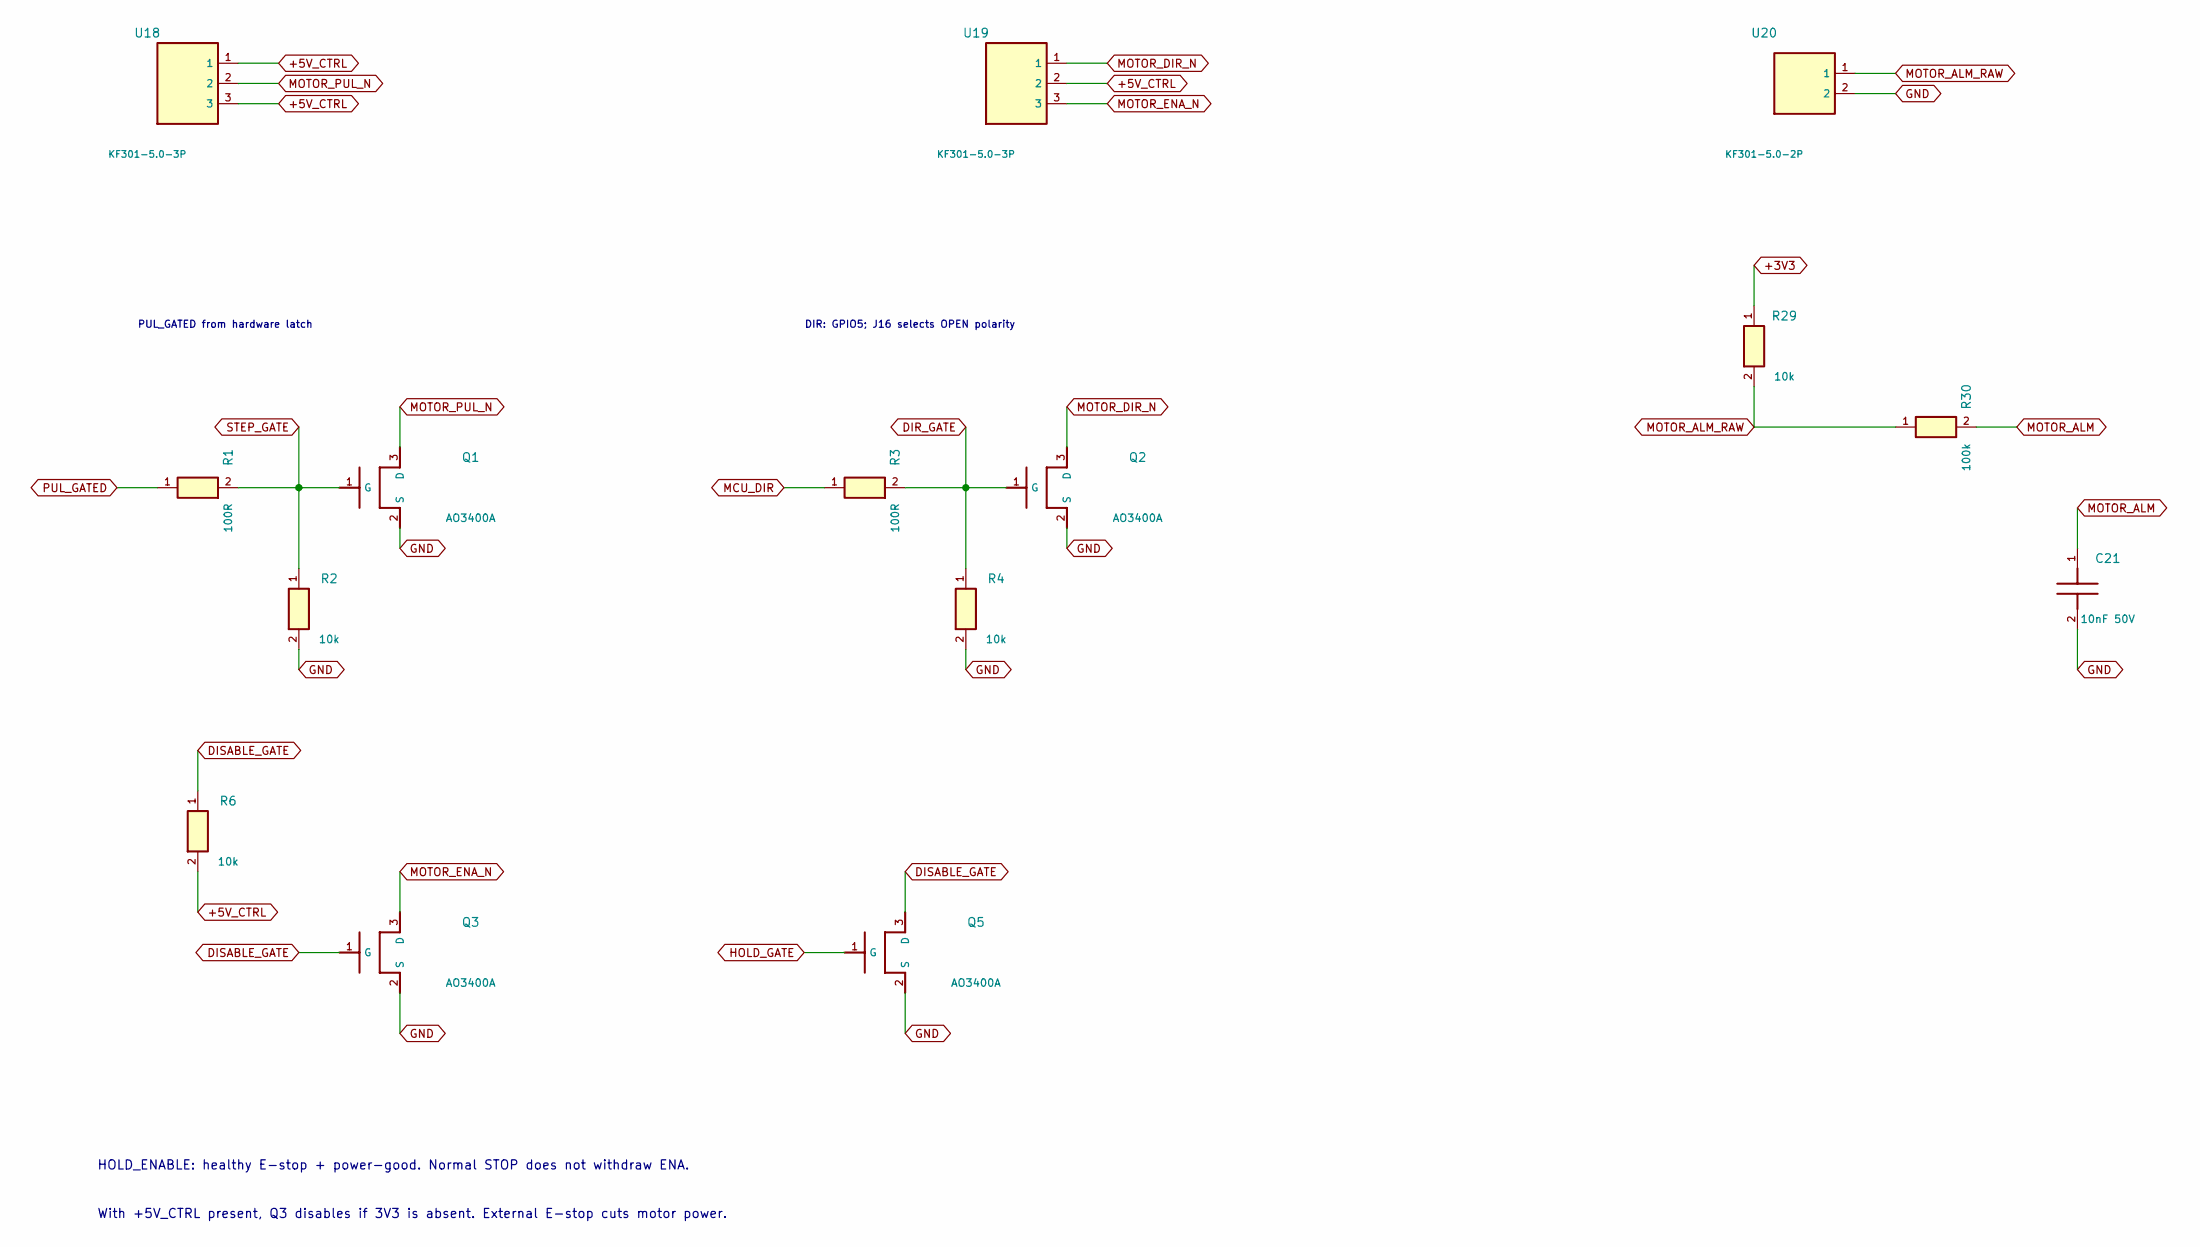
[picture p25: schematic motor.kicad_sch, CurtainDrive V3.2 2L / Driver + HOLD]

Parts:
C21: 10nF 50V; C_0603_1608Metric; Voltage Rating 50V / X7R / 10%; Manufacturer Part 0603B103K500NT
Q1, Q2, Q3: AO3400A; SOT-23; Voltage Rating 30V / Rds(max)48mOhm@2.5V; Manufacturer Part AO3400A
Q5: AO3400A; SOT-23; Voltage Rating 30V / Vgs +/-12V; Manufacturer Part AO3400A
R1, R3: 100R; R_0603_1608Metric; Voltage Rating 1% / 0.1W; Manufacturer Part 0603WAF1000T5E
R2, R4, R6, R29: 10k; R_0603_1608Metric; Voltage Rating 1% / 0.1W; Manufacturer Part 0603WAF1002T5E
R30: 100k; R_1210_3225Metric; Voltage Rating 1% / 0.5W; Manufacturer Part RC1210FR-07100KL
U18: KF301-5.0-3P; Source_U18; Manufacturer Part KF301-5.0-3P
U19: KF301-5.0-3P; Source_U19; Manufacturer Part KF301-5.0-3P
U20: KF301-5.0-2P; Source_J1; Manufacturer Part KF301-5.0-2P

Connections:
+3V3: R29.1; also elsewhere on the board
+5V_CTRL: R6.2, U18.1, U18.3, U19.2; also elsewhere on the board
DIR_GATE: Q2.1 (G), R3.2, R4.1
DISABLE_GATE: Q3.1 (G), Q5.3 (D), R6.1
GND: C21.2, Q1.2 (S), Q2.2 (S), Q3.2 (S), Q5.2 (S), R2.2, R4.2, U20.2; also elsewhere on the board
HOLD_GATE: Q5.1 (G); also elsewhere on the board
MCU_DIR: R3.1; also elsewhere on the board
MOTOR_ALM: C21.1, R30.2; also elsewhere on the board
MOTOR_ALM_RAW: R29.2, R30.1, U20.1; also elsewhere on the board
MOTOR_DIR_N: Q2.3 (D), U19.1
MOTOR_ENA_N: Q3.3 (D), U19.3
MOTOR_PUL_N: Q1.3 (D), U18.2
PUL_GATED: R1.1; also elsewhere on the board
STEP_GATE: Q1.1 (G), R1.2, R2.1

Notes on the sheet:
DIR: GPIO5; J16 selects OPEN polarity
With +5V_CTRL present, Q3 disables if 3V3 is absent. External E-stop cuts motor power.
HOLD_ENABLE: healthy E-stop + power-good. Normal STOP does not withdraw ENA.
PUL_GATED from hardware latch

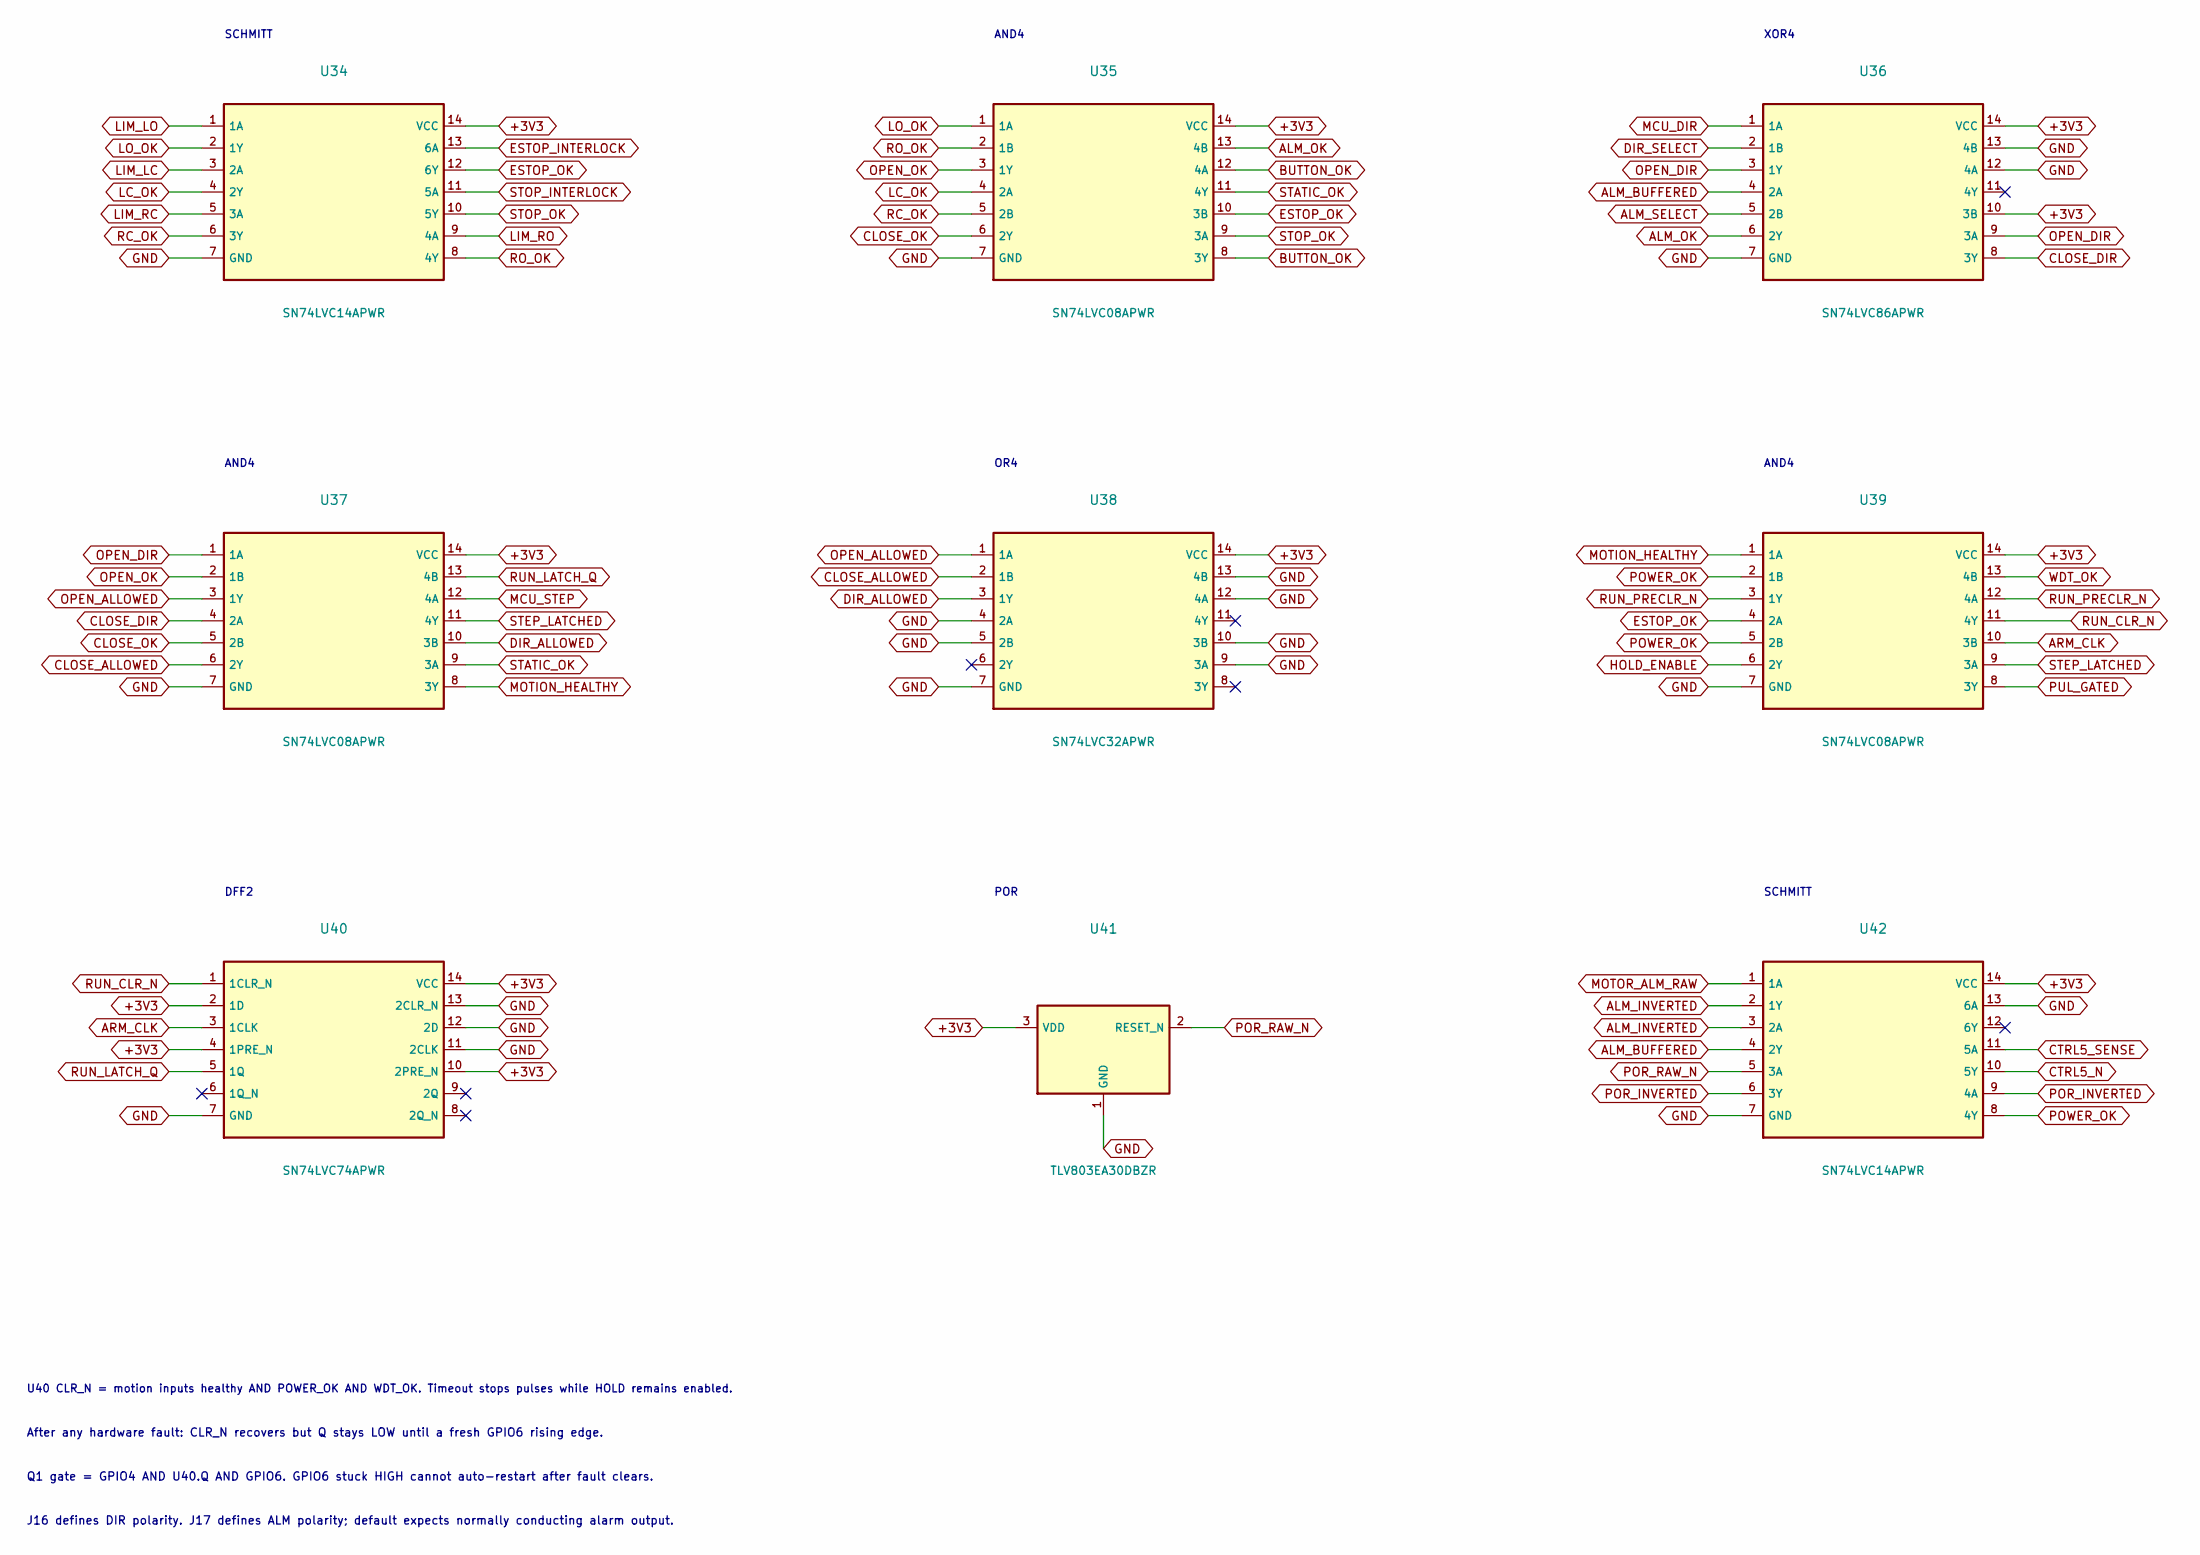
[picture p26: schematic interlock.kicad_sch, CurtainDrive V3.2 2L / STOP + direction]

Parts:
U34, U42: SN74LVC14APWR; TSSOP-14_4.4x5mm_P0.65mm; Voltage Rating 3.3V logic; check exact manufacturer pa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; Manufacturer Part SN74LVC14APWR
U35, U37, U39: SN74LVC08APWR; TSSOP-14_4.4x5mm_P0.65mm; Voltage Rating 3.3V logic; check exact manufacturer pa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; Manufacturer Part SN74LVC08APWR
U36: SN74LVC86APWR; TSSOP-14_4.4x5mm_P0.65mm; Voltage Rating 3.3V logic; check exact manufacturer pa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; Manufacturer Part SN74LVC86APWR
U38: SN74LVC32APWR; TSSOP-14_4.4x5mm_P0.65mm; Voltage Rating 3.3V logic; check exact manufacturer pa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; Manufacturer Part SN74LVC32APWR
U40: SN74LVC74APWR; TSSOP-14_4.4x5mm_P0.65mm; Voltage Rating 3.3V logic; check exact manufacturer pa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; Manufacturer Part SN74LVC74APWR
U41: TLV803EA30DBZR; SOT-23; Voltage Rating 3.08V nominal falling threshold; minimu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; Manufacturer Part TLV803EA30DBZR

Connections:
+3V3: U34.14 (VCC), U35.14 (VCC), U36.10 (3B), U36.14 (VCC), U37.14 (VCC), U38.14 (VCC), U39.14 (VCC), U40.2 (1D), U40.4 (1PRE_N), U40.10 (2PRE_N), U40.14 (VCC), U41.3 (VDD), U42.14 (VCC); also elsewhere on the board
ALM_BUFFERED: U36.4 (2A), U42.4 (2Y)
ALM_INVERTED: U42.2 (1Y), U42.3 (2A)
ALM_OK: U35.13 (4B), U36.6 (2Y)
ALM_SELECT: U36.5 (2B); also elsewhere on the board
ARM_CLK: U39.10 (3B), U40.3 (1CLK); also elsewhere on the board
BUTTON_OK: U35.8 (3Y), U35.12 (4A)
CLOSE_ALLOWED: U37.6 (2Y), U38.2 (1B)
CLOSE_DIR: U36.8 (3Y), U37.4 (2A)
CLOSE_OK: U35.6 (2Y), U37.5 (2B)
CTRL5_N: U42.10 (5Y); also elsewhere on the board
CTRL5_SENSE: U42.11 (5A); also elsewhere on the board
DIR_ALLOWED: U37.10 (3B), U38.3 (1Y)
DIR_SELECT: U36.2 (1B); also elsewhere on the board
ESTOP_INTERLOCK: U34.13 (6A); also elsewhere on the board
ESTOP_OK: U34.12 (6Y), U35.10 (3B), U39.4 (2A)
GND: U34.7 (GND), U35.7 (GND), U36.7 (GND), U36.12 (4A), U36.13 (4B), U37.7 (GND), U38.4 (2A), U38.5 (2B), U38.7 (GND), U38.9 (3A), U38.10 (3B), U38.12 (4A), U38.13 (4B), U39.7 (GND), U40.7 (GND), U40.11 (2CLK), U40.12 (2D), U40.13 (2CLR_N), U41.1 (GND), U42.7 (GND), U42.13 (6A); also elsewhere on the board
HOLD_ENABLE: U39.6 (2Y); also elsewhere on the board
LC_OK: U34.4 (2Y), U35.4 (2A)
LIM_LC: U34.3 (2A); also elsewhere on the board
LIM_LO: U34.1 (1A); also elsewhere on the board
LIM_RC: U34.5 (3A); also elsewhere on the board
LIM_RO: U34.9 (4A); also elsewhere on the board
LO_OK: U34.2 (1Y), U35.1 (1A)
MCU_DIR: U36.1 (1A); also elsewhere on the board
MCU_STEP: U37.12 (4A); also elsewhere on the board
MOTION_HEALTHY: U37.8 (3Y), U39.1 (1A)
MOTOR_ALM_RAW: U42.1 (1A); also elsewhere on the board
OPEN_ALLOWED: U37.3 (1Y), U38.1 (1A)
OPEN_DIR: U36.3 (1Y), U36.9 (3A), U37.1 (1A)
OPEN_OK: U35.3 (1Y), U37.2 (1B)
POR_INVERTED: U42.6 (3Y), U42.9 (4A)
POR_RAW_N: U41.2 (RESET_N), U42.5 (3A); also elsewhere on the board
POWER_OK: U39.2 (1B), U39.5 (2B), U42.8 (4Y)
PUL_GATED: U39.8 (3Y); also elsewhere on the board
RC_OK: U34.6 (3Y), U35.5 (2B)
RO_OK: U34.8 (4Y), U35.2 (1B)
RUN_CLR_N: U39.11 (4Y), U40.1 (1CLR_N)
RUN_LATCH_Q: U37.13 (4B), U40.5 (1Q); also elsewhere on the board
RUN_PRECLR_N: U39.3 (1Y), U39.12 (4A)
STATIC_OK: U35.11 (4Y), U37.9 (3A)
STEP_LATCHED: U37.11 (4Y), U39.9 (3A)
STOP_INTERLOCK: U34.11 (5A); also elsewhere on the board
STOP_OK: U34.10 (5Y), U35.9 (3A)
WDT_OK: U39.13 (4B); also elsewhere on the board

Notes on the sheet:
AND4
U40 CLR_N = motion inputs healthy AND POWER_OK AND WDT_OK. Timeout stops pulses while HOLD remains enabled.
XOR4
POR
DFF2
SCHMITT
Q1 gate = GPIO4 AND U40.Q AND GPIO6. GPIO6 stuck HIGH cannot auto-restart after fault clears.
OR4
After any hardware fault: CLR_N recovers but Q stays LOW until a fresh GPIO6 rising edge.
J16 defines DIR polarity. J17 defines ALM polarity; default expects normally conducting alarm output.
