LLAB1234567890/PCB-/project/CurtainDrive_V3_2_2L.kicad_pcb

## KiCad design project/CurtainDrive_V3_2_2L.kicad_pcb (continued)

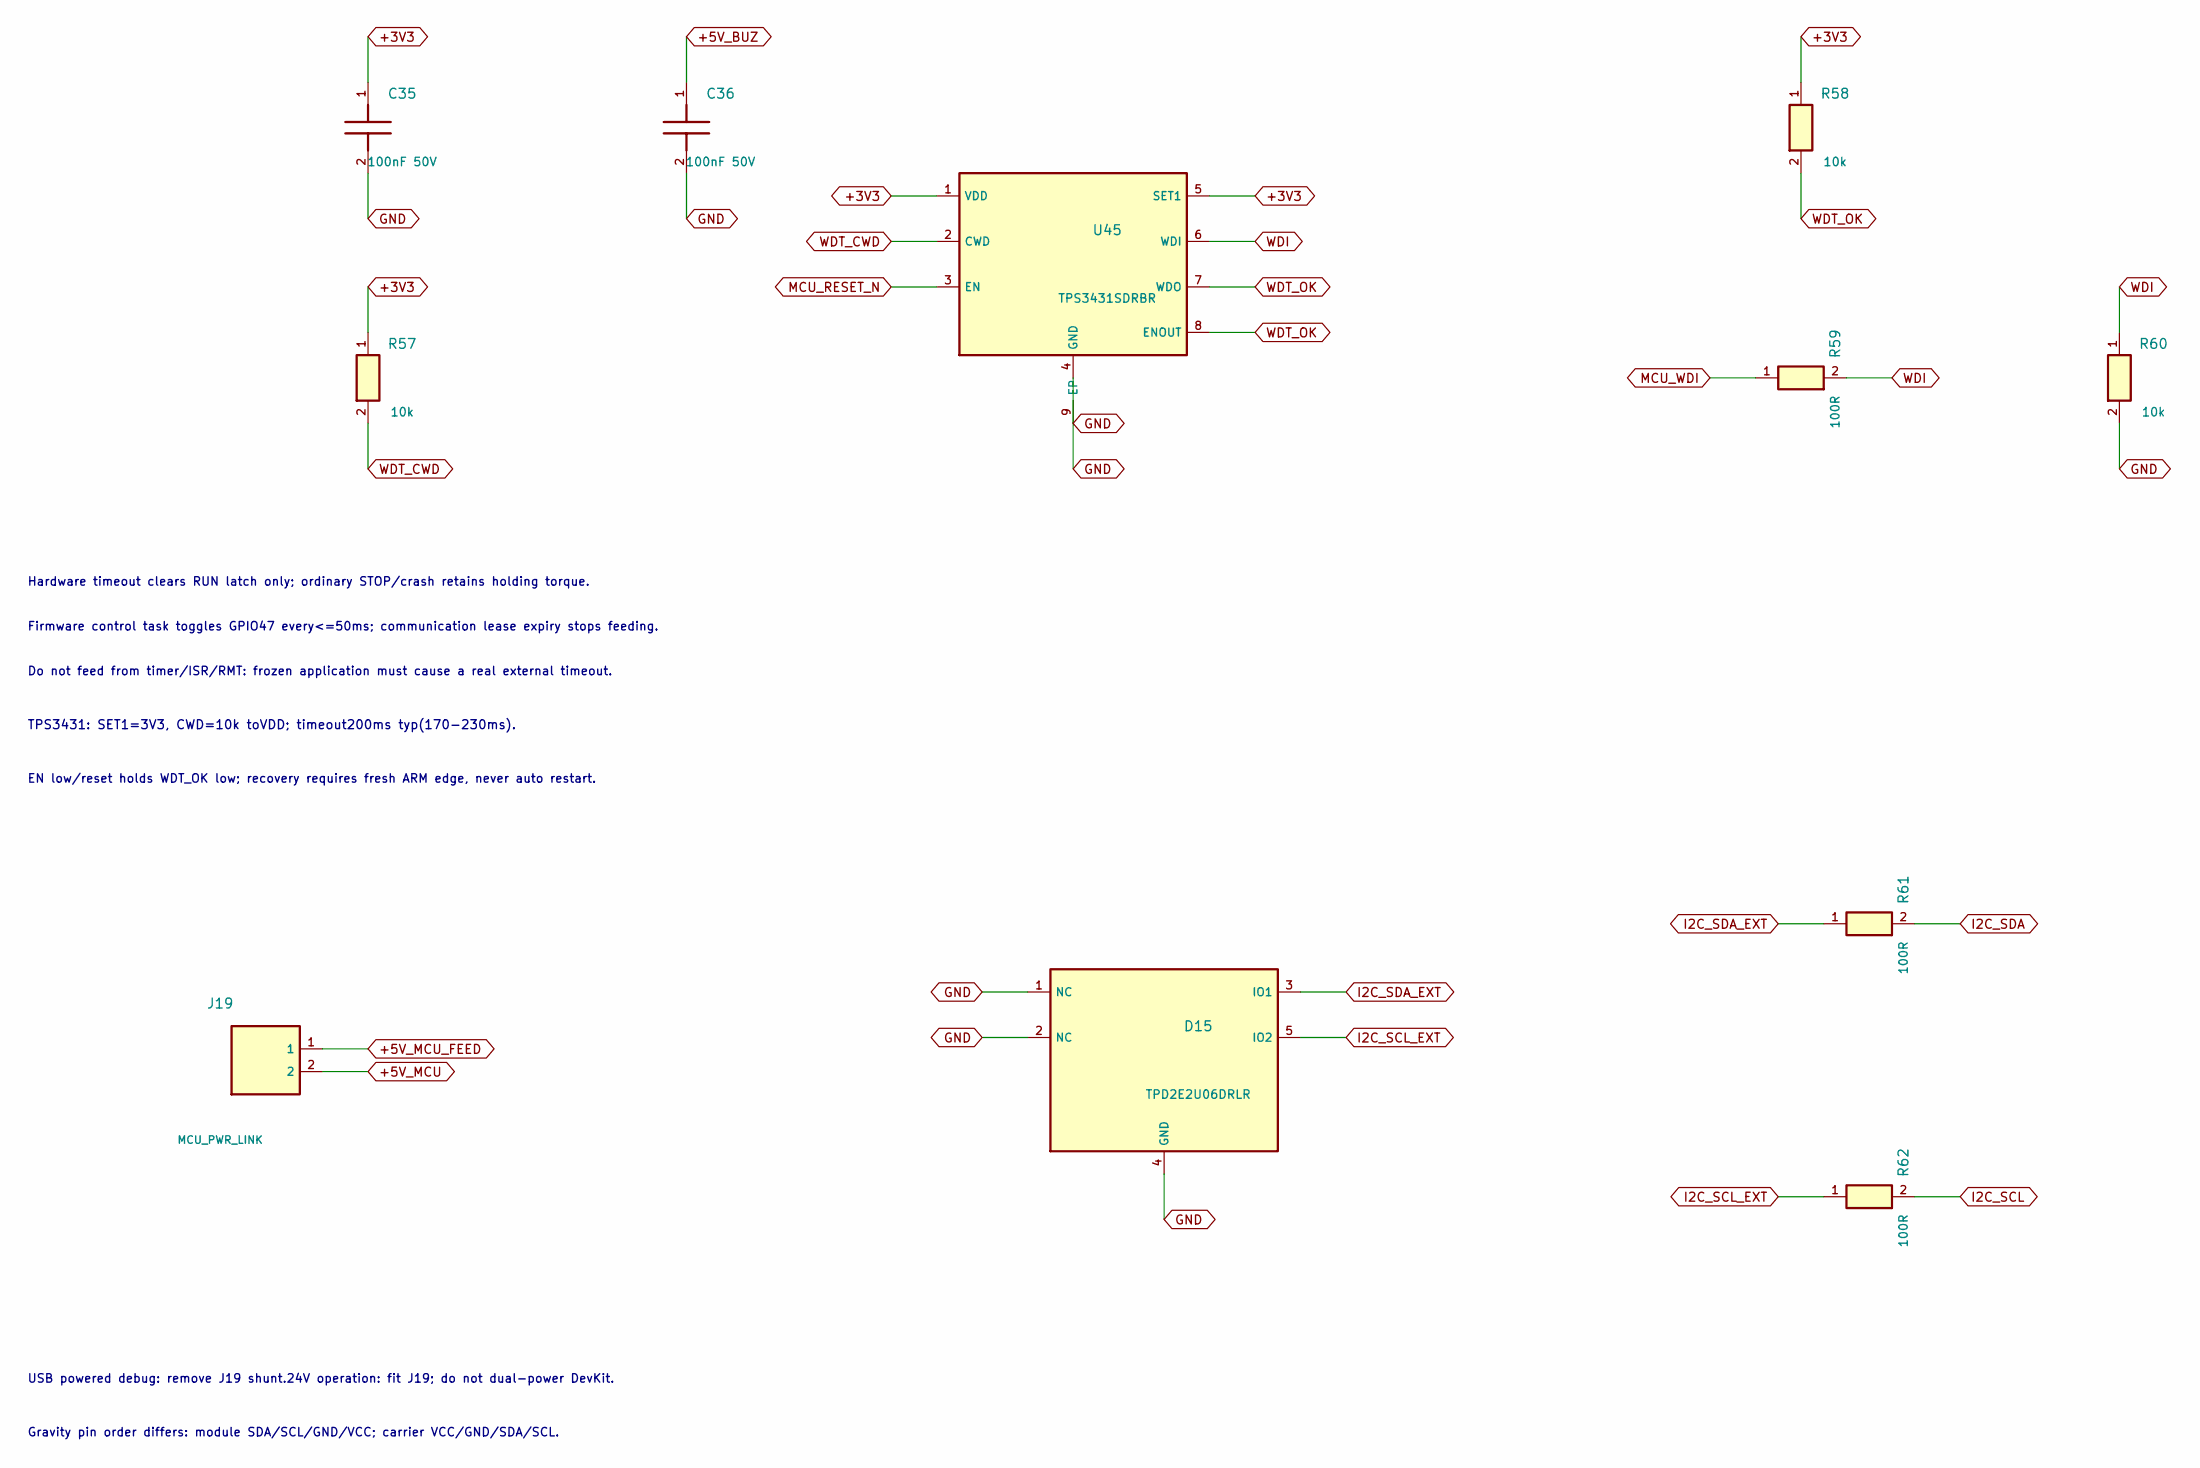
[picture p27: schematic watchdog.kicad_sch, CurtainDrive V3.2 2L / Watchdog + service]

Parts:
C35, C36: 100nF 50V; C_0603_1608Metric; Voltage Rating X7R50V; Manufacturer Part CC0603KRX7R9BB104
D15: TPD2E2U06DRLR; SOT-553; Voltage Rating 5.5V stand-off;1.5pF typ; dual ESD; Manufacturer Part TPD2E2U06DRLR
J19: MCU_PWR_LINK; PinHeader_1x02_P2.54mm_Vertical; Voltage Rating 2.54mm removable shunt; Manufacturer Part B-2100S02P-A110
R57, R58, R60: 10k; R_0603_1608Metric; Voltage Rating 1% /0.1W; Manufacturer Part 0603WAF1002T5E
R59, R61, R62: 100R; R_0603_1608Metric; Voltage Rating 1% /0.1W; Manufacturer Part 0603WAF1000T5E
U45: TPS3431SDRBR; Texas_DRB0008A; Voltage Rating 1.8–6.5V; watchdog active at3V3; Manufacturer Part TPS3431SDRBR

Connections:
+3V3: C35.1, R57.1, R58.1, U45.1 (VDD), U45.5 (SET1); also elsewhere on the board
+5V_BUZ: C36.1; also elsewhere on the board
+5V_MCU: J19.2; also elsewhere on the board
+5V_MCU_FEED: J19.1; also elsewhere on the board
GND: C35.2, C36.2, D15.1 (NC), D15.2 (NC), D15.4 (GND), R60.2, U45.4 (GND), U45.9 (EP); also elsewhere on the board
I2C_SCL: R62.2; also elsewhere on the board
I2C_SCL_EXT: D15.5 (IO2), R62.1; also elsewhere on the board
I2C_SDA: R61.2; also elsewhere on the board
I2C_SDA_EXT: D15.3 (IO1), R61.1; also elsewhere on the board
MCU_RESET_N: U45.3 (EN); also elsewhere on the board
MCU_WDI: R59.1; also elsewhere on the board
WDI: R59.2, R60.1, U45.6 (WDI)
WDT_CWD: R57.2, U45.2 (CWD)
WDT_OK: R58.2, U45.7 (WDO), U45.8 (ENOUT); also elsewhere on the board

Notes on the sheet:
Hardware timeout clears RUN latch only; ordinary STOP/crash retains holding torque.
Firmware control task toggles GPIO47 every<=50ms; communication lease expiry stops feeding.
Do not feed from timer/ISR/RMT: frozen application must cause a real external timeout.
EN low/reset holds WDT_OK low; recovery requires fresh ARM edge, never auto restart.
USB powered debug: remove J19 shunt.24V operation: fit J19; do not dual-power DevKit.
Gravity pin order differs: module SDA/SCL/GND/VCC; carrier VCC/GND/SDA/SCL.
TPS3431: SET1=3V3, CWD=10k toVDD; timeout200ms typ(170-230ms).

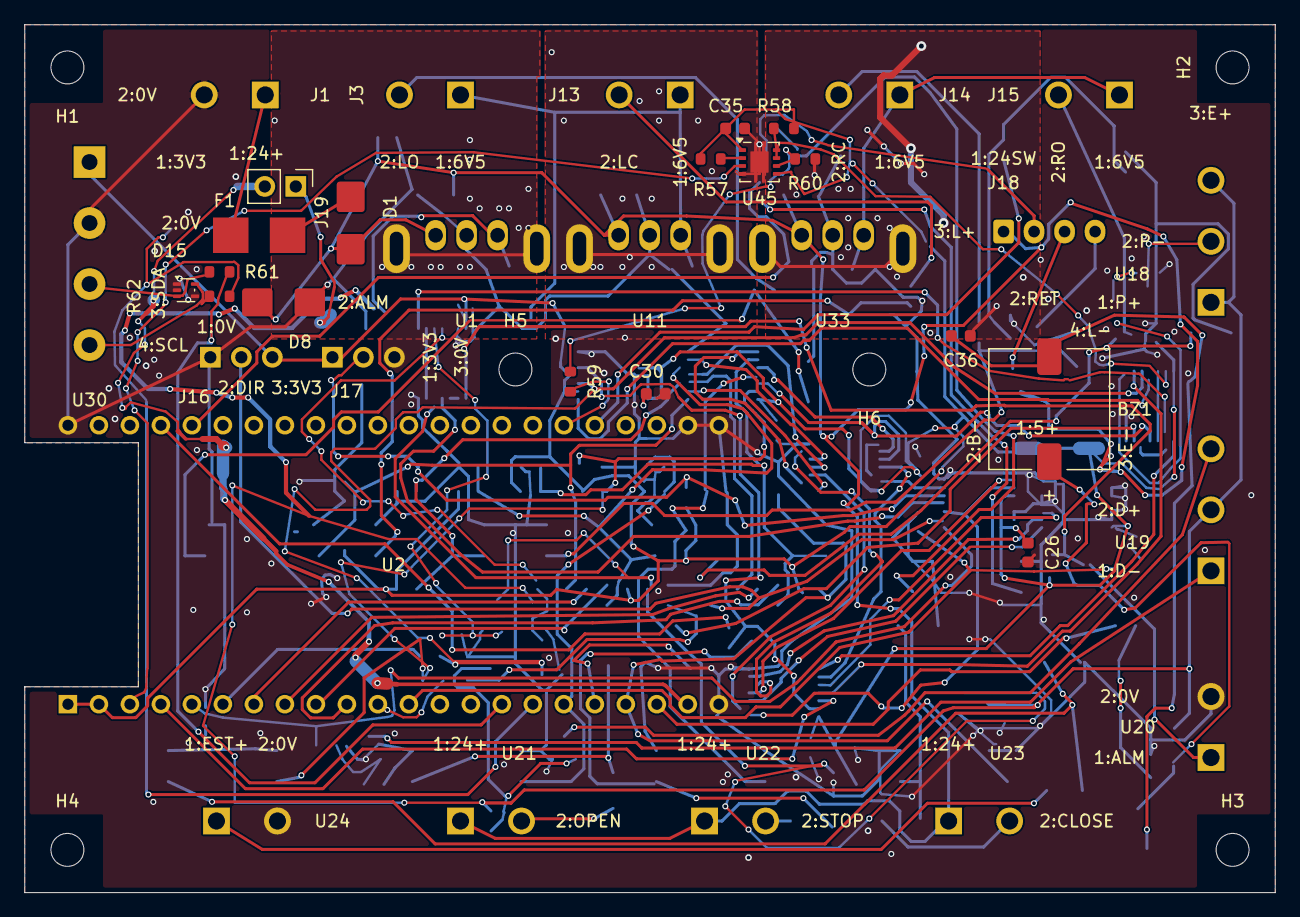
[picture p28: board CurtainDrive_V3_2_2L.kicad_pcb from above]

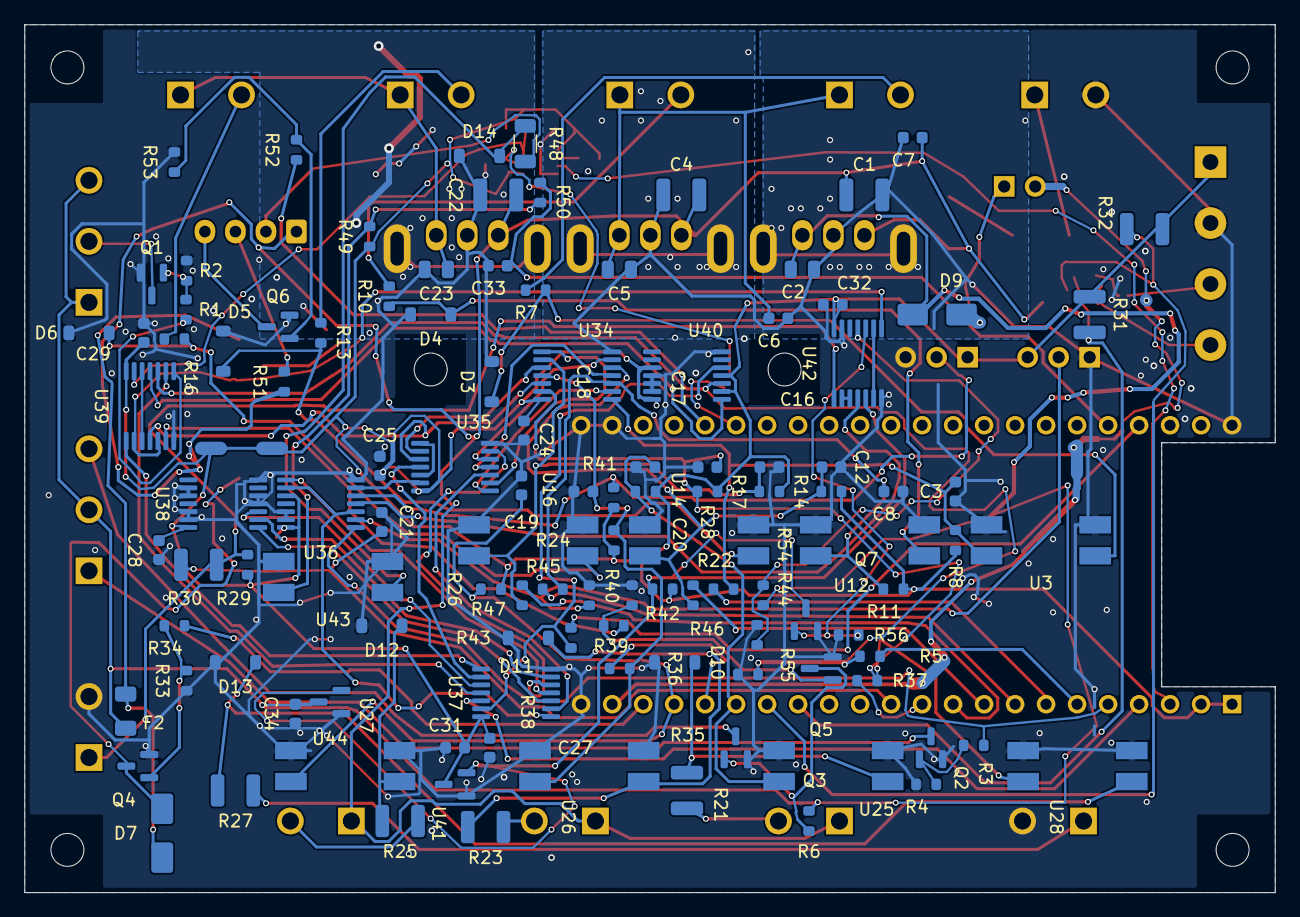
[picture p29: board CurtainDrive_V3_2_2L.kicad_pcb from below]

Board: 2 copper layers, 102.5 x 71.1 mm, 157 parts (114 on the bottom side), 110 nets.

Other parts of the board:
H1, H2, H3, H4, H5, H6: M2.5 NPTH; MountingHole_2.7mm_M2.5
